TheDenizhan/-HA-TEKNOFEST/KTR TASARIM/FOTO/DIŞ KABUK.PNG

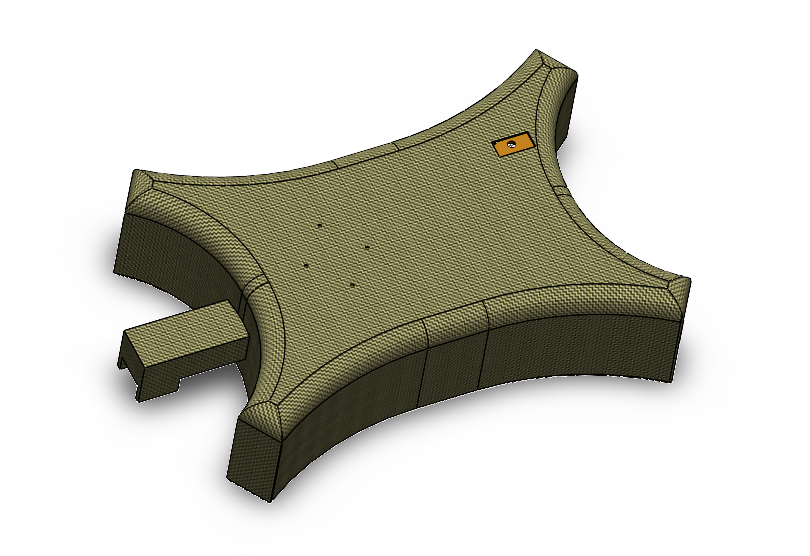
KTR TASARIM/FOTO/DIŞ KABUK.PNG
