TheDenizhan/-HA-TEKNOFEST/KTR TASARIM/FOTO/SS.PNG

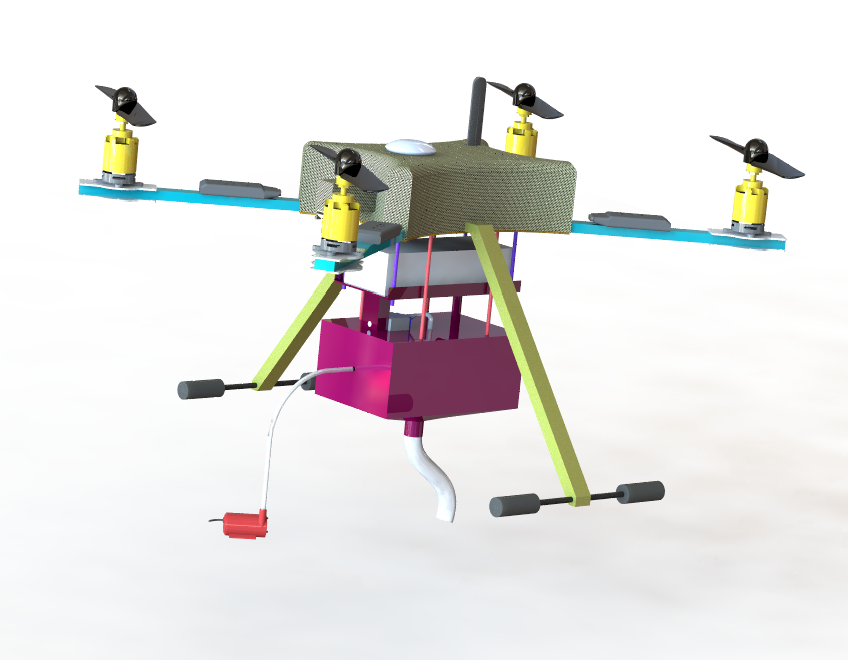
KTR TASARIM/FOTO/SS.PNG
