TheDenizhan/-HA-TEKNOFEST/KTR TASARIM/FOTO/KESİT GÖREV MEKANİZMASI.docx

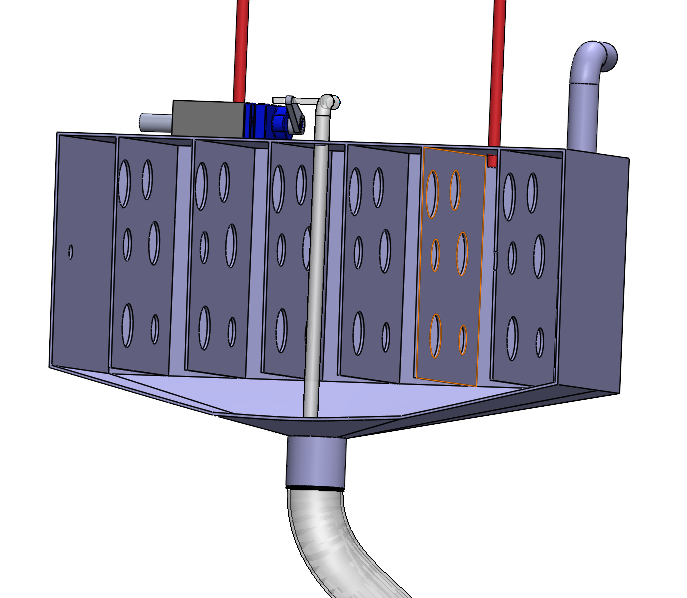
[picture p3: figure]

SU BOŞALTIM BOŞLUĞU

MİL

SU ALMA BOŞLUĞU

SERVO MOTOR

HAVA DELİĞİ

PERDE
