TheDenizhan/-HA-TEKNOFEST/İHA.pptx

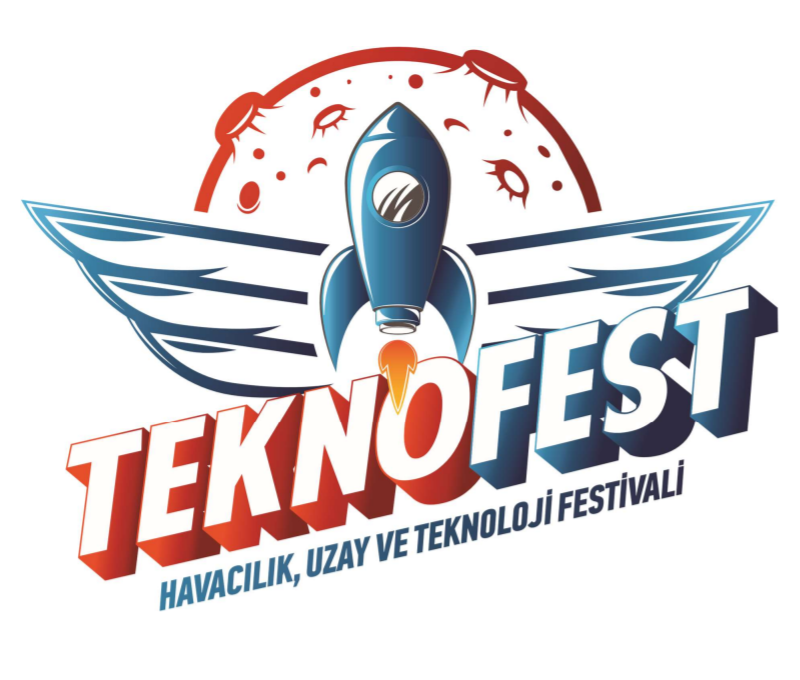
[picture p23: figure]

## Slide 2

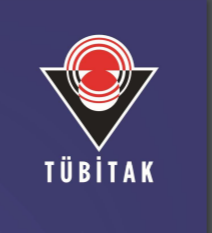
[picture p24: figure]

ULUSLARARASI İNSANSIZ HAVA ARAÇLARI YARIŞMASI

## Slide 3

1.YARIŞMA TAKVİMİ

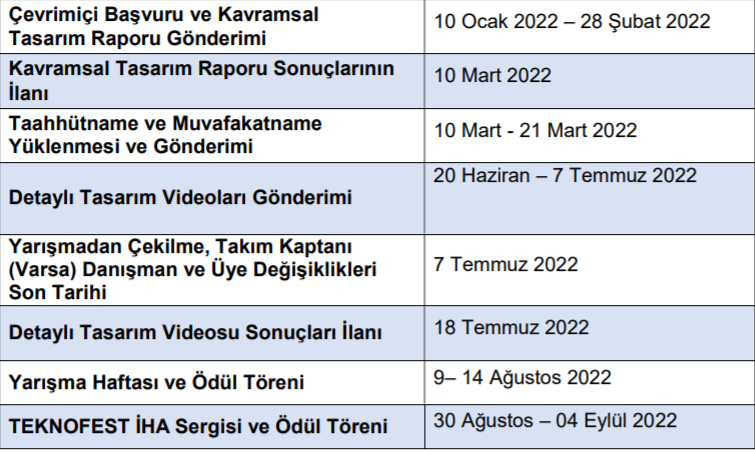
[picture p25: figure]

## DÖNER KANATLI İNSANSIZ HAVA ARACI

## Slide 5

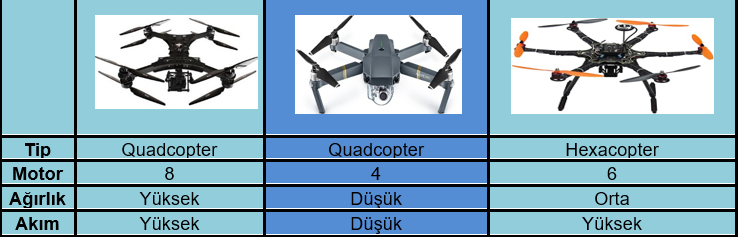
[picture p26: figure]

## görevler

## Görev süreleri: 1.Hazırlık süresi her görev için en fazla üç (3) dakika 2.Görev-1 için beş (5) dakika 3.Görev-2 için yedi (7) dakika olarak belirlenmiştir.

## Slide 8

1.GÖREV

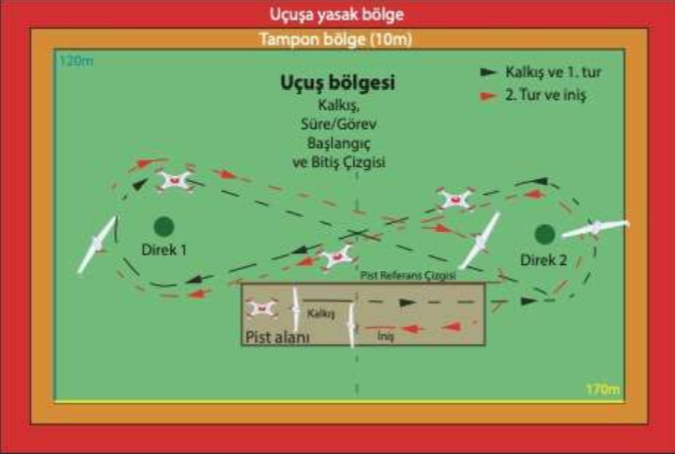
[picture p27: figure]
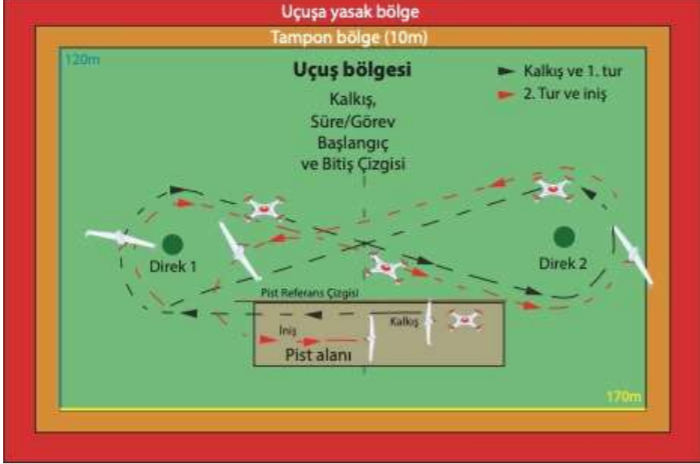
[picture p28: figure]

## Slide 9

2. GÖREV

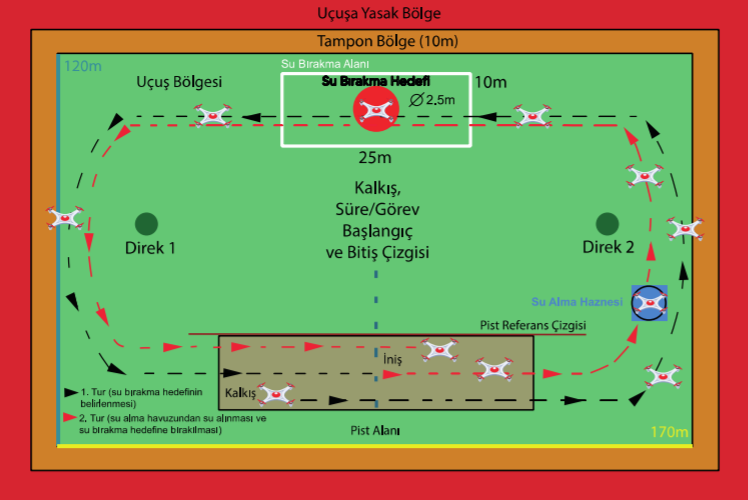
[picture p29: figure]
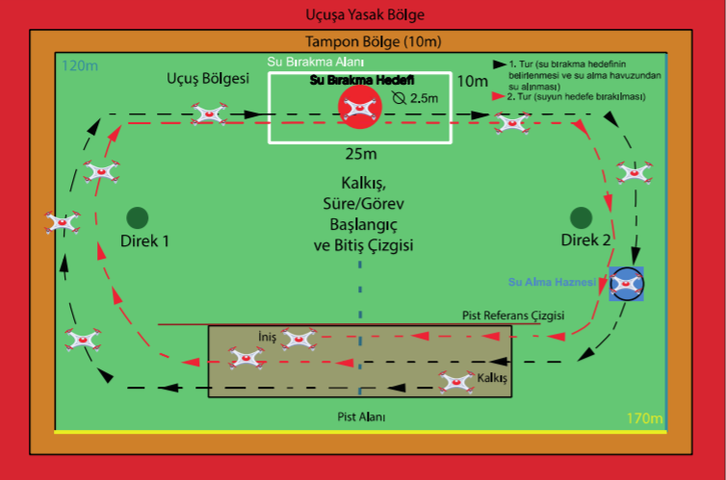
[picture p30: figure]

## puanlama

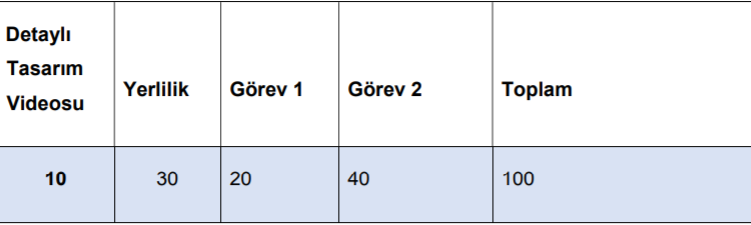
[picture p31: figure]

## Slide 11

Yerlilik ödülünün değerlendirilmesi için dört (4) ana başlık bulunur. Bunlar;
1. Oto Pilot Kart tasarımı ve Yazılımı
2. Kumanda Tasarımı ve Yazılımı
3. ESC Donanım Tasarımı ve Yazılımı
4. Fırçasız (Brushless) Elektrikli Motor Tasarımı ve Uygulaması

## Takım içi görevler

1. TAKIM KAPTANI
2. DANIŞMAN
3. TAKIM KAPTANI DAHİL EN AZ 3 TAKIM ÜYESİ İLE SATIN ALMA EKİBİ

YAPILACAK İŞLER

1. DRONE TASARIMI
2. ALINACAK,KULLANILACAK MALZEMELERİN BELİRLEME
3. YAZILIM
4. DEVRE TASARIMI
5. ÜRÜN SATIN ALMA
