TheDenizhan/-HA-TEKNOFEST/KTR TASARIM/FOTO/pompa.docx

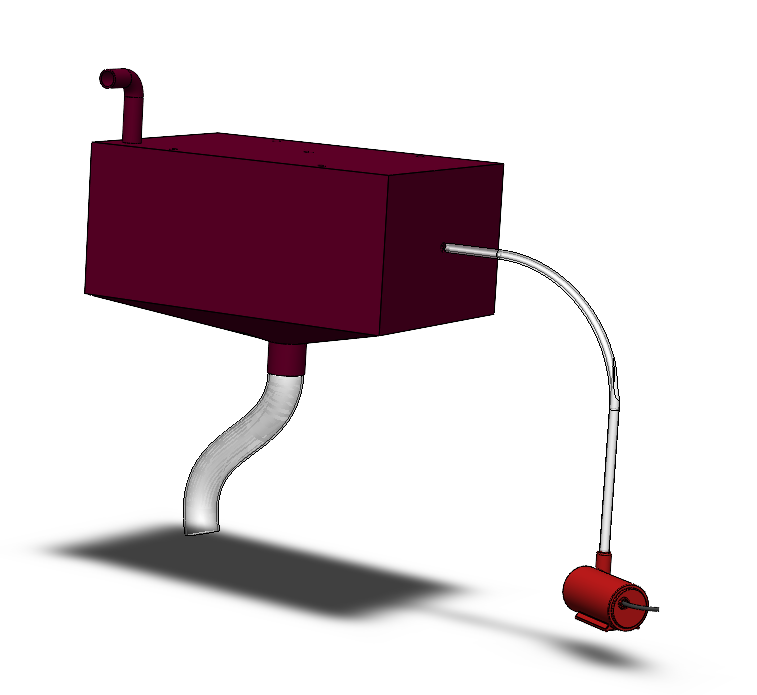
[picture p32: figure]

Su Giriş Borusu

Su Pompası

Su Tahliye Borusu
