TheDenizhan/-HA-TEKNOFEST/İHA Malzeme listesi/ABS++ FİLAMENT.png

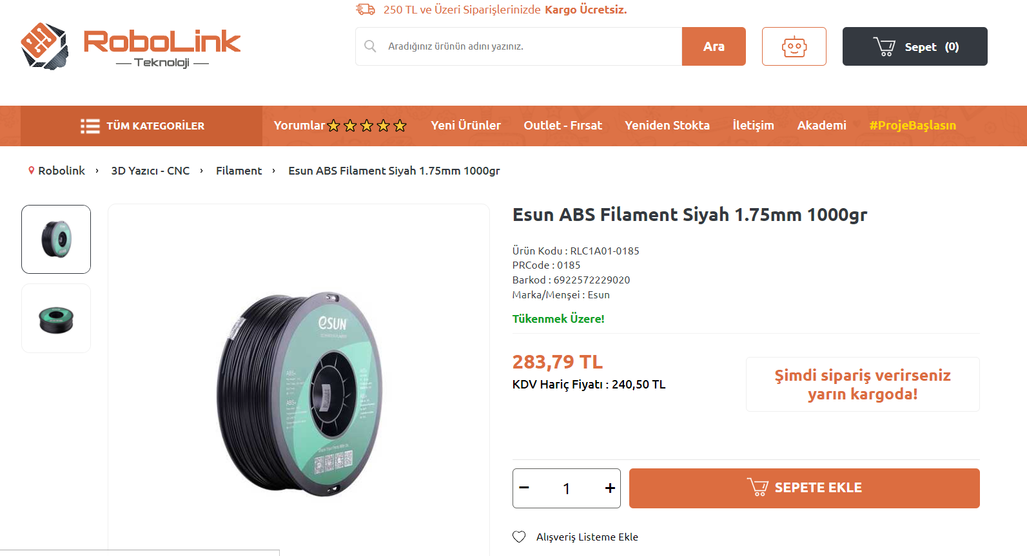
İHA Malzeme listesi/ABS++ FİLAMENT.png
