TheDenizhan/-HA-TEKNOFEST/İHA Malzeme listesi/ARDUNİO NANO.png

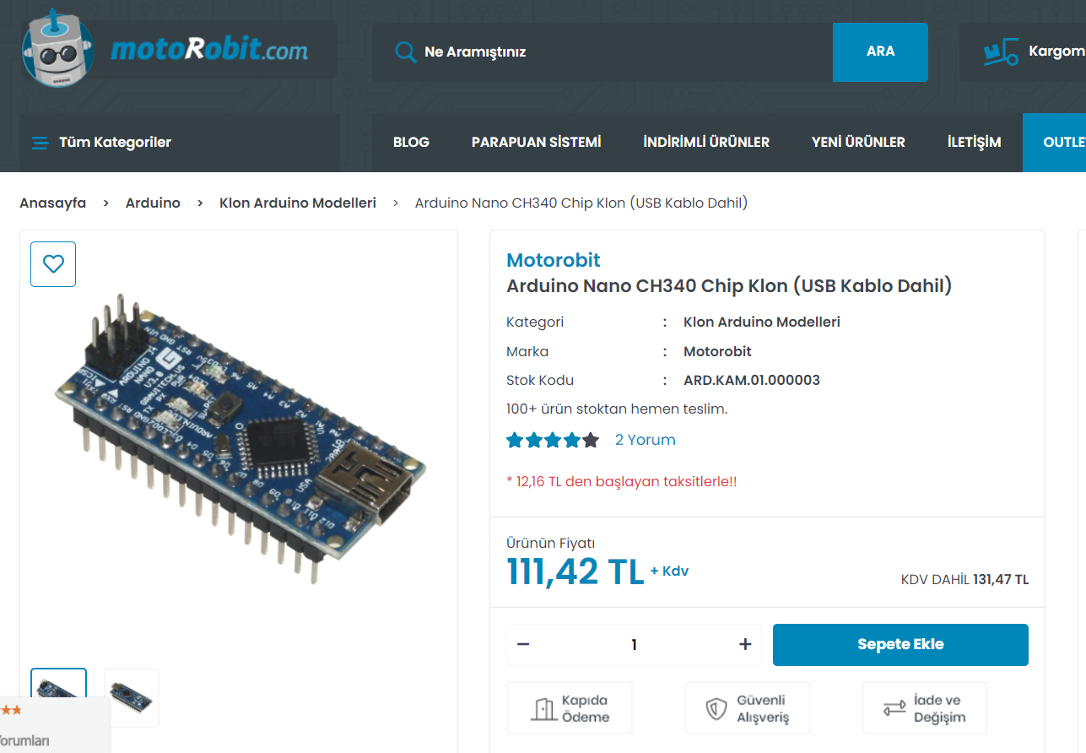
İHA Malzeme listesi/ARDUNİO NANO.png
