TheDenizhan/-HA-TEKNOFEST/İHA Malzeme listesi/ATMEGA2560.png

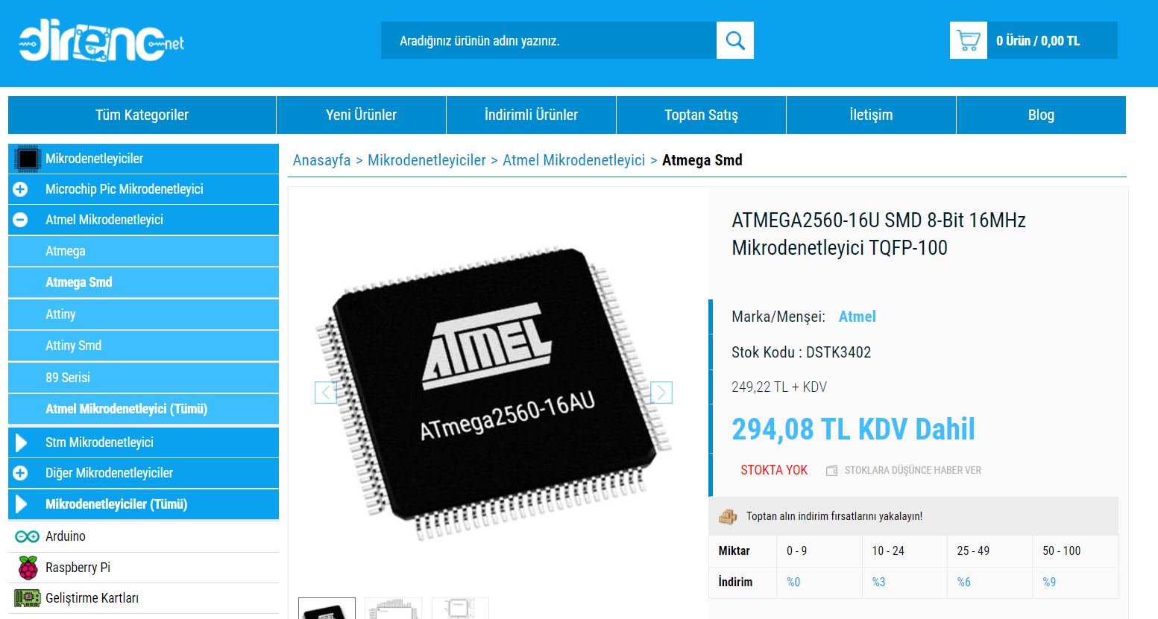
İHA Malzeme listesi/ATMEGA2560.png
