TheDenizhan/-HA-TEKNOFEST/İHA Malzeme listesi/BASINÇ SENSÖRÜ.png

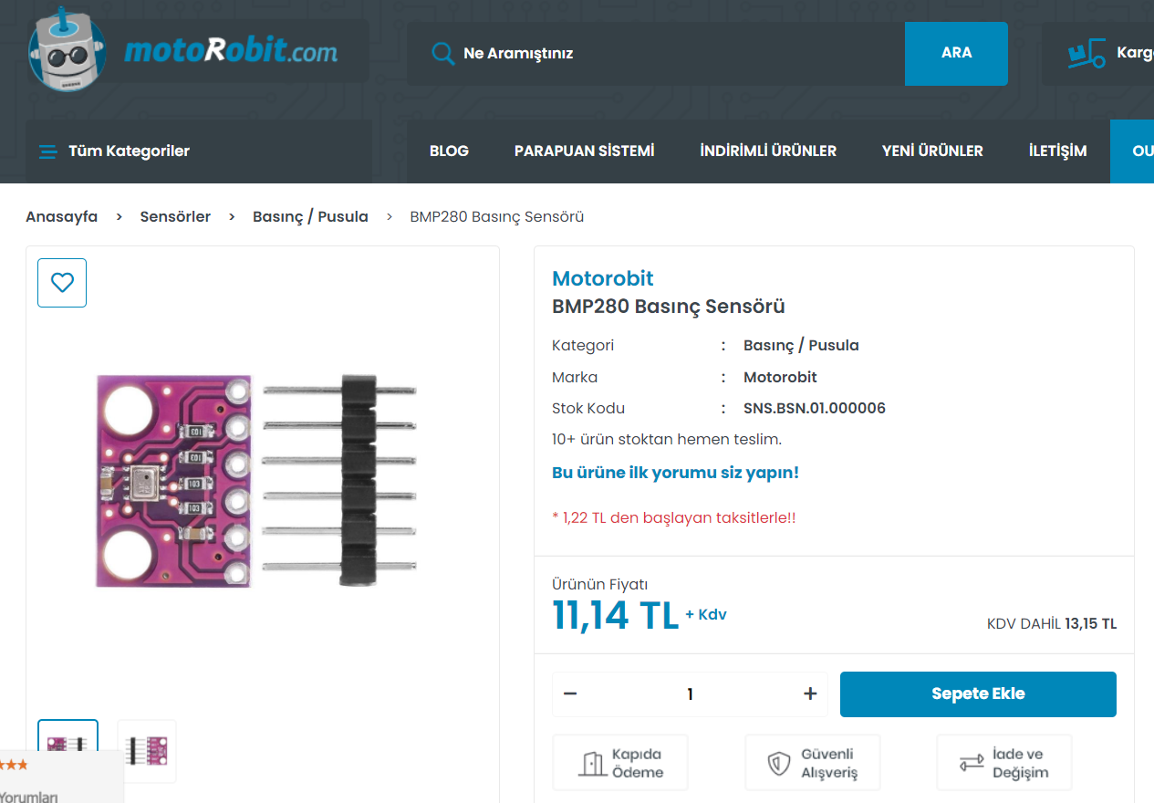
İHA Malzeme listesi/BASINÇ SENSÖRÜ.png
