TheDenizhan/-HA-TEKNOFEST/İHA Malzeme listesi/ESC.png

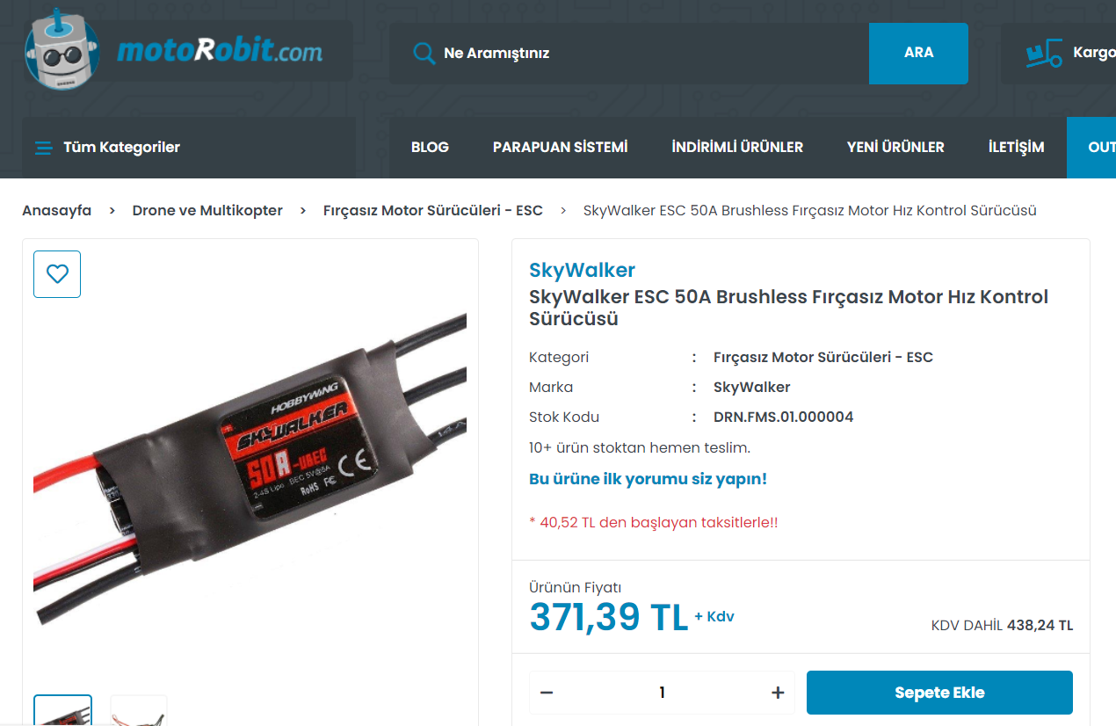
İHA Malzeme listesi/ESC.png
