TheDenizhan/-HA-TEKNOFEST/İHA Malzeme listesi/GPS.png

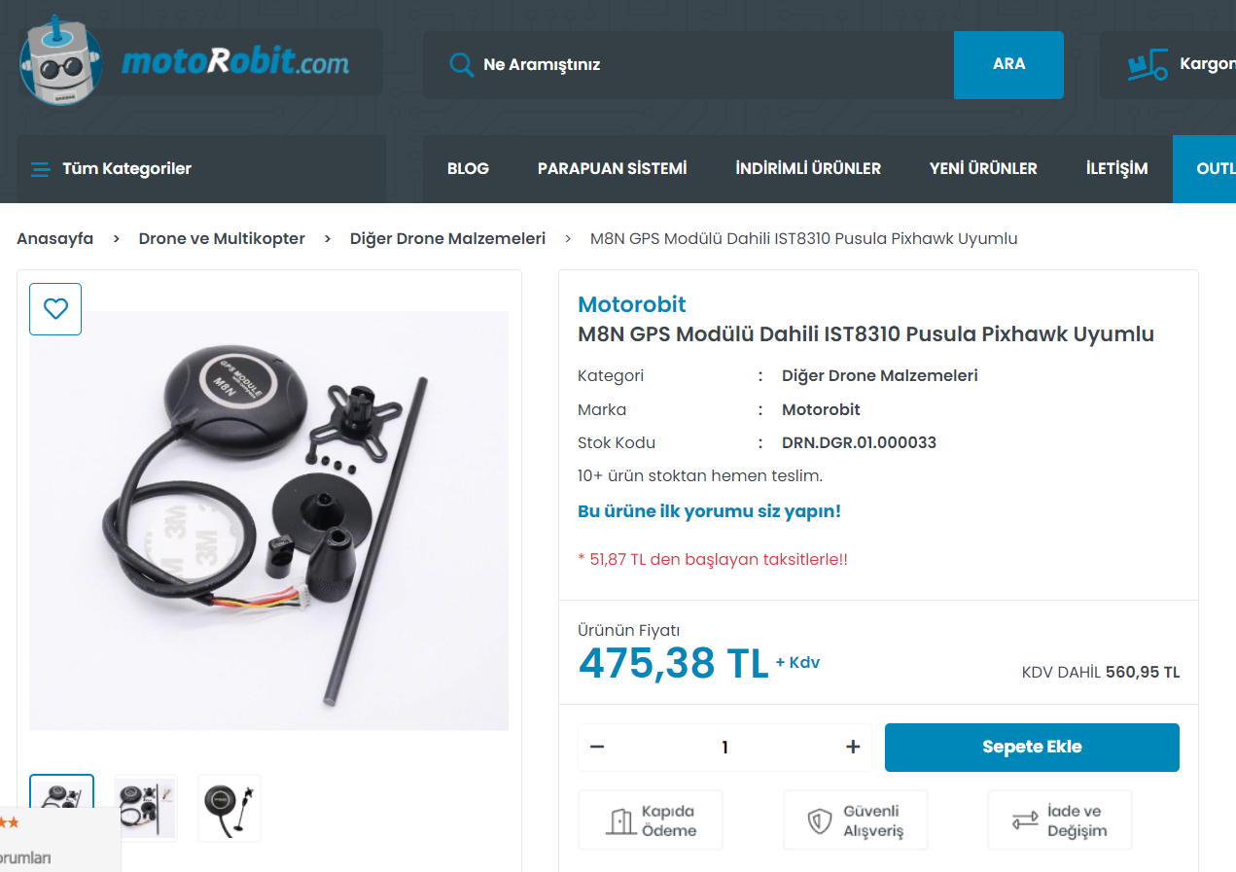
İHA Malzeme listesi/GPS.png
