TheDenizhan/-HA-TEKNOFEST/İHA Malzeme listesi/GYRO.png

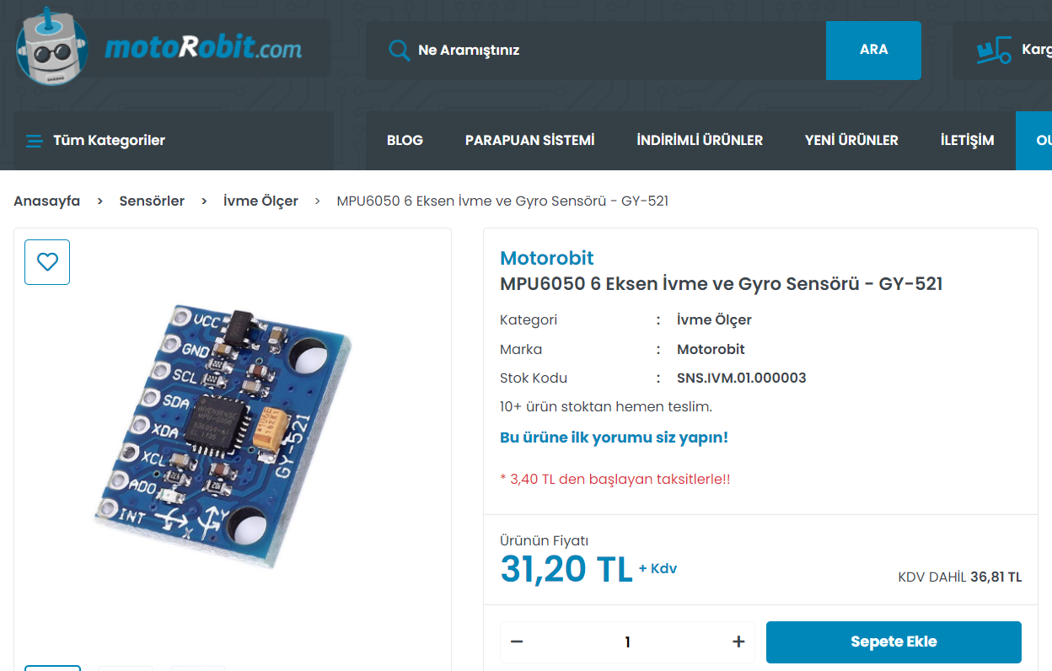
İHA Malzeme listesi/GYRO.png
