TheDenizhan/-HA-TEKNOFEST/İHA Malzeme listesi/GÜÇ DAĞITIM KARTI.png

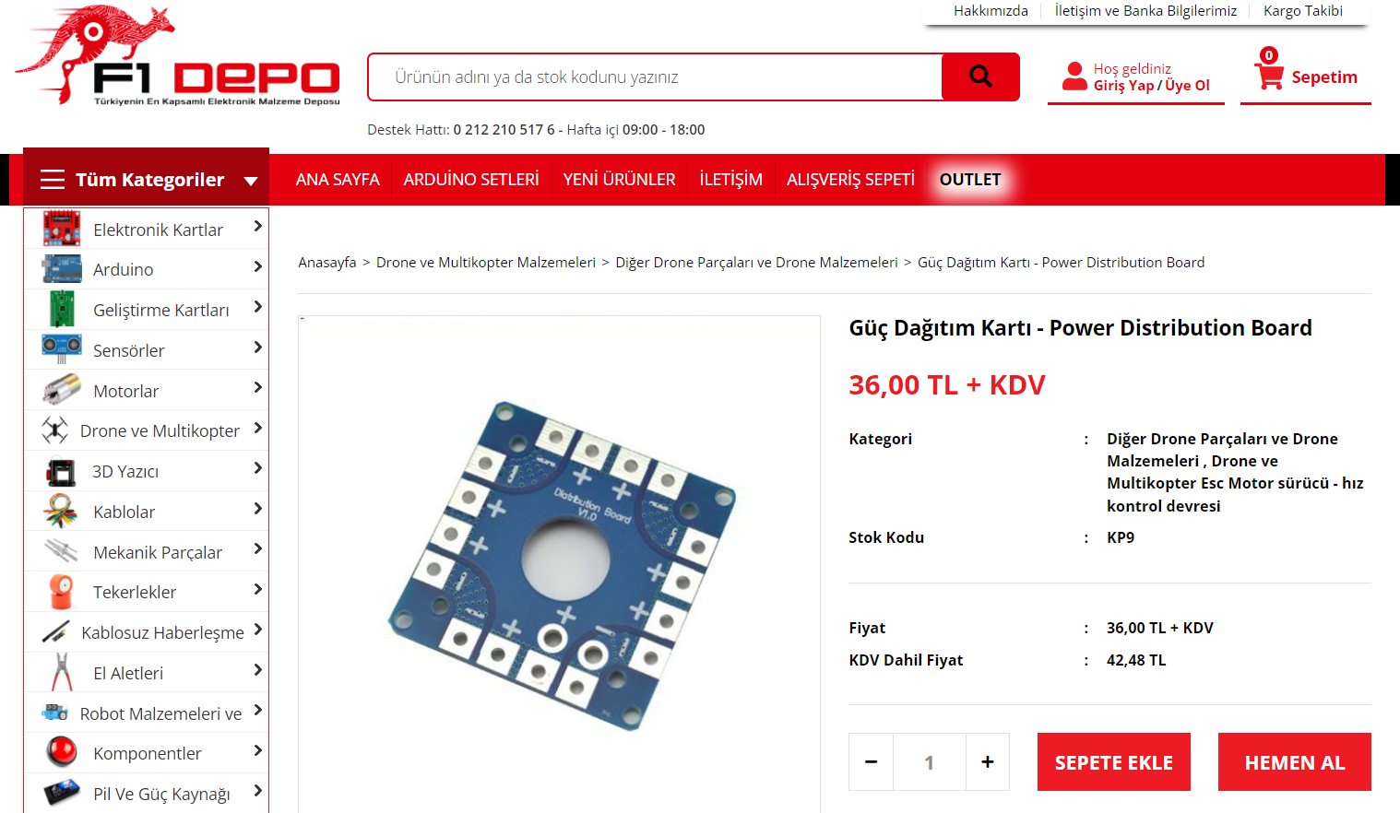
İHA Malzeme listesi/GÜÇ DAĞITIM KARTI.png
