TheDenizhan/-HA-TEKNOFEST/İHA Malzeme listesi/KARBONFİBER PLAKA.png

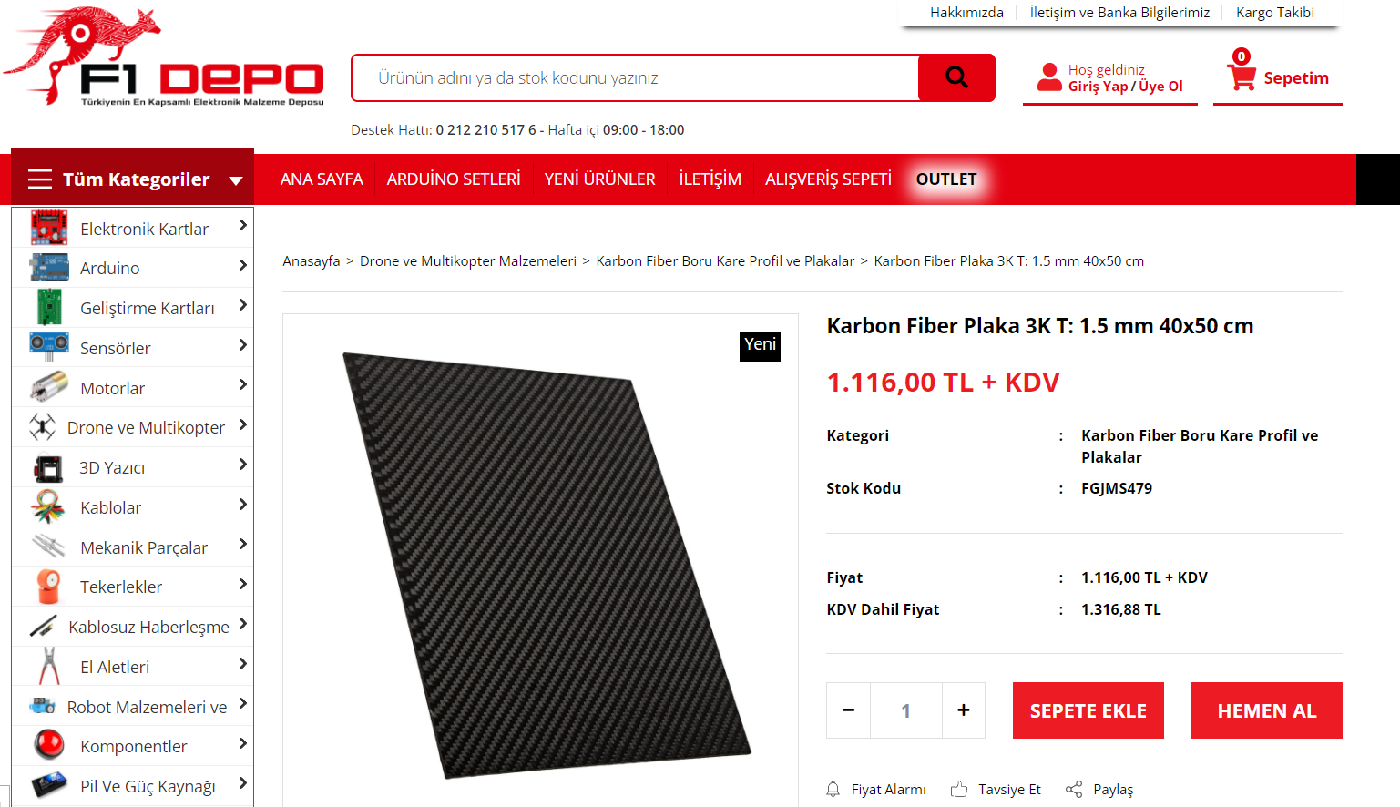
İHA Malzeme listesi/KARBONFİBER PLAKA.png
