TheDenizhan/-HA-TEKNOFEST/İHA Malzeme listesi/KARBONFİBER PROFİL.png

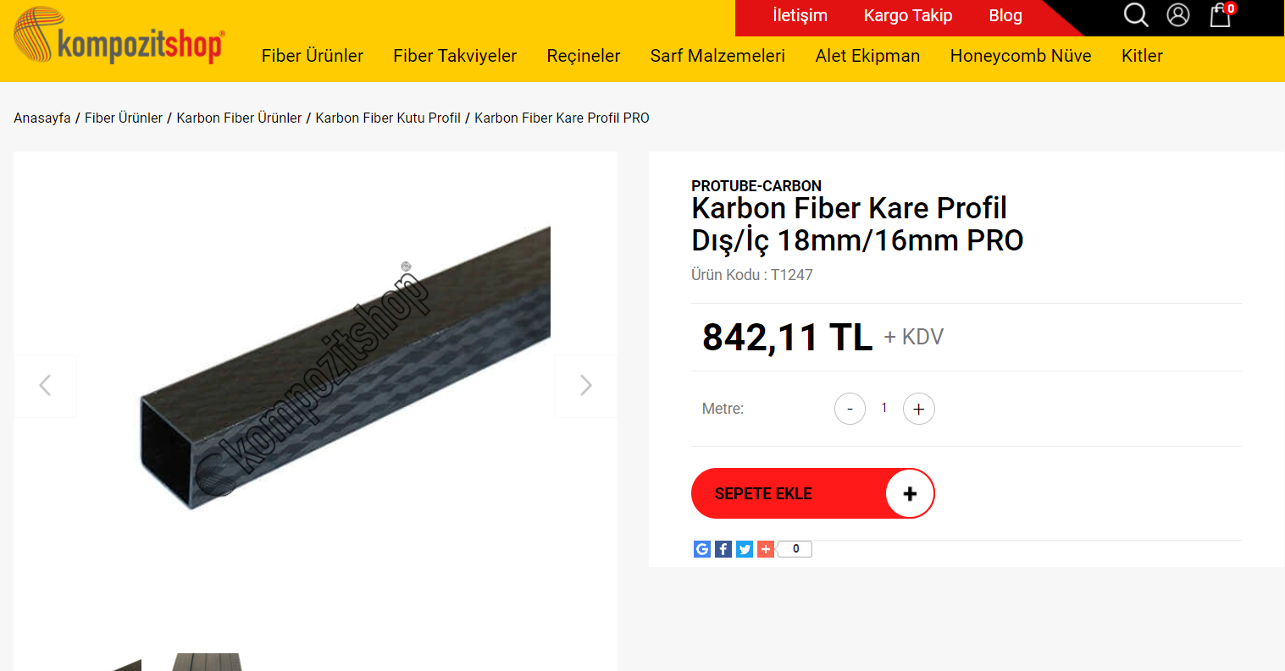
İHA Malzeme listesi/KARBONFİBER PROFİL.png
