TheDenizhan/-HA-TEKNOFEST/İHA Malzeme listesi/KAUÇUK AYAKLIK.png

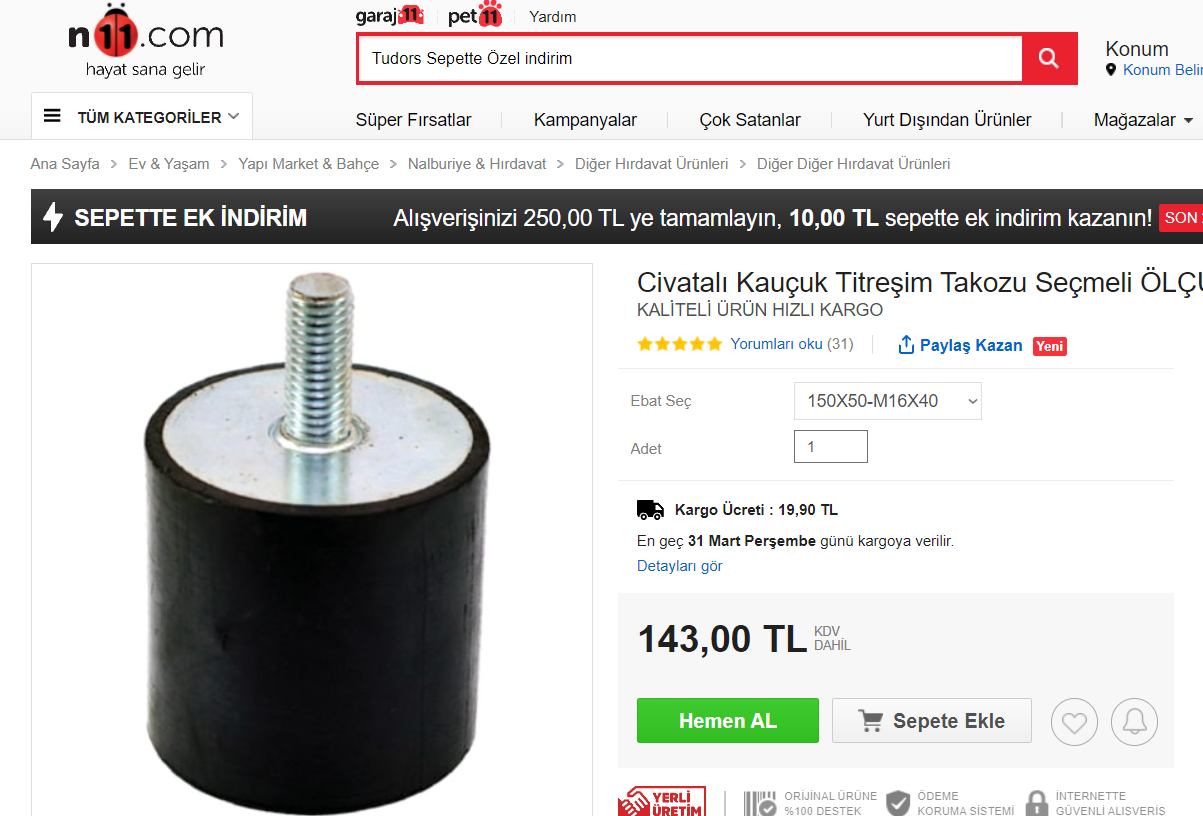
İHA Malzeme listesi/KAUÇUK AYAKLIK.png
