TheDenizhan/-HA-TEKNOFEST/İHA Malzeme listesi/LORA İLETİŞİM MODÜLÜ.png

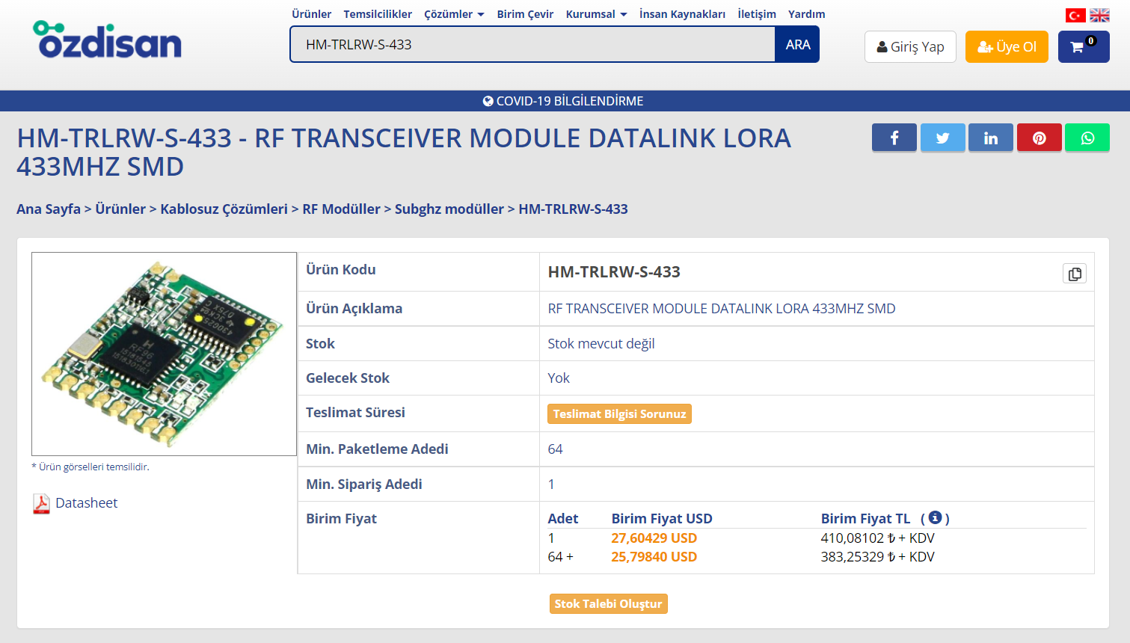
İHA Malzeme listesi/LORA İLETİŞİM MODÜLÜ.png
