TheDenizhan/-HA-TEKNOFEST/İHA Malzeme listesi/MİNİ PROGRAMLAYICI.png

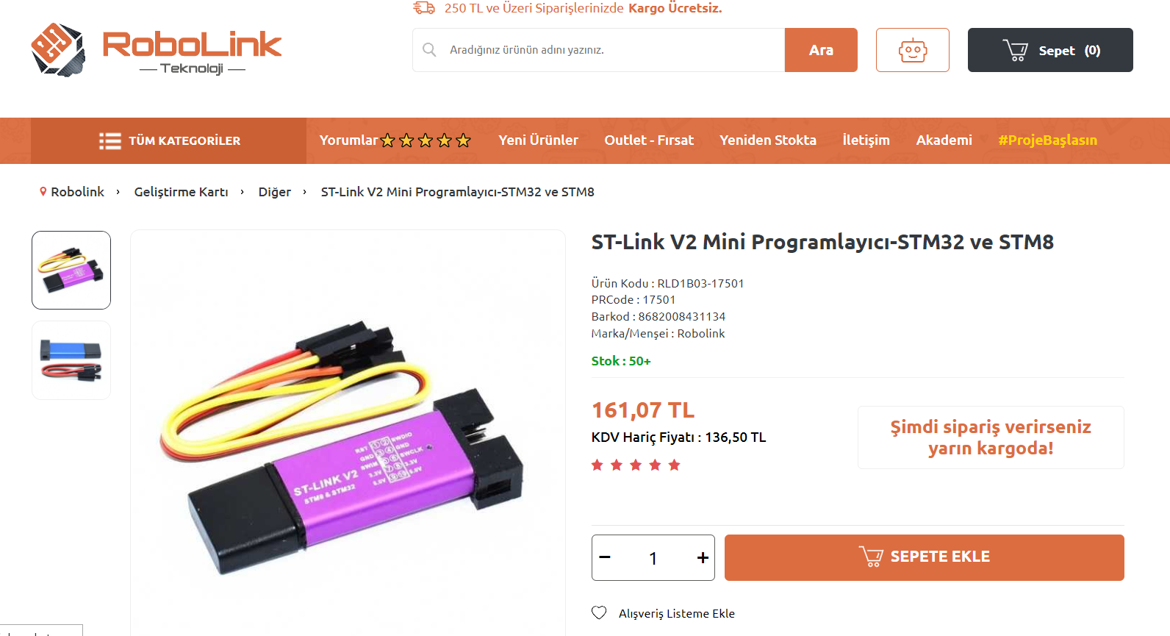
İHA Malzeme listesi/MİNİ PROGRAMLAYICI.png
