TheDenizhan/-HA-TEKNOFEST/İHA Malzeme listesi/MOTOR.png

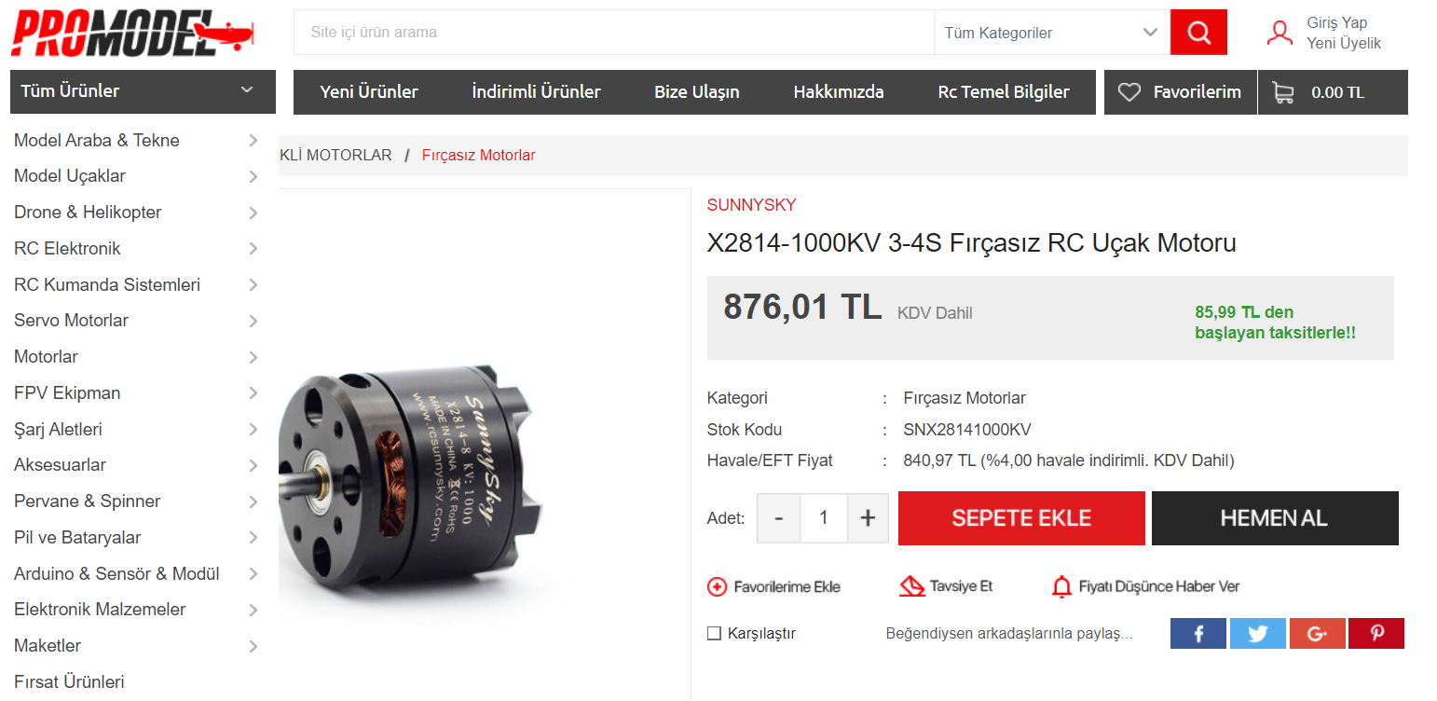
İHA Malzeme listesi/MOTOR.png
