TheDenizhan/-HA-TEKNOFEST/İHA Malzeme listesi/PERVANE.png

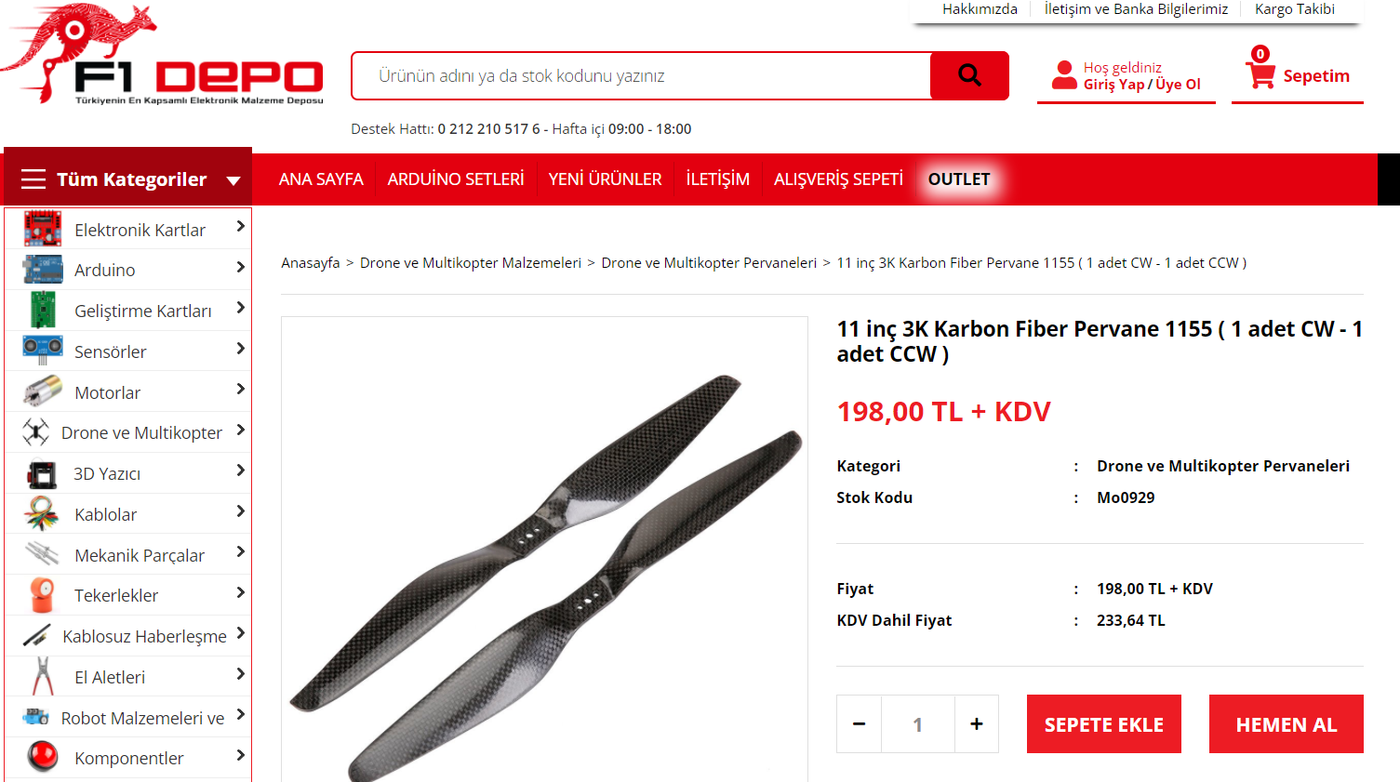
İHA Malzeme listesi/PERVANE.png
