TheDenizhan/-HA-TEKNOFEST/İHA Malzeme listesi/PİL.png

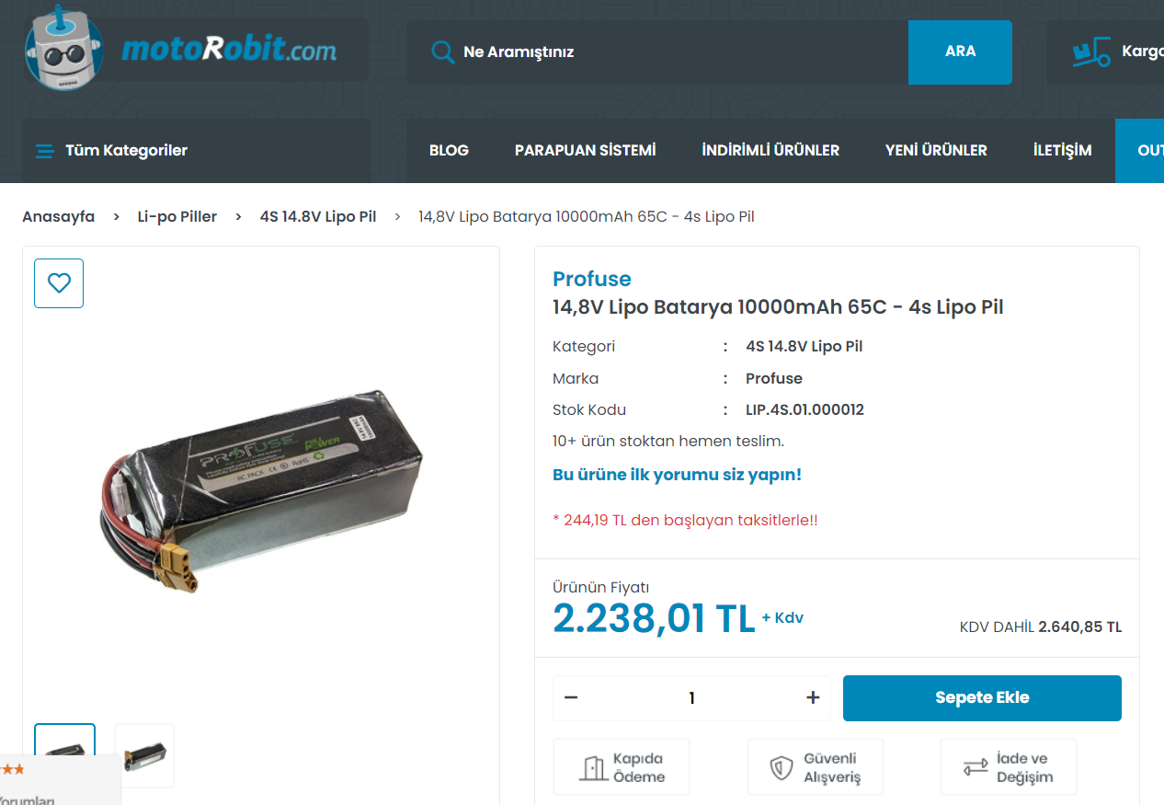
İHA Malzeme listesi/PİL.png
