TheDenizhan/-HA-TEKNOFEST/İHA Malzeme listesi/RASPBERRY Pİ 4 8 GB.png

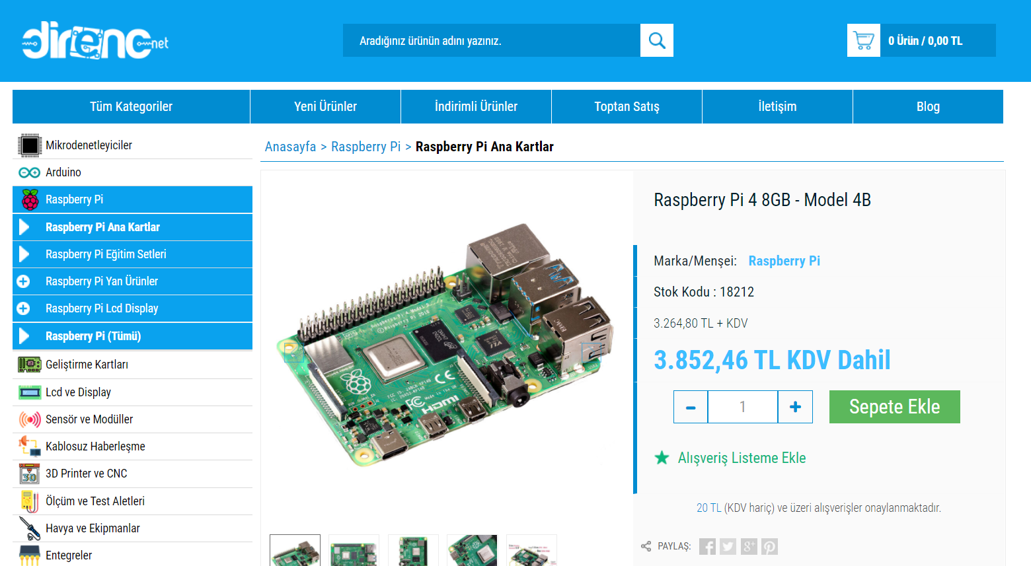
İHA Malzeme listesi/RASPBERRY Pİ 4 8 GB.png
