TheDenizhan/-HA-TEKNOFEST/İHA Malzeme listesi/RASPBERRY Pİ KAMERA.png

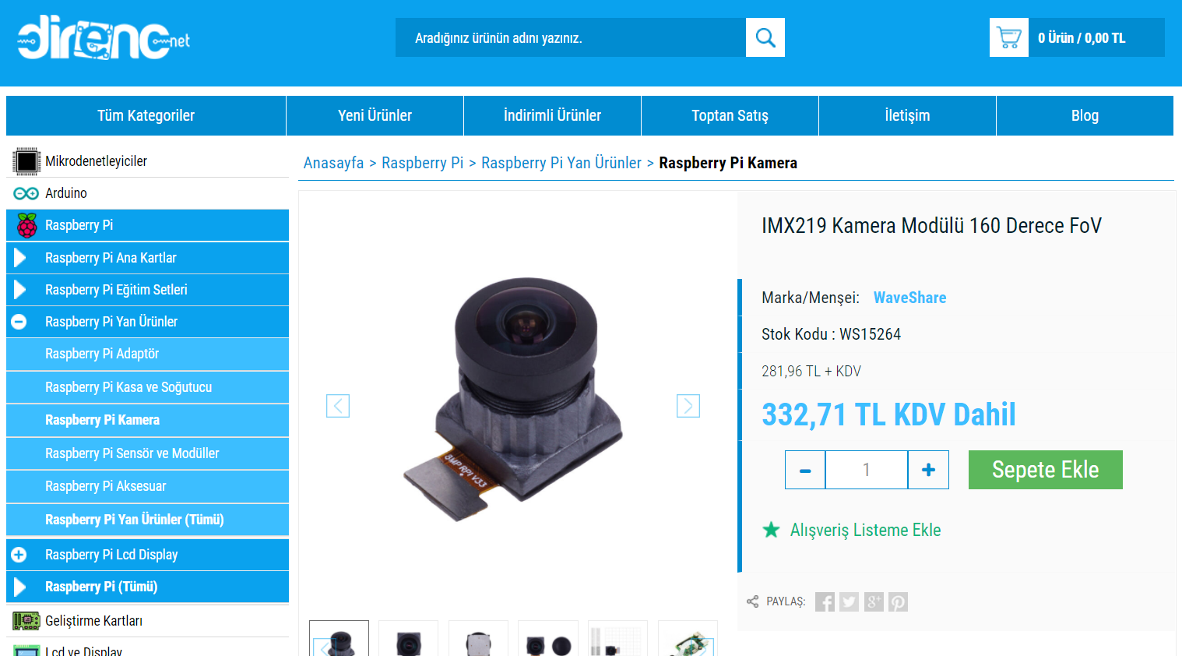
İHA Malzeme listesi/RASPBERRY Pİ KAMERA.png
