TheDenizhan/-HA-TEKNOFEST/İHA Malzeme listesi/SERVO MOTOR.png

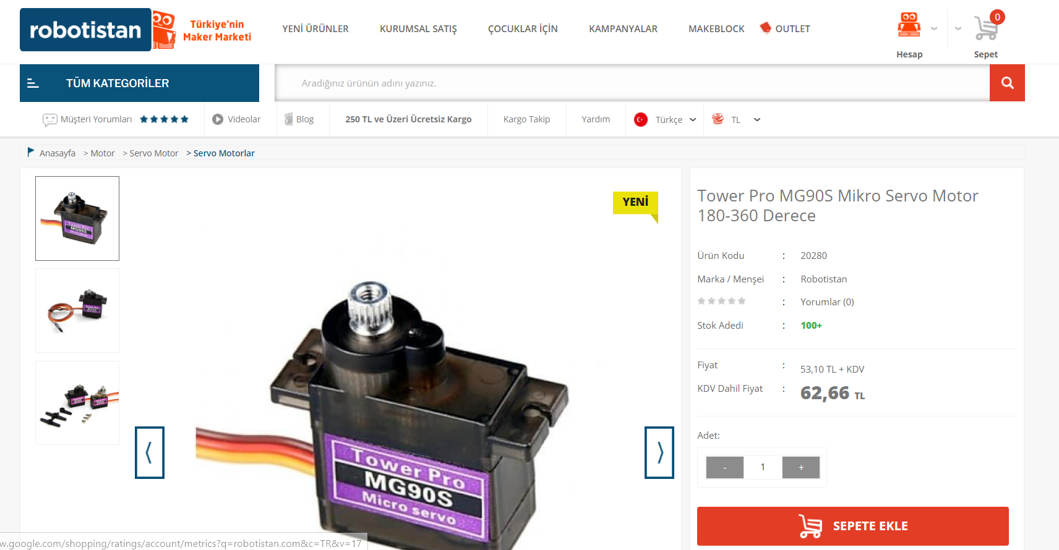
İHA Malzeme listesi/SERVO MOTOR.png
