TheDenizhan/-HA-TEKNOFEST/İHA Malzeme listesi/SİGORTA.png

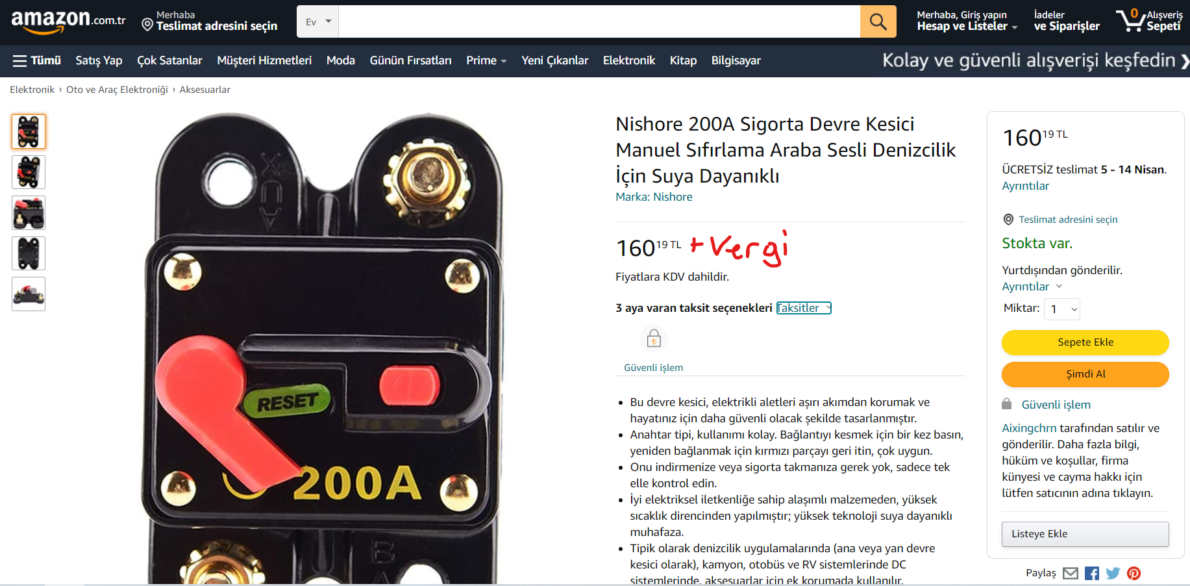
İHA Malzeme listesi/SİGORTA.png
