TheDenizhan/-HA-TEKNOFEST/İHA Malzeme listesi/SONSUZ VİDA.png

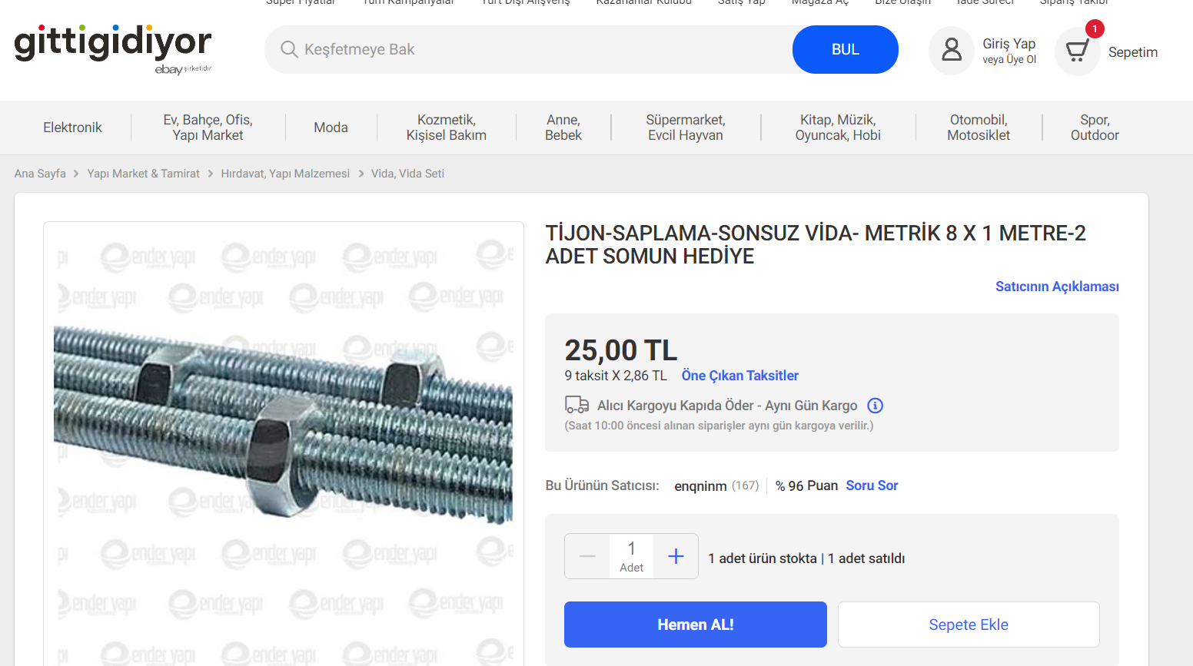
İHA Malzeme listesi/SONSUZ VİDA.png
