TheDenizhan/-HA-TEKNOFEST/İHA Malzeme listesi/STM32F407.png

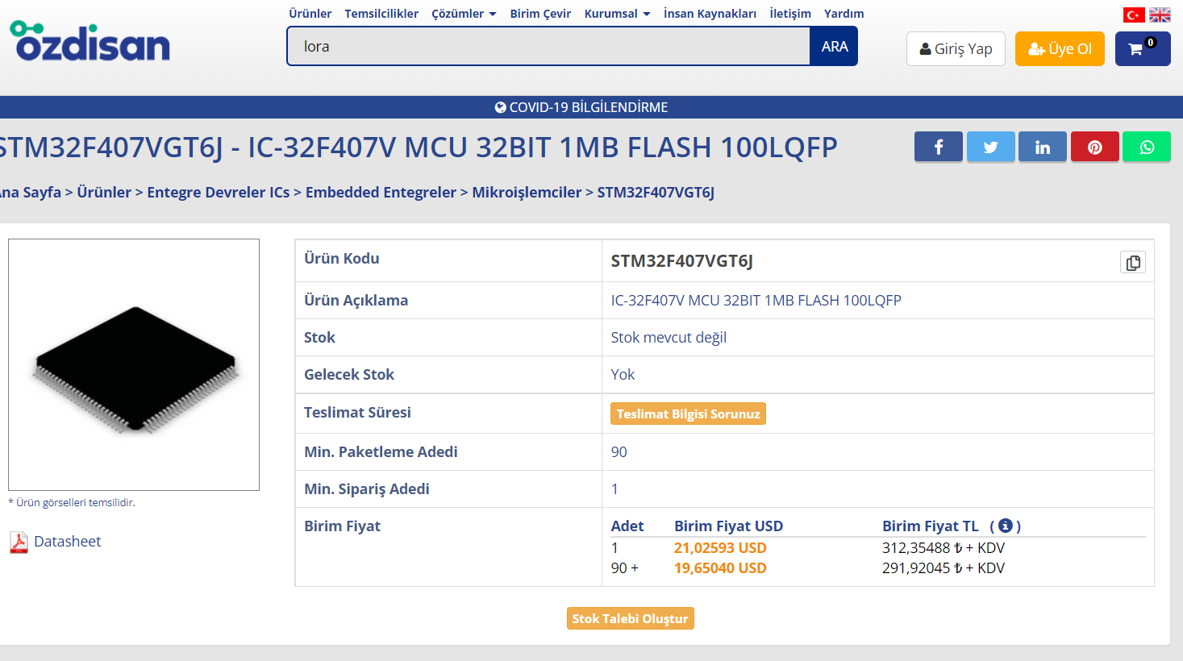
İHA Malzeme listesi/STM32F407.png
