TheDenizhan/-HA-TEKNOFEST/İHA Malzeme listesi/SU POMPASI.png

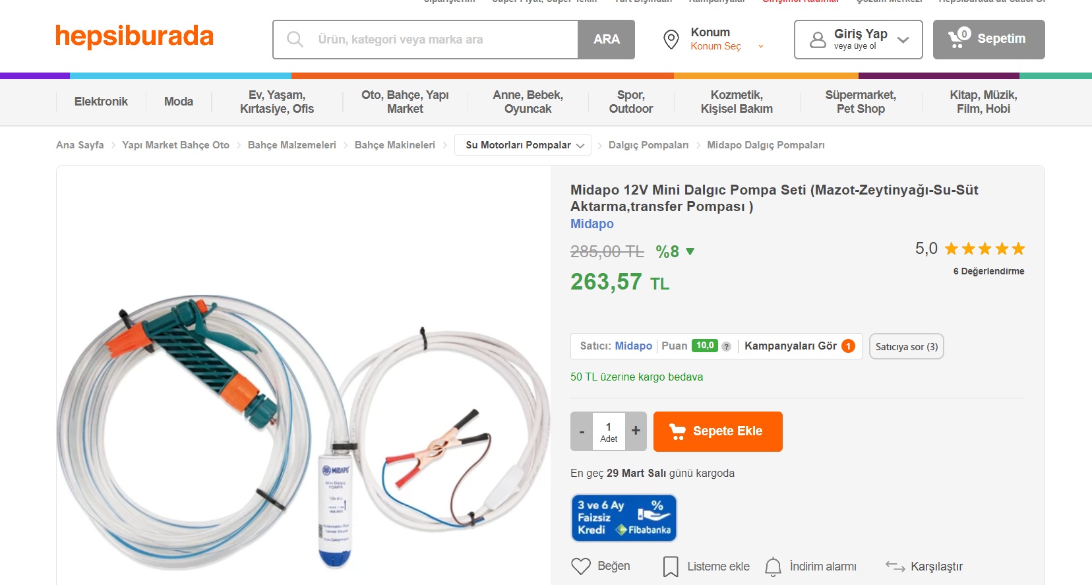
İHA Malzeme listesi/SU POMPASI.png
