TheDenizhan/-HA-TEKNOFEST/İHA Malzeme listesi/TELEMETRİ.png

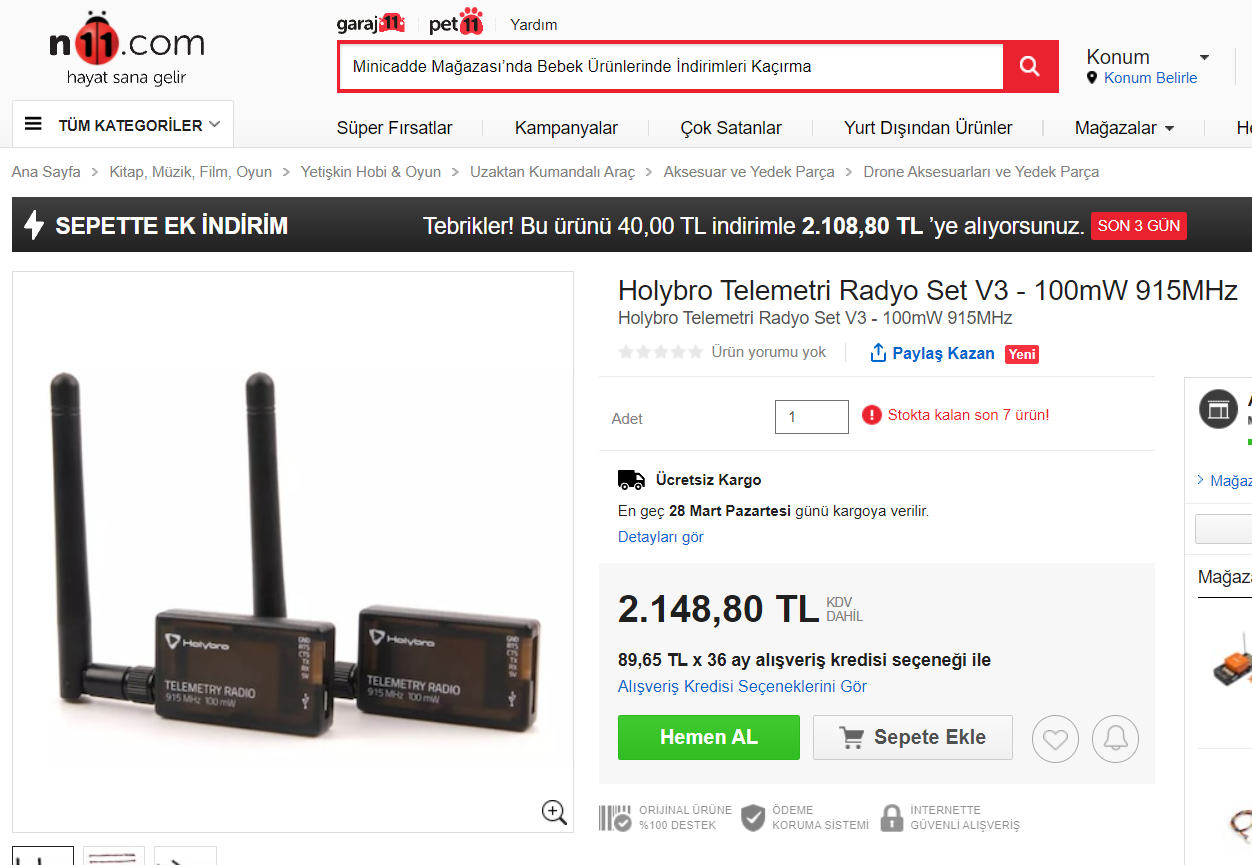
İHA Malzeme listesi/TELEMETRİ.png
