TheDenizhan/-HA-TEKNOFEST/İHA Malzeme listesi/TIPA.png

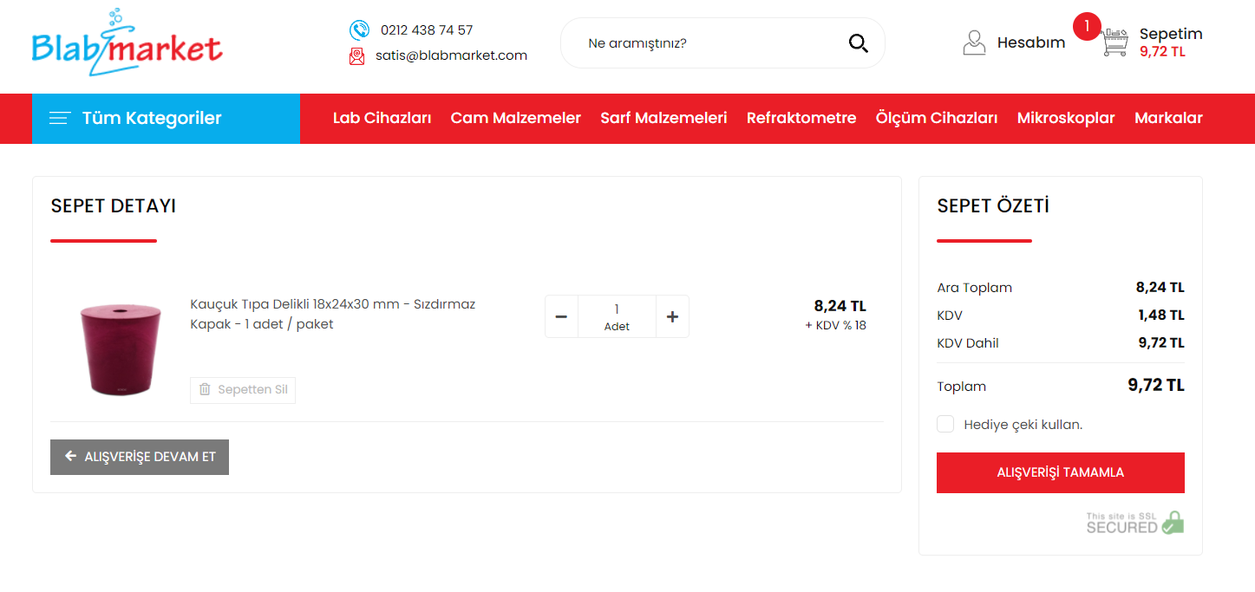
İHA Malzeme listesi/TIPA.png
