TheDenizhan/-HA-TEKNOFEST/İHA Malzeme listesi/UÇUŞ KONTROL KARTI KOMPANENTLERİ.png

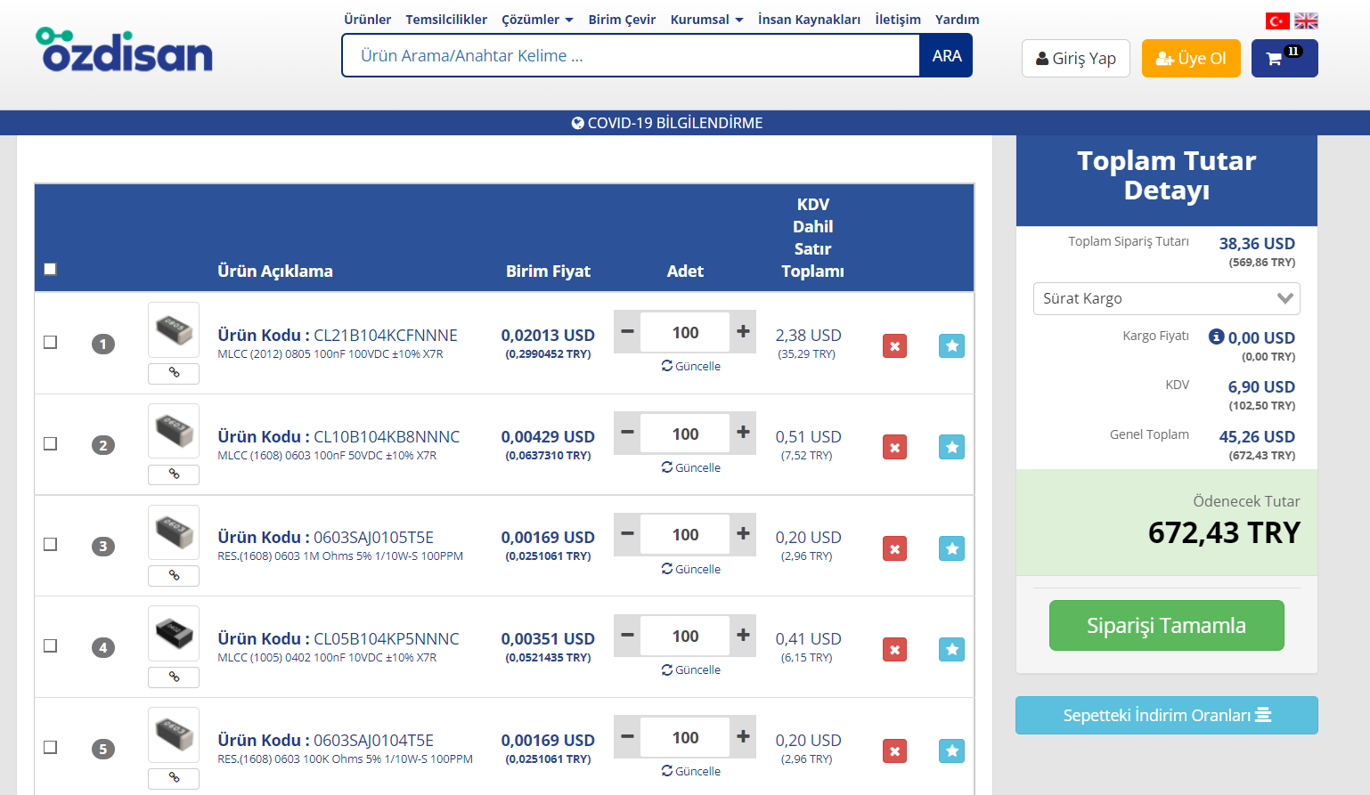
İHA Malzeme listesi/UÇUŞ KONTROL KARTI KOMPANENTLERİ.png
