TheDenizhan/-HA-TEKNOFEST/İHA Malzeme listesi/VOLTAJ SENSÖRÜ.png

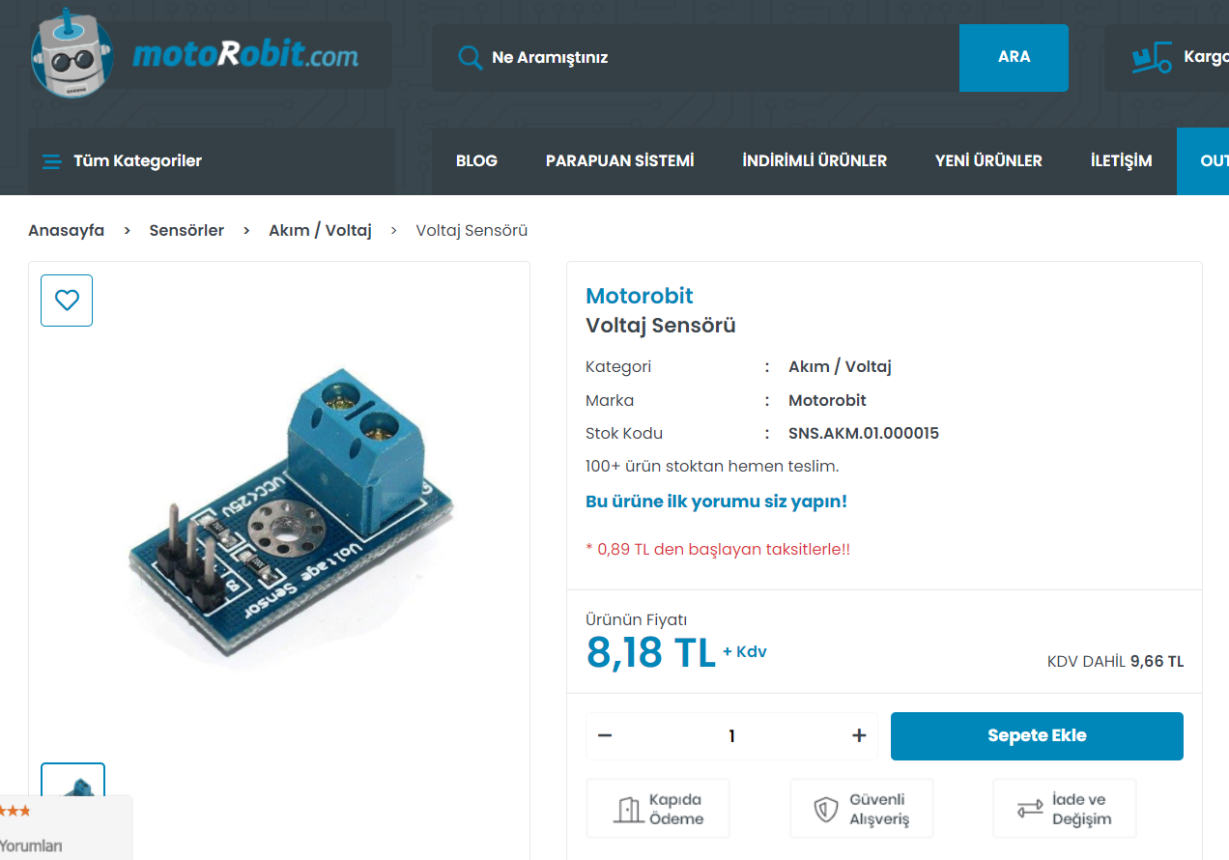
İHA Malzeme listesi/VOLTAJ SENSÖRÜ.png
