TheDenizhan/-HA-TEKNOFEST/KESİT SU DEPOSU.PNG

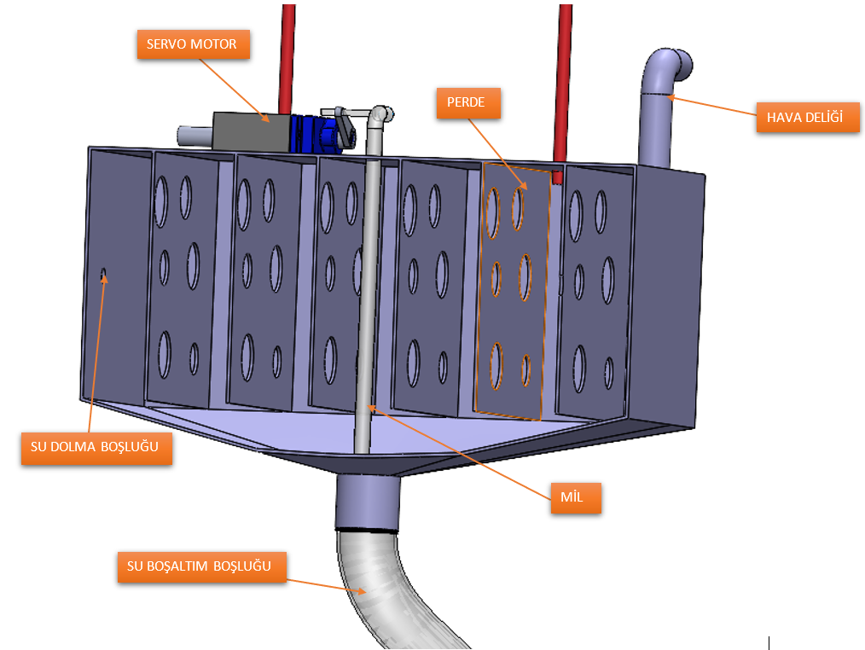
KESİT SU DEPOSU.PNG
