TheDenizhan/-HA-TEKNOFEST/KTR TASARIM/FOTO/ALT ÜST GÖVDE.PNG

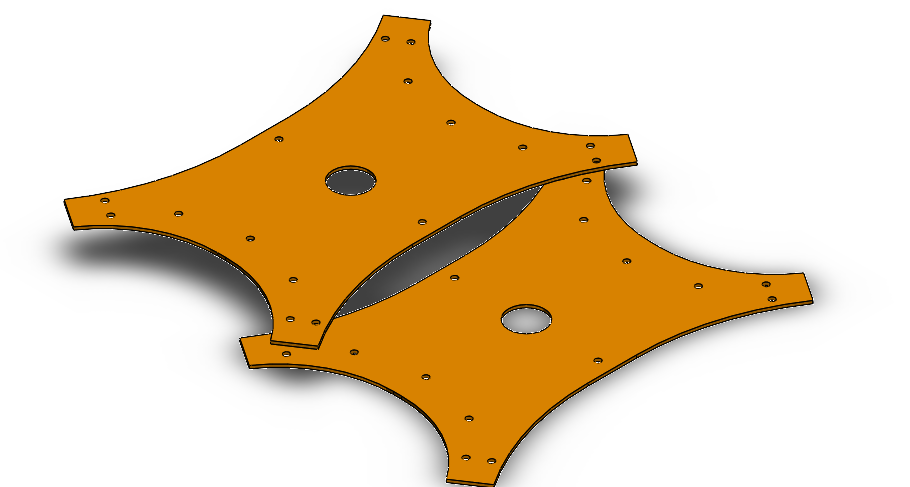
KTR TASARIM/FOTO/ALT ÜST GÖVDE.PNG
