TheDenizhan/-HA-TEKNOFEST/KTR TASARIM/FOTO/AYAK.PNG

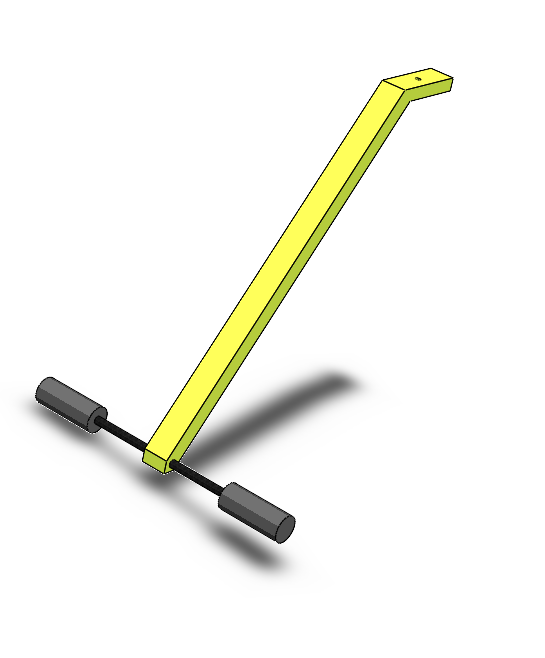
KTR TASARIM/FOTO/AYAK.PNG
