TheDenizhan/-HA-TEKNOFEST/KTR TASARIM/FOTO/EDE-FLY.png

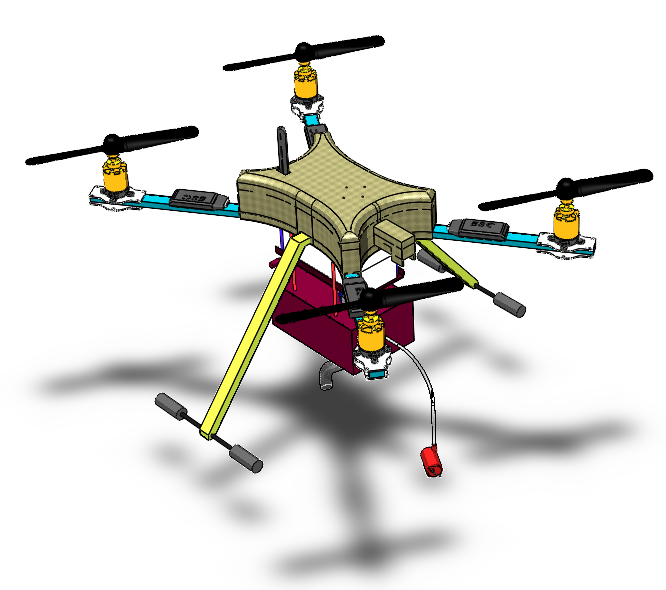
KTR TASARIM/FOTO/EDE-FLY.png
