TheDenizhan/-HA-TEKNOFEST/KTR TASARIM/FOTO/GÖREV MEJANİZMASI1.PNG

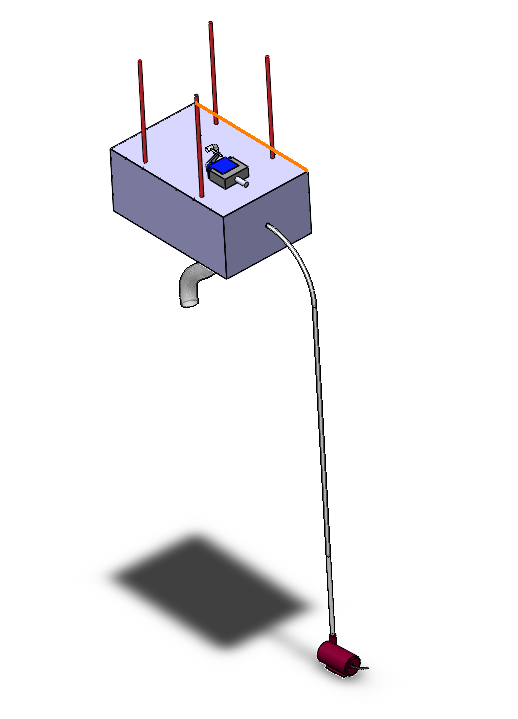
KTR TASARIM/FOTO/GÖREV MEJANİZMASI1.PNG
