TheDenizhan/-HA-TEKNOFEST/KTR TASARIM/FOTO/görev mekanizması kesit.PNG

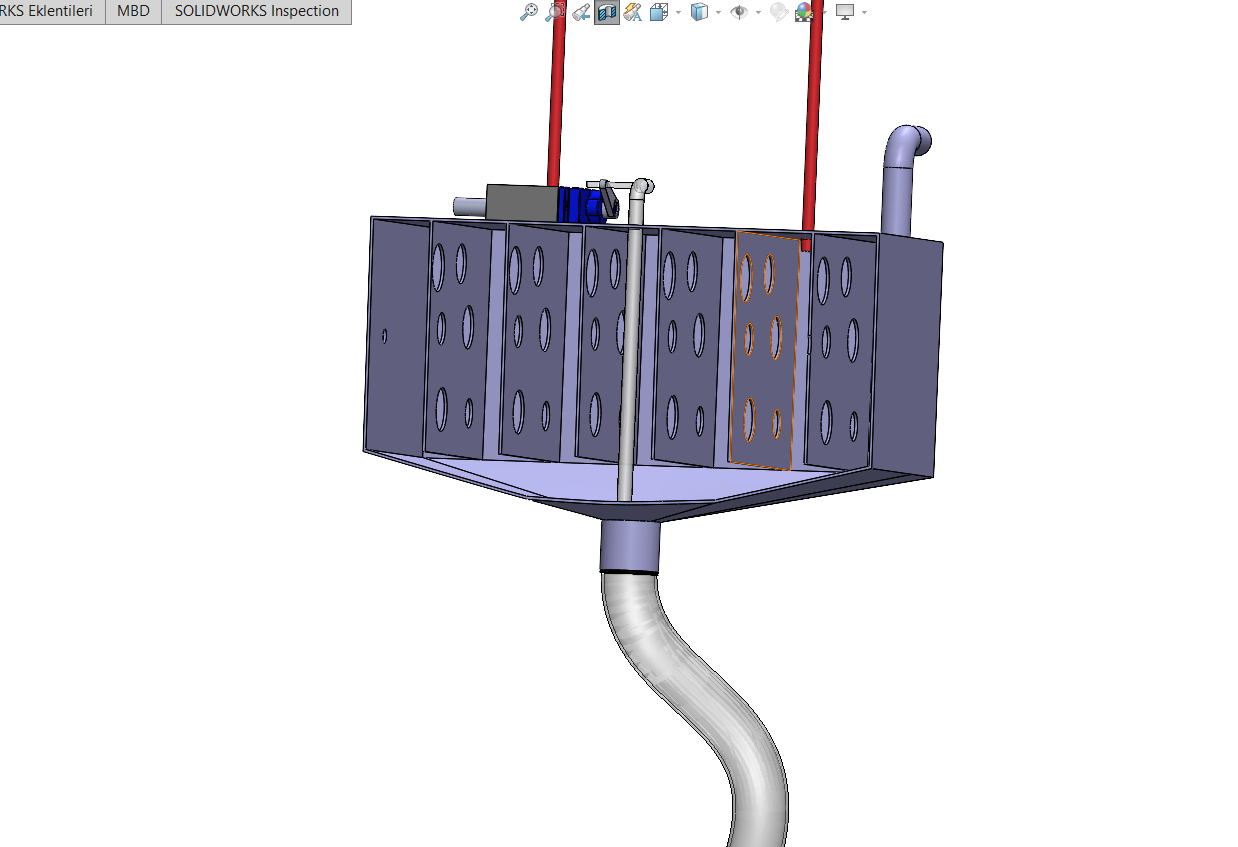
KTR TASARIM/FOTO/görev mekanizması kesit.PNG
