TheDenizhan/-HA-TEKNOFEST/KTR TASARIM/FOTO/GÖREV MEKANİZMASI REVİZE.PNG

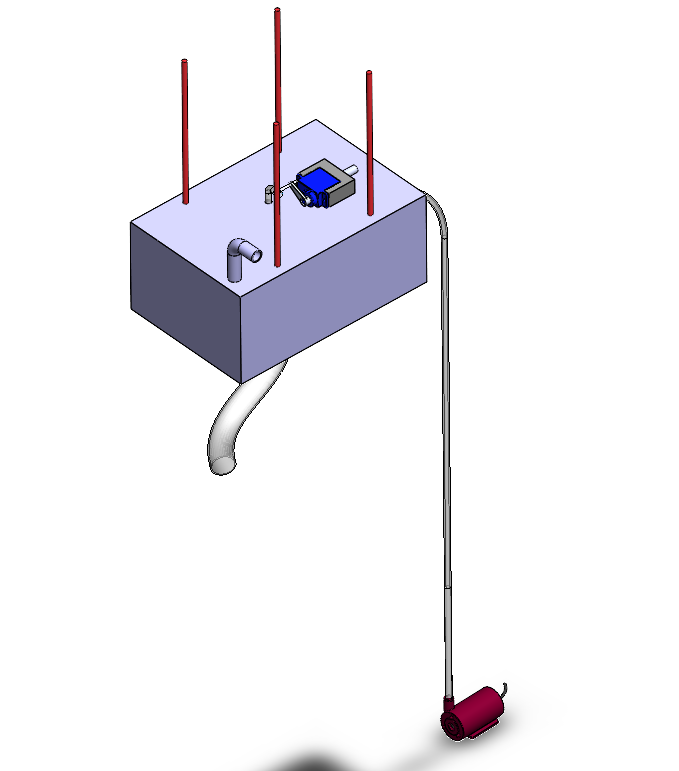
KTR TASARIM/FOTO/GÖREV MEKANİZMASI REVİZE.PNG
