TheDenizhan/-HA-TEKNOFEST/KTR TASARIM/FOTO/gövde.PNG

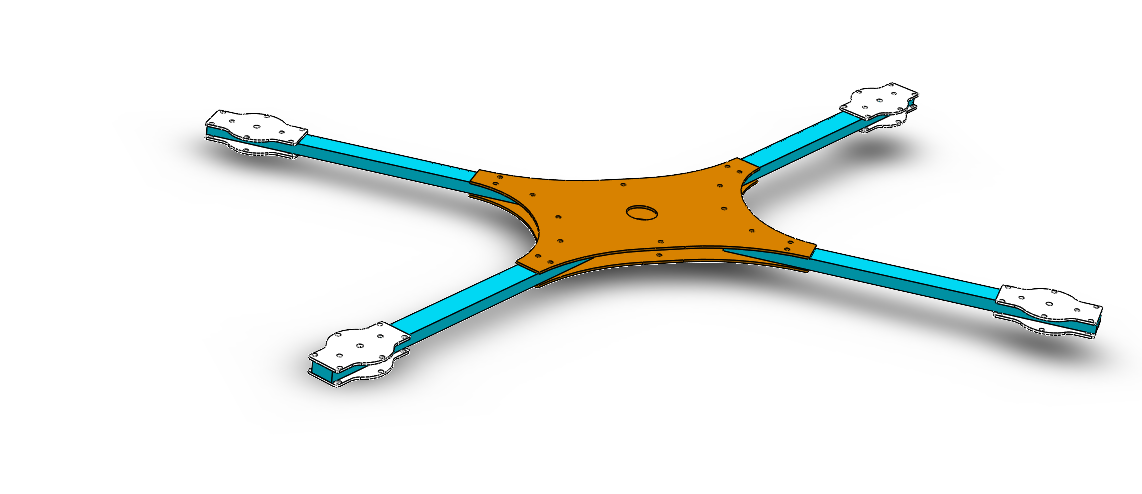
KTR TASARIM/FOTO/gövde.PNG
