TheDenizhan/-HA-TEKNOFEST/KTR TASARIM/FOTO/izometrik3.PNG

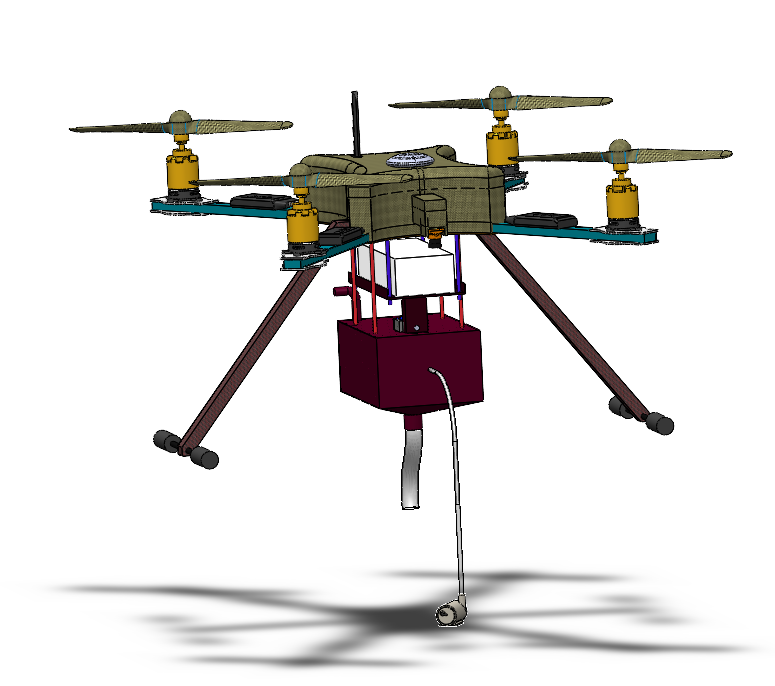
KTR TASARIM/FOTO/izometrik3.PNG
