TheDenizhan/-HA-TEKNOFEST/KTR TASARIM/FOTO/izometrik 1.PNG

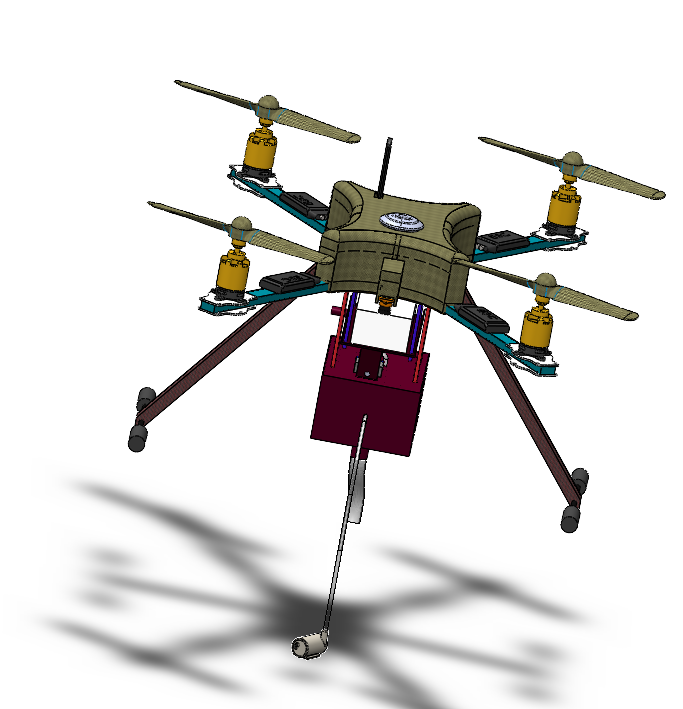
KTR TASARIM/FOTO/izometrik 1.PNG
