TheDenizhan/-HA-TEKNOFEST/KTR TASARIM/FOTO/izometrik 2.PNG

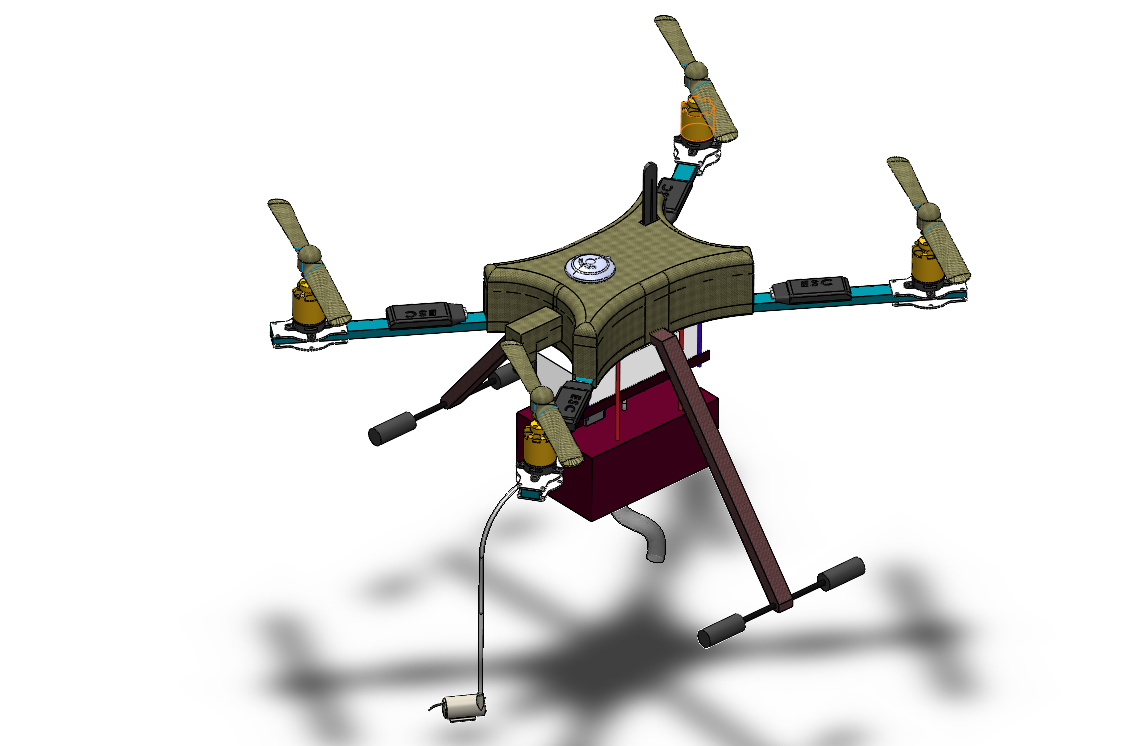
KTR TASARIM/FOTO/izometrik 2.PNG
