TheDenizhan/-HA-TEKNOFEST/KTR TASARIM/FOTO/İHA FOTOĞRAFLAR.PNG

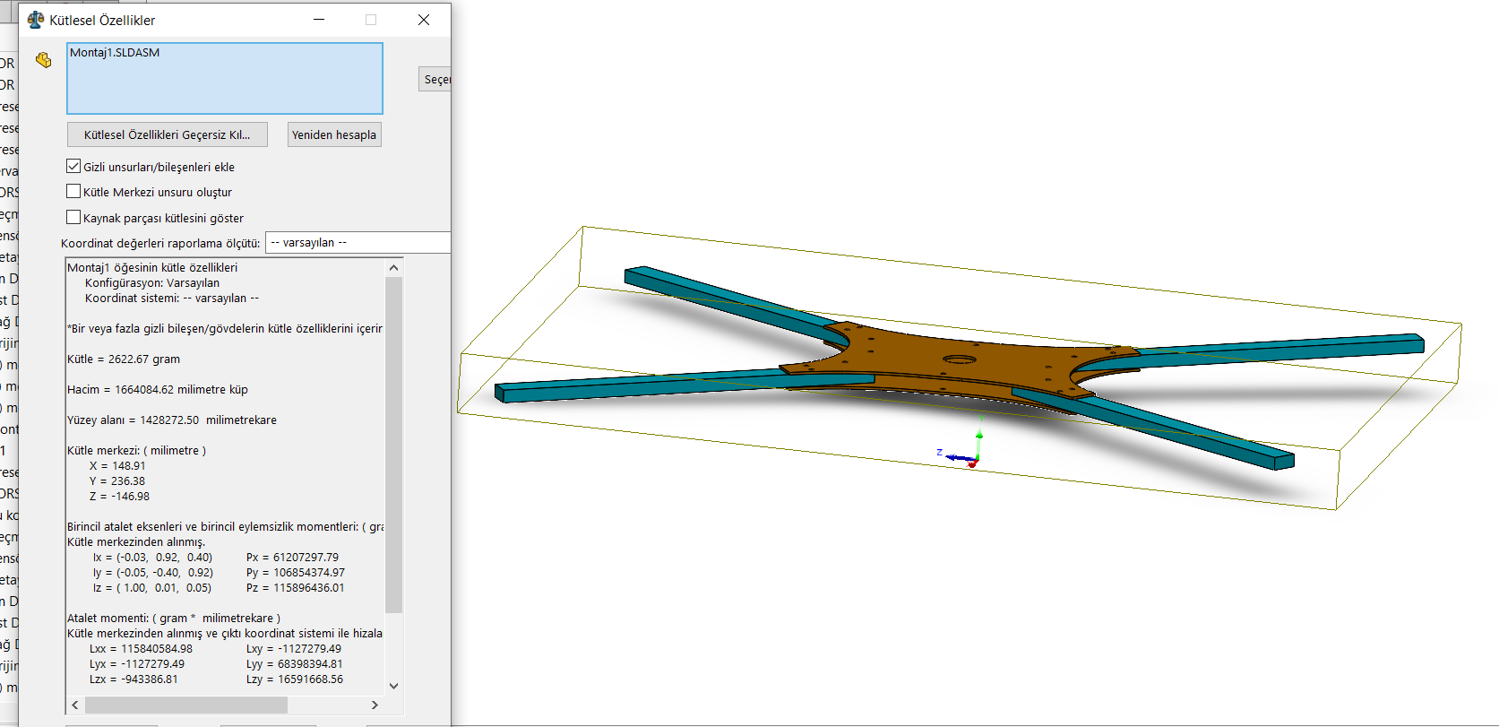
KTR TASARIM/FOTO/İHA FOTOĞRAFLAR.PNG
