TheDenizhan/-HA-TEKNOFEST/KTR TASARIM/FOTO/İZO.PNG

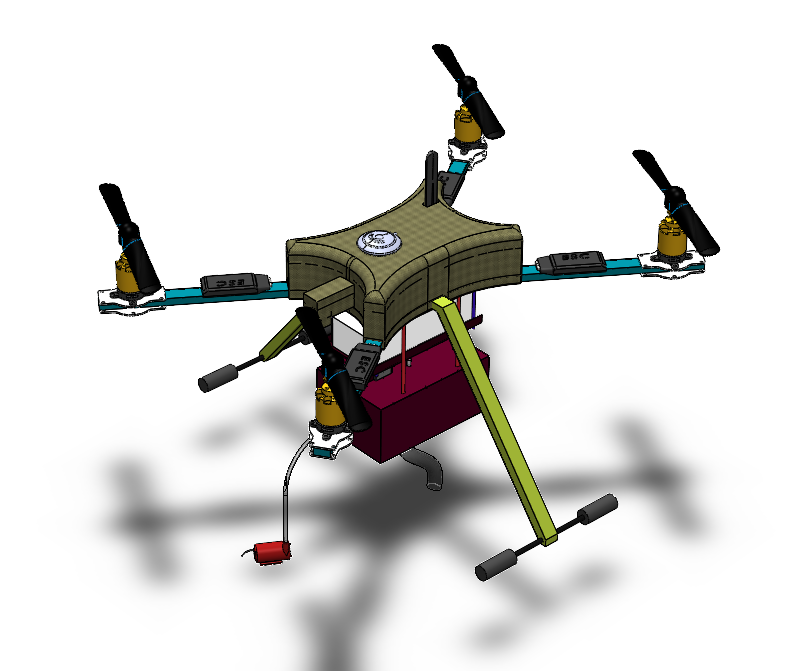
KTR TASARIM/FOTO/İZO.PNG
