TheDenizhan/-HA-TEKNOFEST/KTR TASARIM/FOTO/KOL.PNG

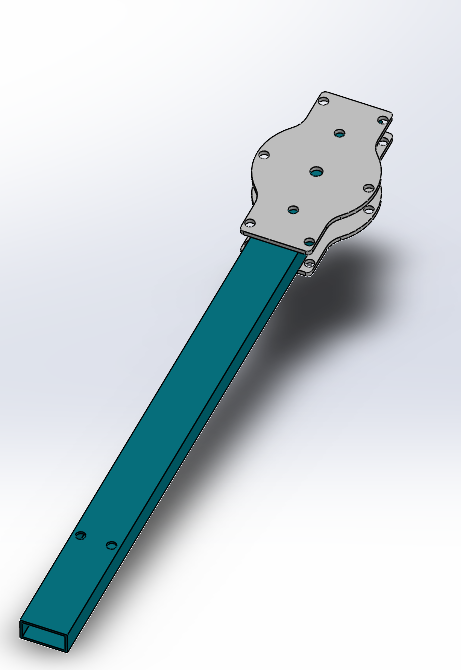
KTR TASARIM/FOTO/KOL.PNG
