TheDenizhan/-HA-TEKNOFEST/KTR TASARIM/FOTO/PİL YATAĞI.PNG

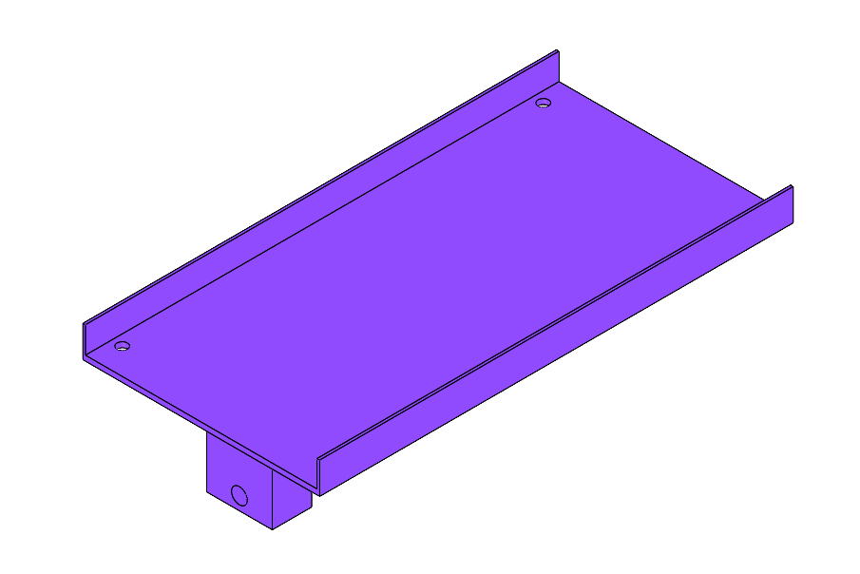
KTR TASARIM/FOTO/PİL YATAĞI.PNG
