TheDenizhan/-HA-TEKNOFEST/KTR TASARIM/FOTO/render.JPG

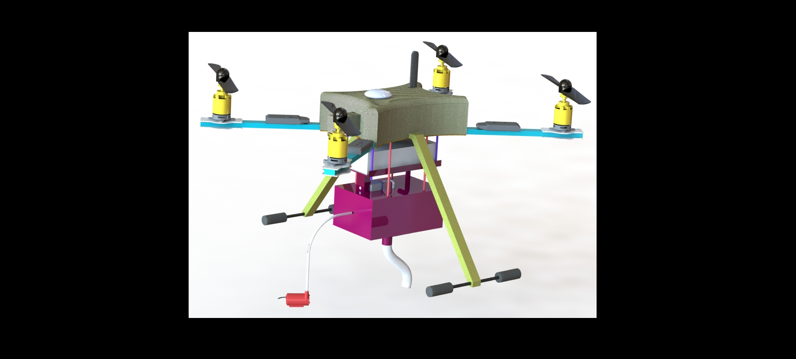
KTR TASARIM/FOTO/render.JPG
