TheDenizhan/-HA-TEKNOFEST/KTR TASARIM/FOTO/SOL.PNG

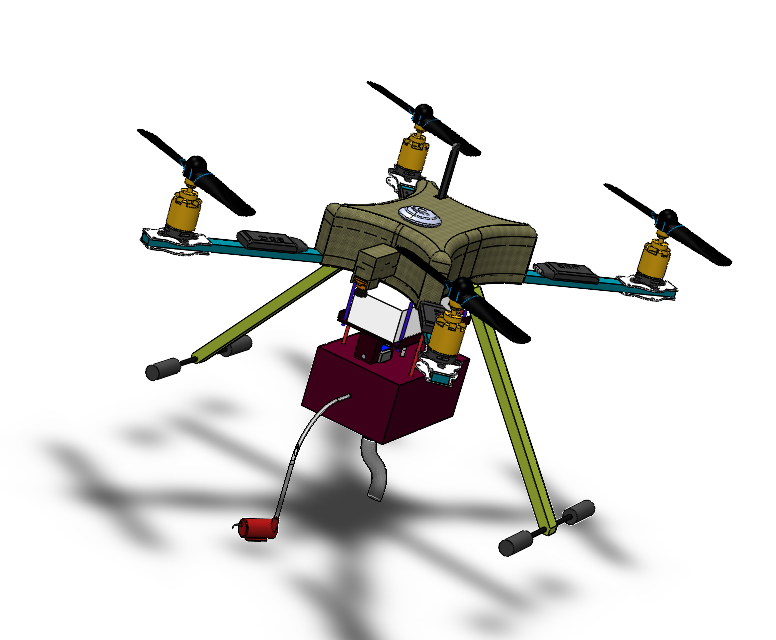
KTR TASARIM/FOTO/SOL.PNG
