TheDenizhan/-HA-TEKNOFEST/KTR TASARIM/FOTO/su pompası.PNG

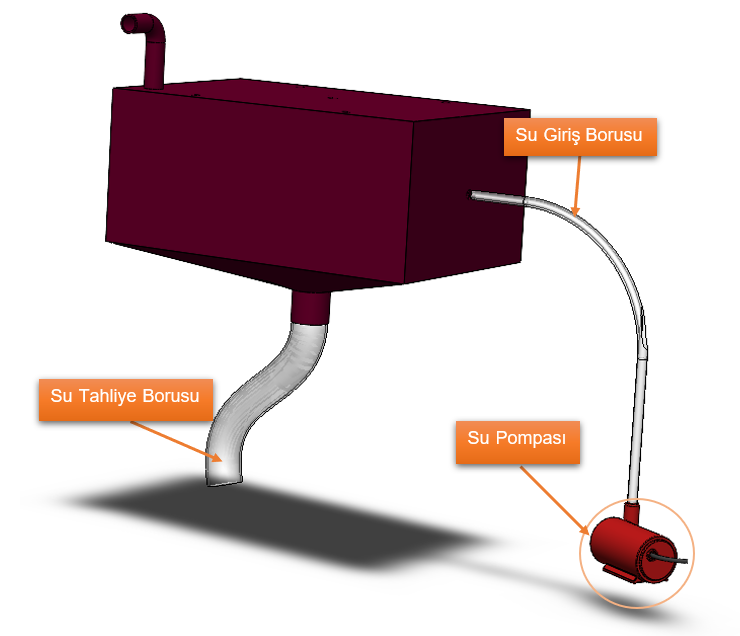
KTR TASARIM/FOTO/su pompası.PNG
