TheDenizhan/-HA-TEKNOFEST/KTR TASARIM/FOTO/SU TANKI.PNG

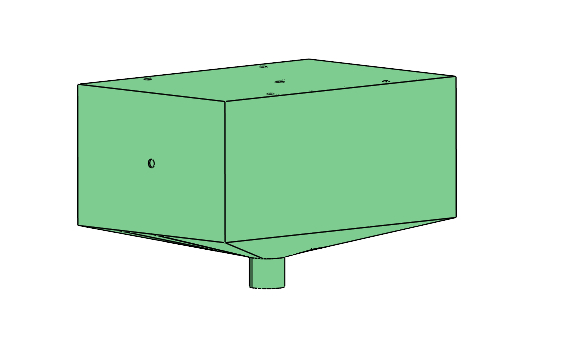
KTR TASARIM/FOTO/SU TANKI.PNG
