TheDenizhan/-HA-TEKNOFEST/KTR TASARIM/FOTO/su tankı.PNG

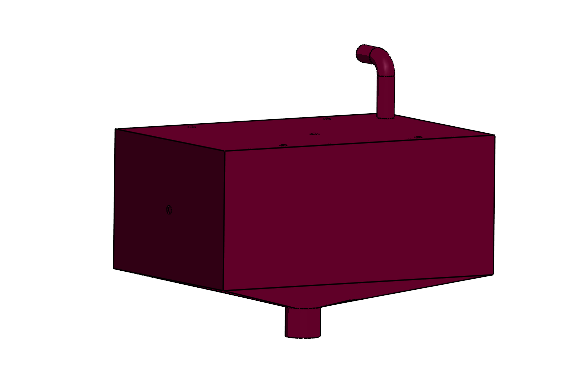
KTR TASARIM/FOTO/su tankı.PNG
