TheDenizhan/-HA-TEKNOFEST/KTR TASARIM/FOTO/YAN.PNG

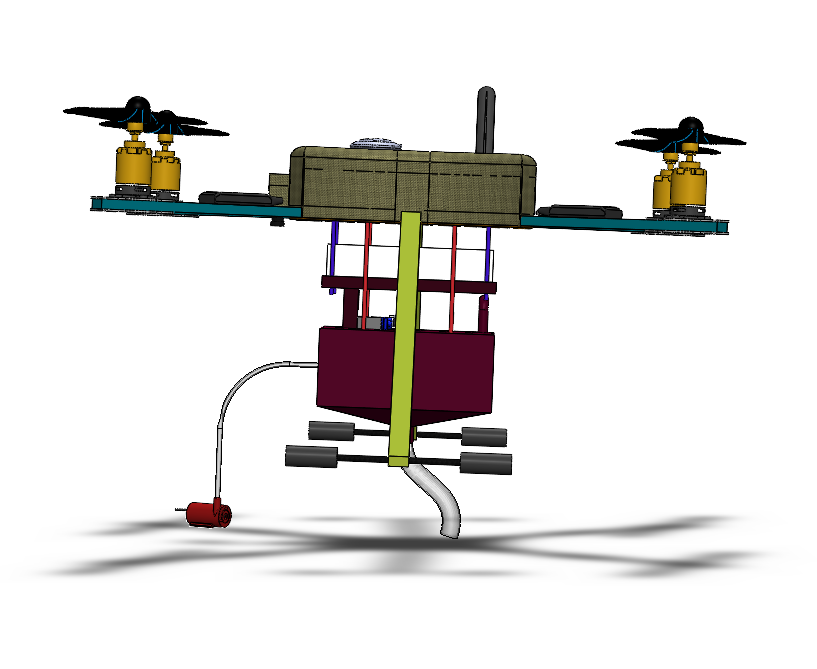
KTR TASARIM/FOTO/YAN.PNG
