TheDenizhan/-HA-TEKNOFEST/KTR TASARIM/İHA TASARIM/1.PNG

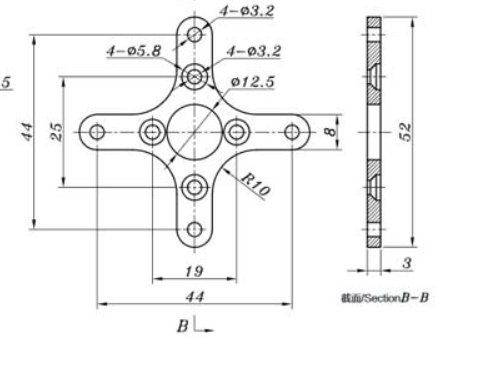
KTR TASARIM/İHA TASARIM/1.PNG
