TheDenizhan/-HA-TEKNOFEST/KTR TASARIM/İHA TASARIM/Ekran Alıntısı.PNG

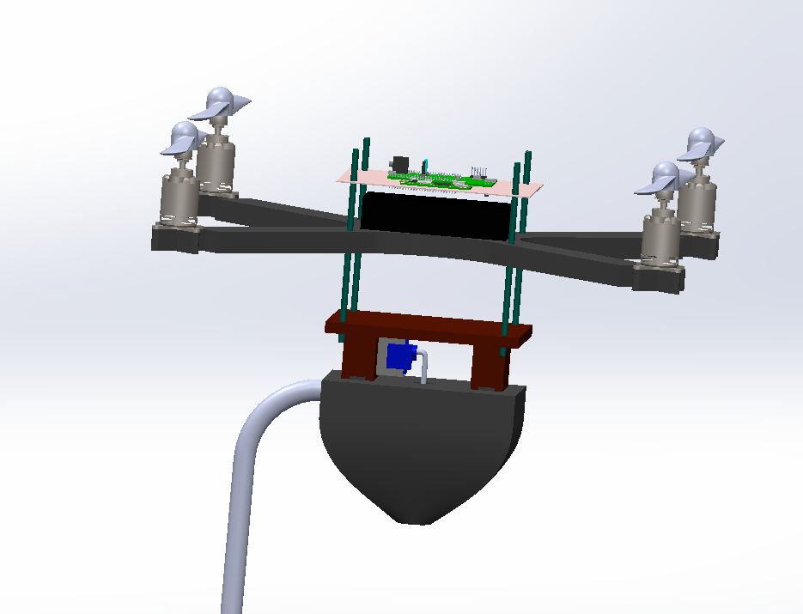
KTR TASARIM/İHA TASARIM/Ekran Alıntısı.PNG
