TheDenizhan/-HA-TEKNOFEST/marasss.jpg

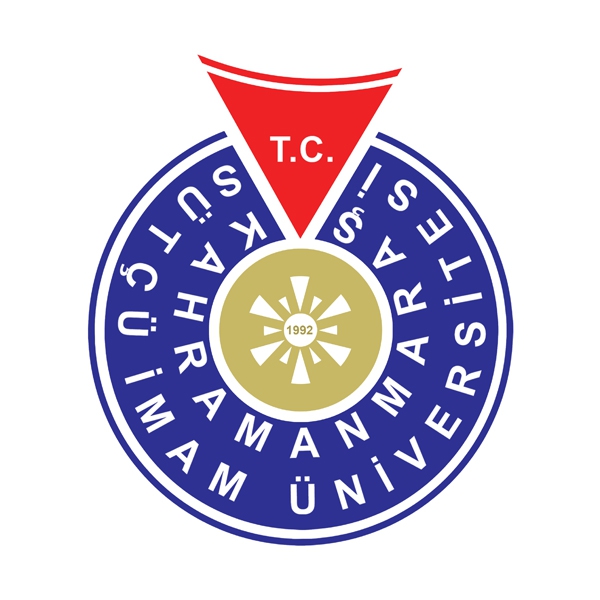
marasss.jpg
