TheDenizhan/-HA-TEKNOFEST/SU DEPOSU RESİM.PNG

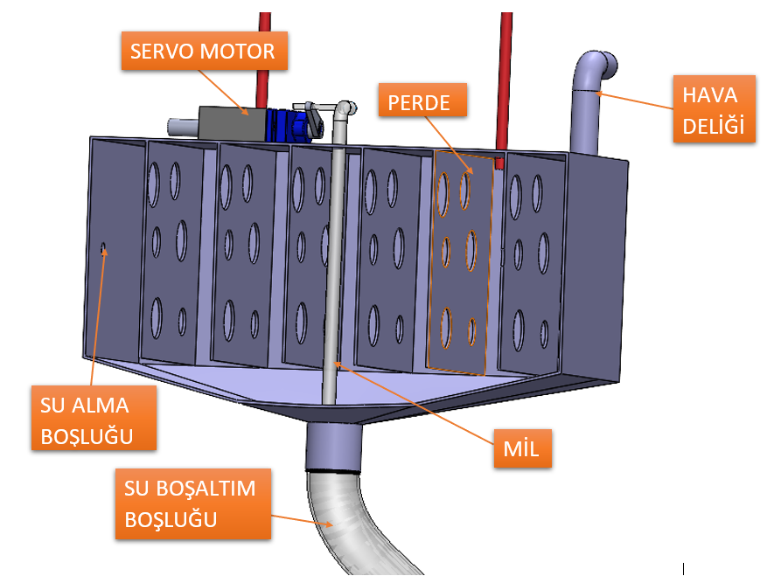
SU DEPOSU RESİM.PNG
