TheDenizhan/-HA-TEKNOFEST/KTR TASARIM/İHA 2/GPS_MN8_ASM_STEP.STEP.SLDASM

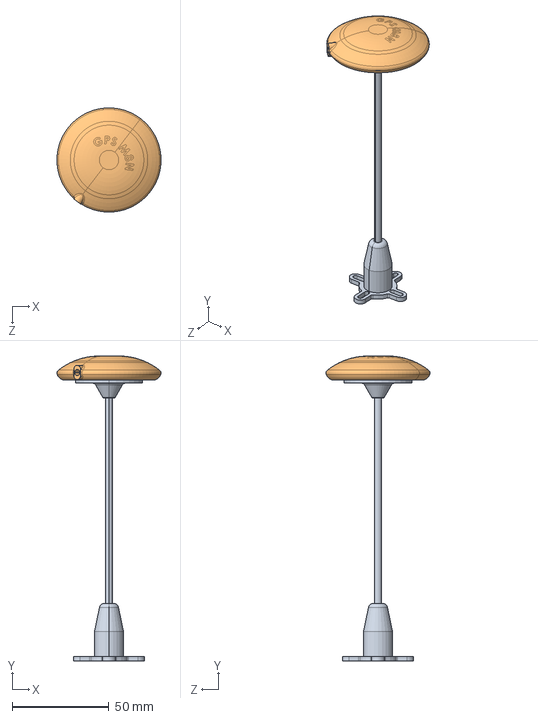
[picture p85: CAD file, 2024-07-01]
KTR TASARIM/İHA 2/GPS_MN8_ASM_STEP.STEP.SLDASM
53.7 x 157.4 x 53.7 mm
GPS MOD_L_ _SKELET_.STEP
GPS M8N.STEP
