TheDenizhan/-HA-TEKNOFEST/KTR TASARIM/İHA TASARIM/Montaj5.SLDASM

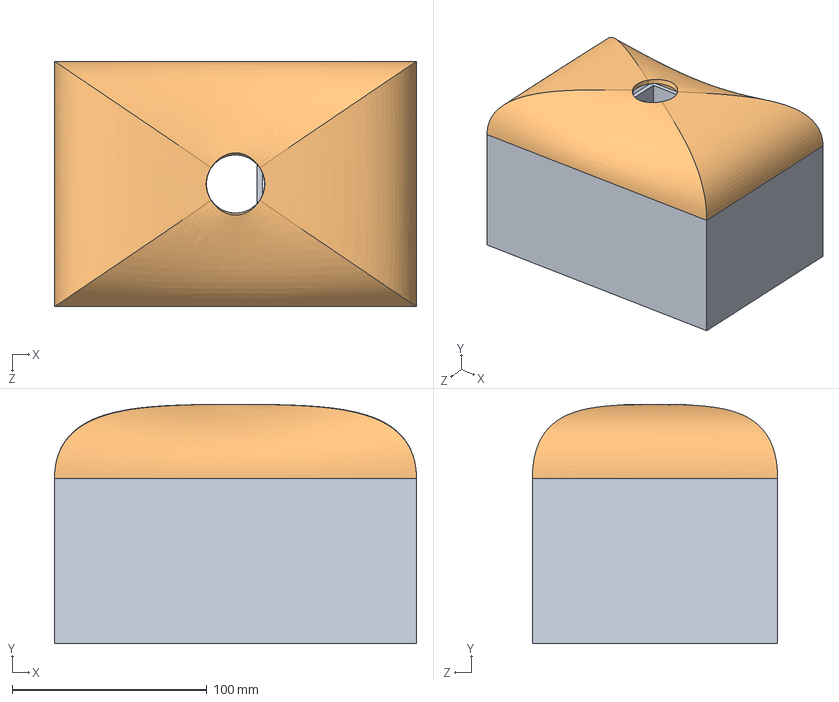
[picture p86: CAD file, 2024-07-01]
KTR TASARIM/İHA TASARIM/Montaj5.SLDASM
186.0 x 123.0 x 126.0 mm
su tankı 1
su tankı 2
