TheDenizhan/-HA-TEKNOFEST/KTR TASARIM/İHA 2/RuncamMicroSwift3.step.SLDASM

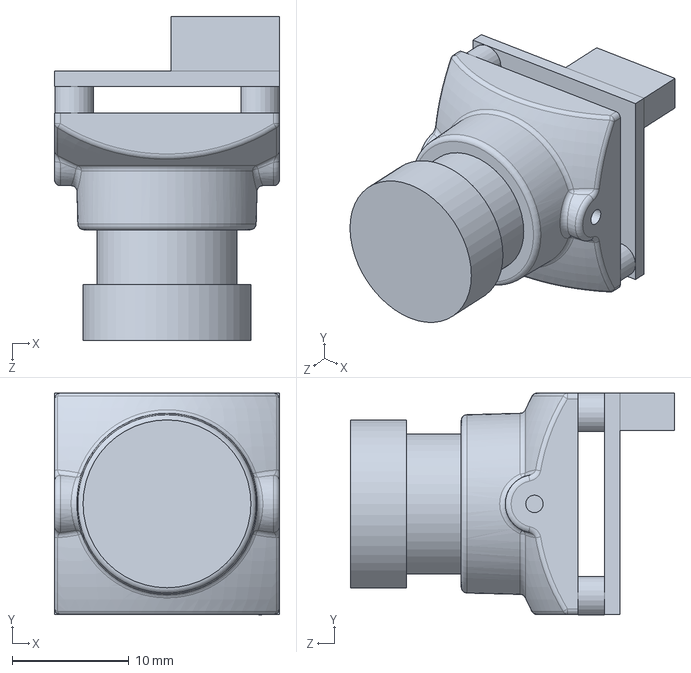
[picture p87: CAD file, 2024-07-01]
KTR TASARIM/İHA 2/RuncamMicroSwift3.step.SLDASM
19.3 x 19.0 x 27.8 mm
