TheDenizhan/-HA-TEKNOFEST/KTR TASARIM/İHA 2/MPU-6050-on-female-header.step.SLDASM

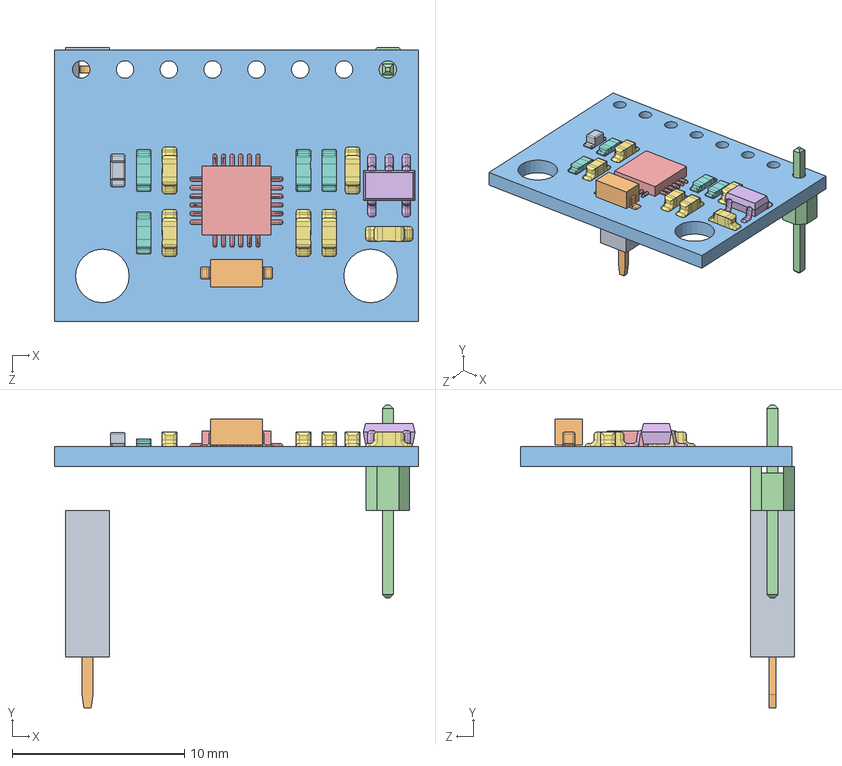
[picture p88: CAD file, 2024-07-01]
KTR TASARIM/İHA 2/MPU-6050-on-female-header.step.SLDASM
21.1 x 17.6 x 15.9 mm
Base.step
S2NH chip.step
Resistor small.step x 6
Resistor small black.step x 4
Small LED.step
Resistor black.step
