TheDenizhan/-HA-TEKNOFEST/KTR TASARIM/İHA TASARIM/Montaj1.SLDASM

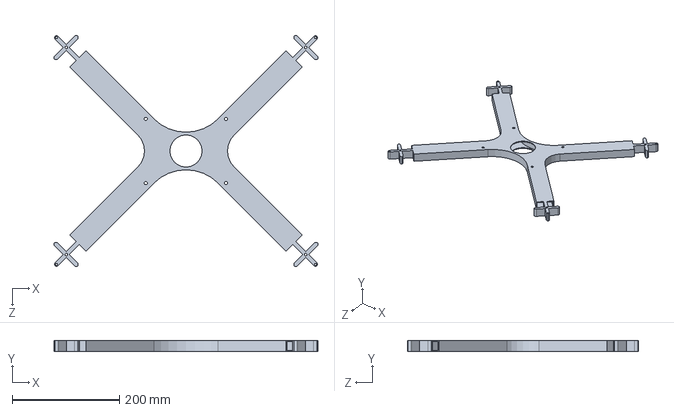
[picture p89: CAD file, 2024-07-01]
KTR TASARIM/İHA TASARIM/Montaj1.SLDASM
493.3 x 20.0 x 431.9 mm
