TheDenizhan/-HA-TEKNOFEST/KTR TASARIM/İHA 2/servo motor.SLDASM

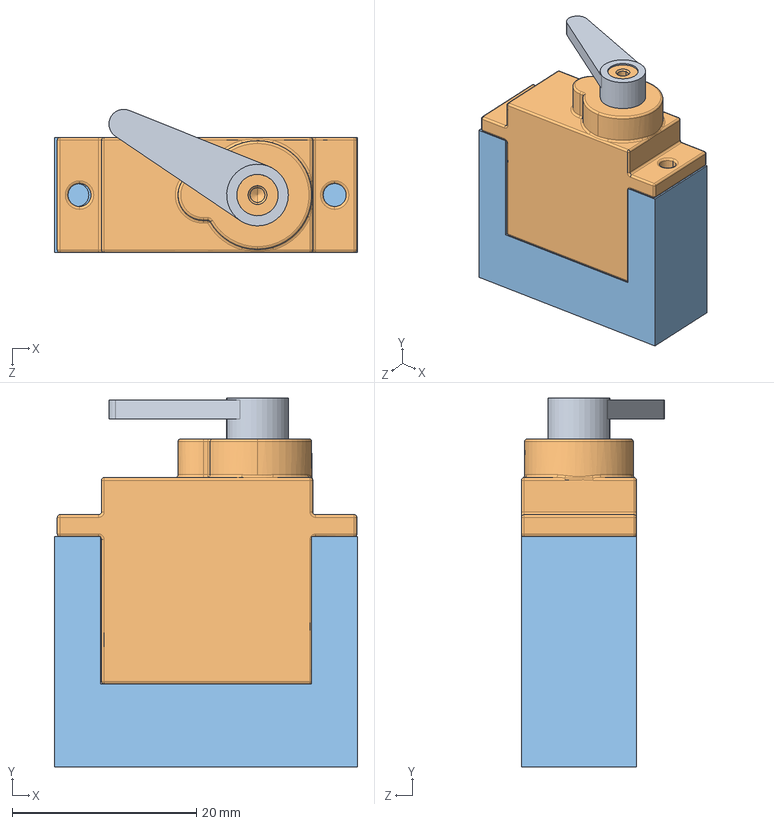
[picture p90: CAD file, 2024-07-01]
KTR TASARIM/İHA 2/servo motor.SLDASM
32.9 x 40.1 x 15.6 mm
Servo Horn
Longruner LKY61 MG90 Servo.step
bağlantı2
