TheDenizhan/-HA-TEKNOFEST/KTR TASARIM/İHA 2/Assembly Raspberry Pi 4 Model B step.STEP.SLDASM

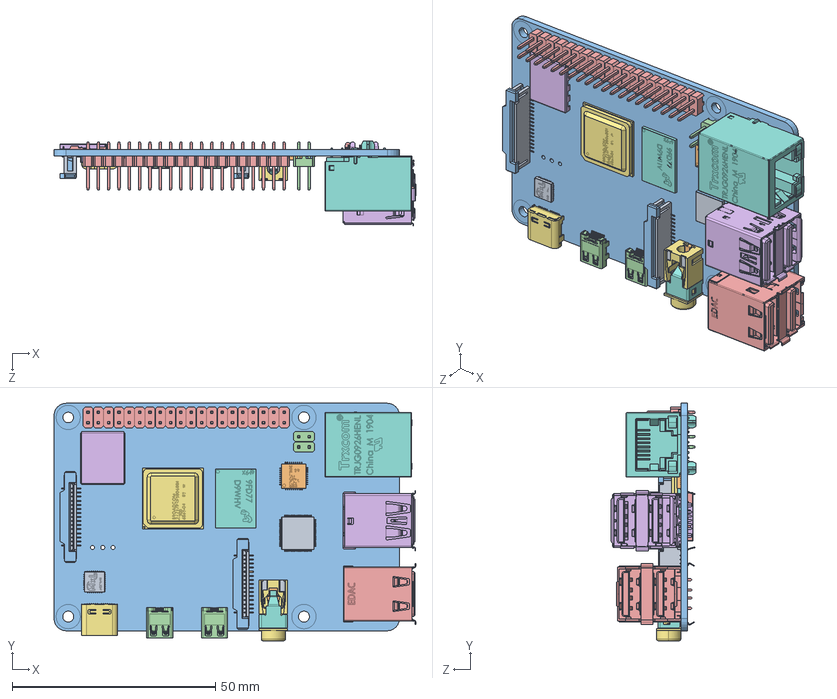
[picture p91: CAD file, 2024-07-01]
KTR TASARIM/İHA 2/Assembly Raspberry Pi 4 Model B step.STEP.SLDASM
89.1 x 58.5 x 20.8 mm
2.2 part 2 with combine.STEP x 2
1.1 part 1 metal pin.STEP x 2
3.3 plastic.STEP x 2
card slot part 2 metal pin.STEP
sd card slot v1.STEP
part 3 v1.STEP
part 4 microphone plug.STEP
Microphone plug part 1.STEP
part 2 microphon plug metal.STEP
part 3 microphone plug.STEP
1.0 Plate raspberry Pi 4.STEP
2.0. PIN HEADER one.STEP
3.0 PIN HEADER 20.STEP
4.0 metal plate..STEP
5.0 CPU Broadcom.STEP
6.0 9FD77 D9WHV.STEP
7.0 MxL.STEP
8.0 Gigabit Ethernet Transceiver.STEP
9.0 VLI PCIe USB 3.0 Controller.STEP
11.0 Female micro HDMI connector.STEP x 2
15.0 2x USB 2.0 PORT.STEP
14.0 2x USB 3.0 PORT.STEP
10.0 Female USB connector.STEP
12.0 Gigabit ethernet port raspberry.STEP
9.0 VLI PCIe USB 3.0 Controller v1.STEP
