TheDenizhan/-HA-TEKNOFEST/KTR TASARIM/İHA 2/MOTORS.SLDASM

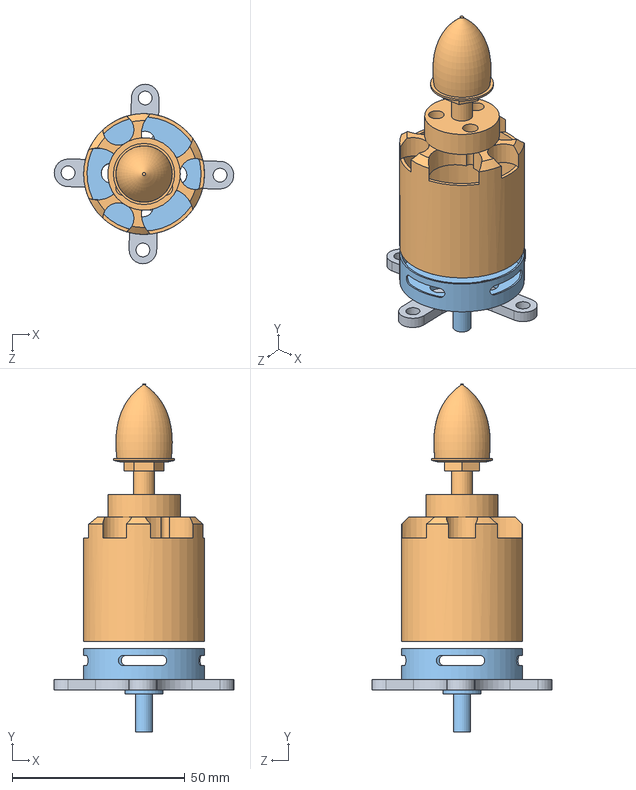
[picture p92: CAD file, 2024-07-01]
KTR TASARIM/İHA 2/MOTORS.SLDASM
52.0 x 100.8 x 52.0 mm
motor parça 1
motor
motor parça 2
