TheDenizhan/-HA-TEKNOFEST/KTR TASARIM/İHA TASARIM/bağlantı.SLDPRT

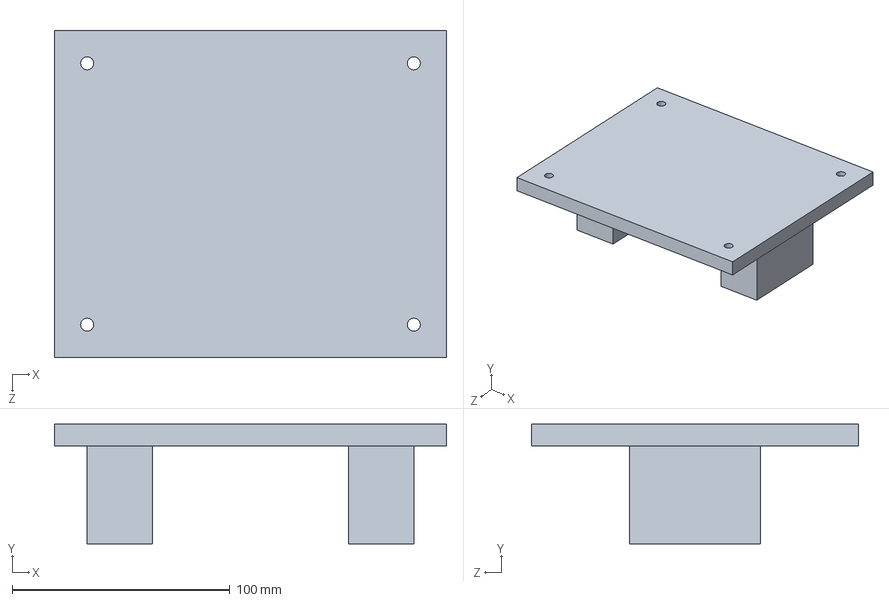
[picture p93: CAD file, 2024-07-01]
KTR TASARIM/İHA TASARIM/bağlantı.SLDPRT
180.0 x 55.0 x 150.0 mm
