TheDenizhan/-HA-TEKNOFEST/KTR TASARIM/İHA 2/drone.SLDPRT

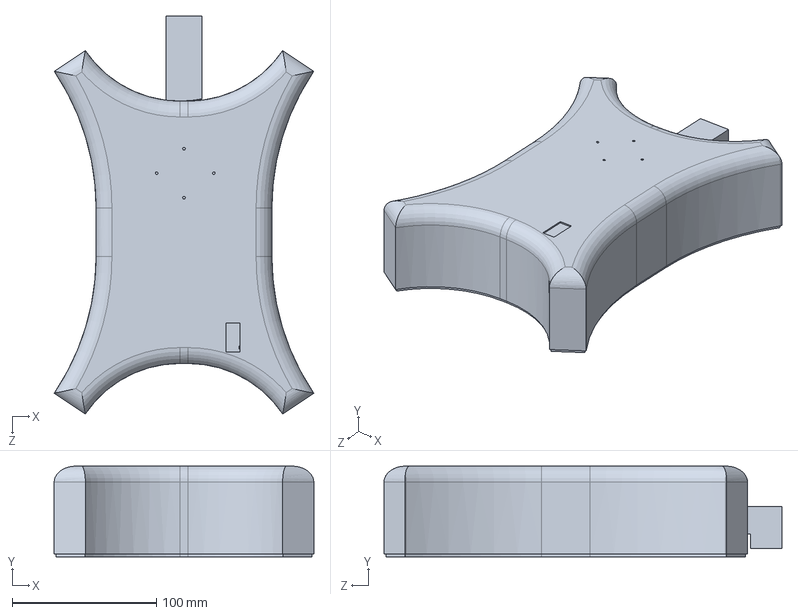
[picture p94: CAD file, 2024-07-01]
KTR TASARIM/İHA 2/drone.SLDPRT
180.1 x 63.0 x 276.1 mm
