TheDenizhan/-HA-TEKNOFEST/KTR TASARIM/İHA TASARIM/boru1.SLDPRT

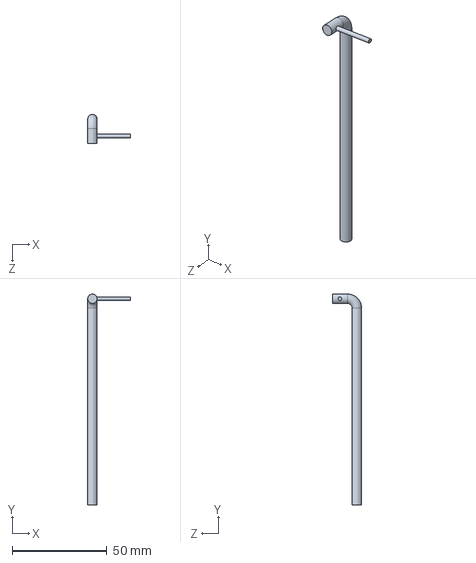
[picture p95: CAD file, 2024-07-01]
KTR TASARIM/İHA TASARIM/boru1.SLDPRT
22.5 x 111.3 x 15.5 mm
