TheDenizhan/-HA-TEKNOFEST/KTR TASARIM/İHA 2/MİL.SLDPRT

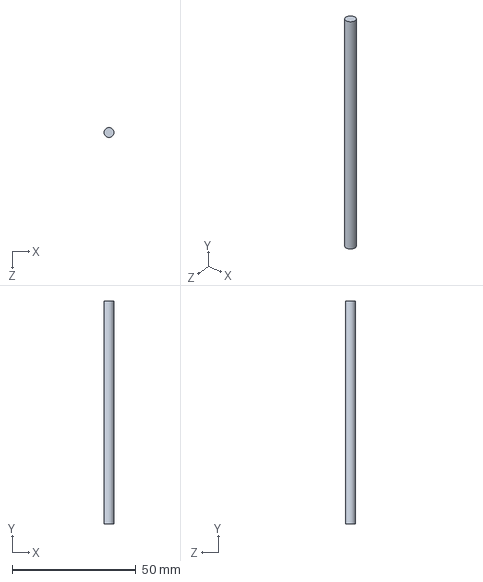
[picture p96: CAD file, 2024-07-01]
KTR TASARIM/İHA 2/MİL.SLDPRT
4.00 x 90.0 x 4.00 mm
