TheDenizhan/-HA-TEKNOFEST/KTR TASARIM/İHA TASARIM/bağlantı2.SLDPRT

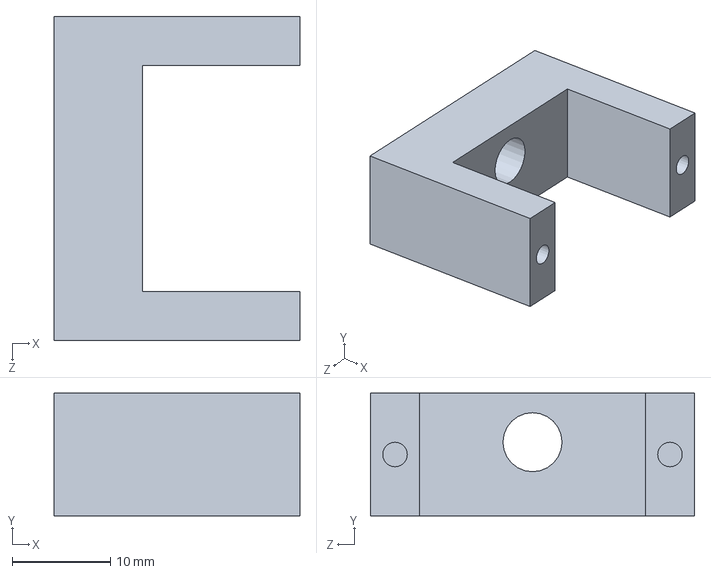
[picture p97: CAD file, 2024-07-01]
KTR TASARIM/İHA TASARIM/bağlantı2.SLDPRT
25.0 x 12.5 x 32.9 mm
