TheDenizhan/-HA-TEKNOFEST/KTR TASARIM/İHA TASARIM/pervane.SLDPRT

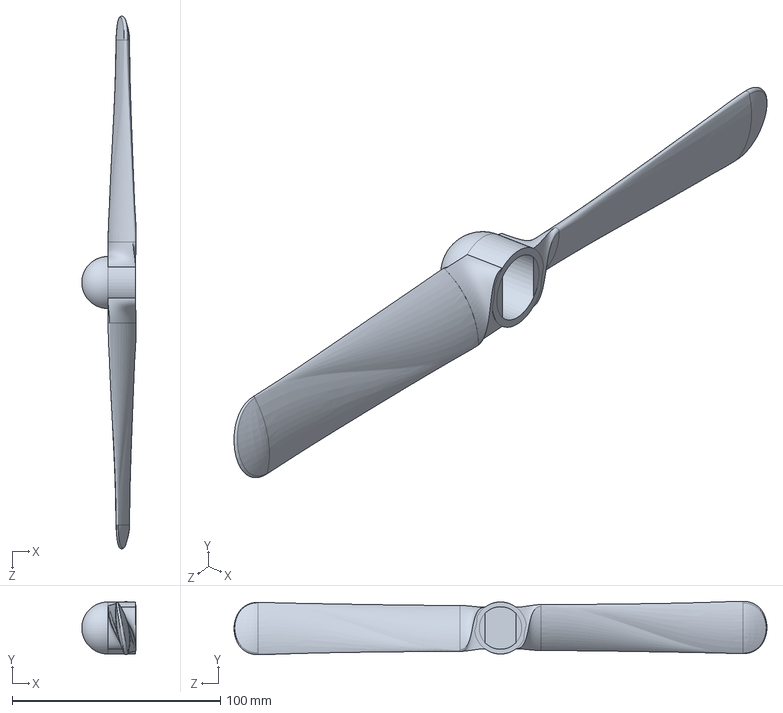
[picture p98: CAD file, 2024-07-01]
KTR TASARIM/İHA TASARIM/pervane.SLDPRT
26.1 x 25.6 x 255.9 mm
