TheDenizhan/-HA-TEKNOFEST/KTR TASARIM/İHA TASARIM/boru 2.SLDPRT

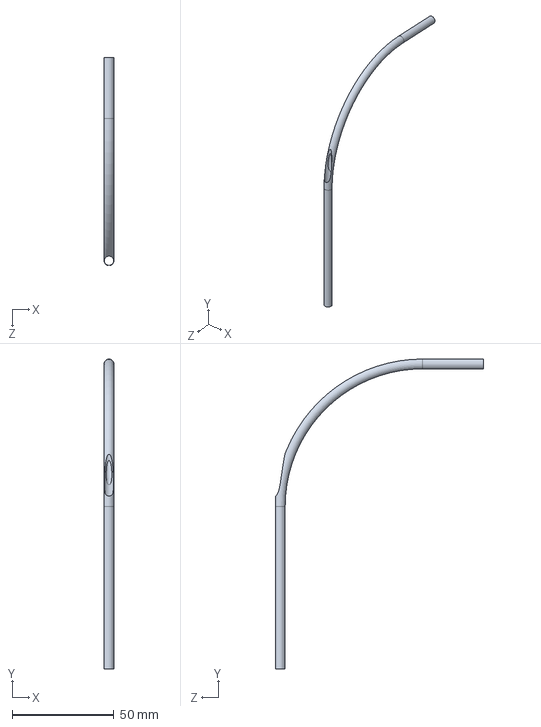
[picture p99: CAD file, 2024-07-01]
KTR TASARIM/İHA TASARIM/boru 2.SLDPRT
4.85 x 152.4 x 102.4 mm
