TheDenizhan/-HA-TEKNOFEST/KTR TASARIM/İHA 2/elcik.SLDPRT

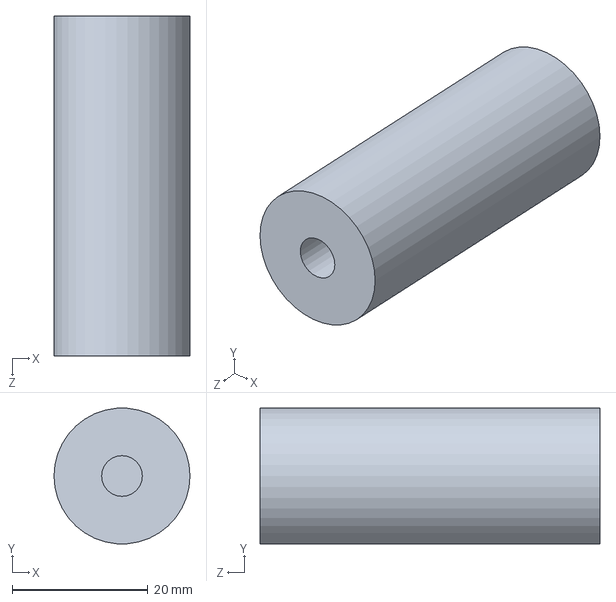
[picture p100: CAD file, 2024-07-01]
KTR TASARIM/İHA 2/elcik.SLDPRT
20.0 x 19.9 x 50.0 mm
