TheDenizhan/-HA-TEKNOFEST/KTR TASARIM/İHA TASARIM/motor parça3.SLDPRT

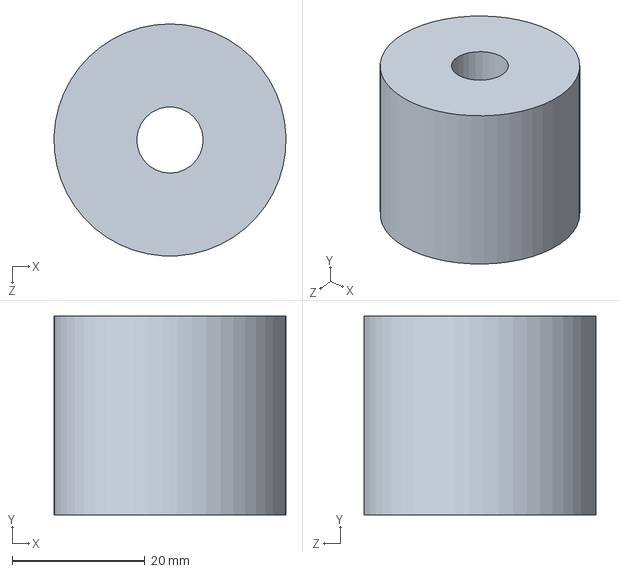
[picture p101: CAD file, 2024-07-01]
KTR TASARIM/İHA TASARIM/motor parça3.SLDPRT
35.0 x 30.0 x 35.0 mm
