TheDenizhan/-HA-TEKNOFEST/KTR TASARIM/İHA 2/MOTOR ÜST2.SLDPRT

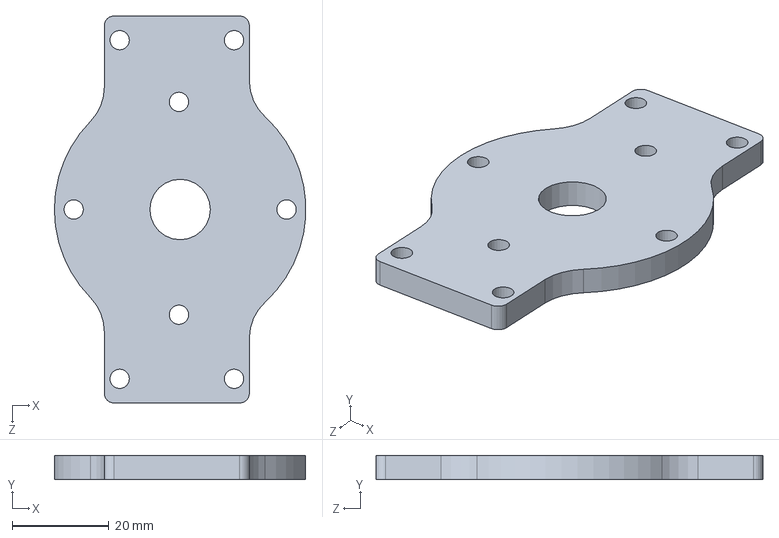
[picture p102: CAD file, 2024-07-01]
KTR TASARIM/İHA 2/MOTOR ÜST2.SLDPRT
51.9 x 5.00 x 80.0 mm
