TheDenizhan/-HA-TEKNOFEST/KTR TASARIM/İHA 2/boru3.SLDPRT

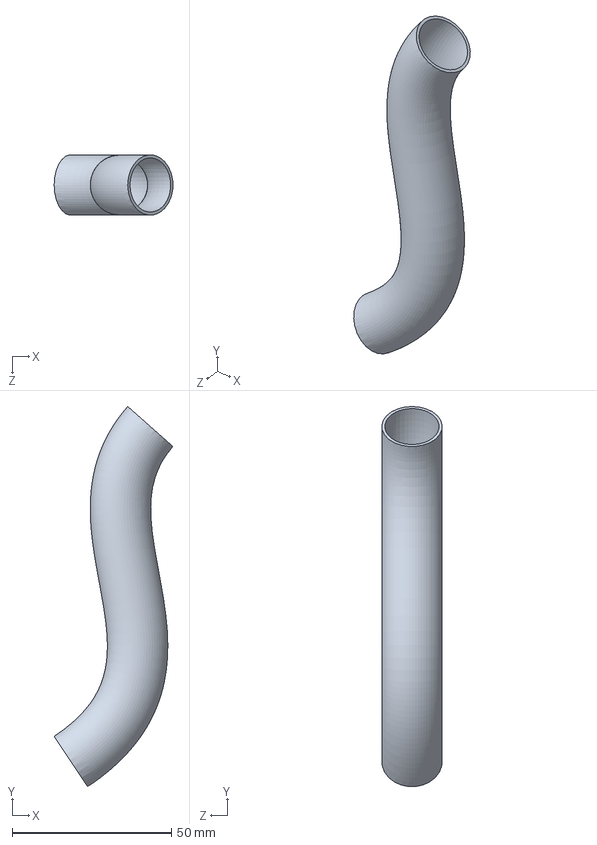
[picture p103: CAD file, 2024-07-01]
KTR TASARIM/İHA 2/boru3.SLDPRT
37.3 x 119.4 x 19.0 mm
