TheDenizhan/-HA-TEKNOFEST/KTR TASARIM/İHA TASARIM/sb kiriş.SLDPRT

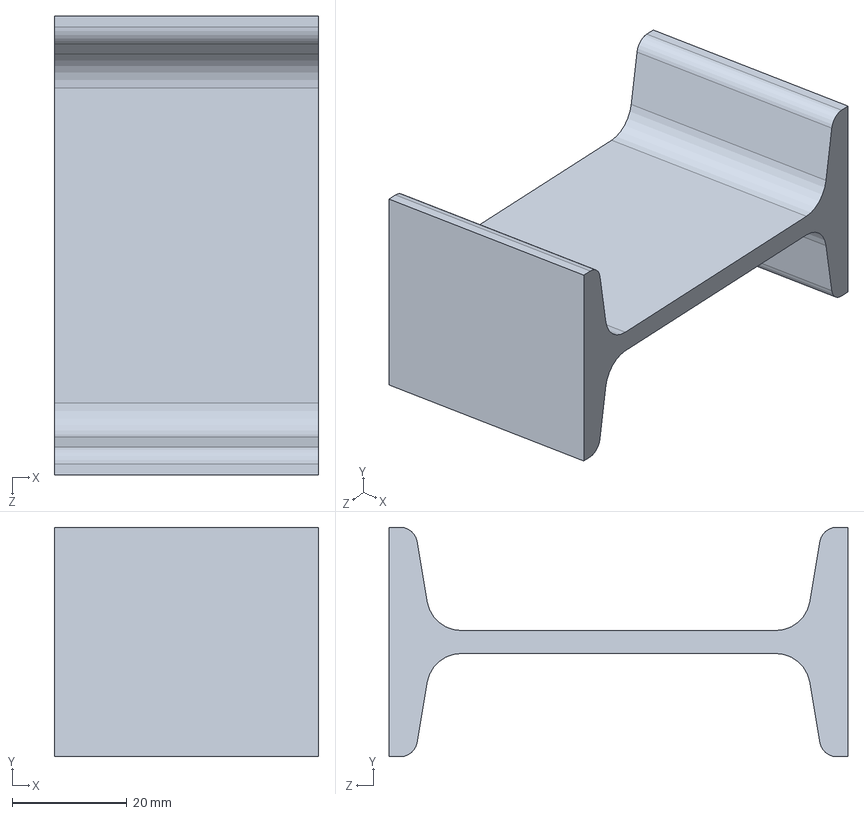
[picture p104: CAD file, 2024-07-01]
KTR TASARIM/İHA TASARIM/sb kiriş.SLDPRT
46.1 x 40.0 x 80.0 mm
