TheDenizhan/-HA-TEKNOFEST/KTR TASARIM/İHA TASARIM/su tankı 1.SLDPRT

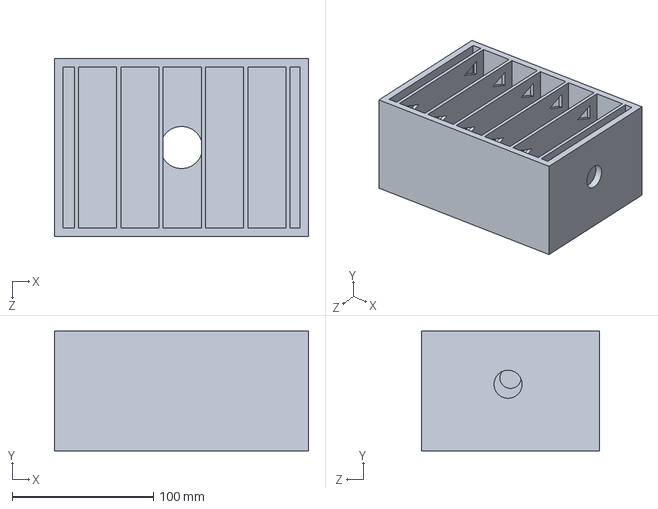
[picture p105: CAD file, 2024-07-01]
KTR TASARIM/İHA TASARIM/su tankı 1.SLDPRT
180.0 x 85.0 x 126.0 mm
