TheDenizhan/-HA-TEKNOFEST/KTR TASARIM/İHA 2/SU TANKI BAĞLANTI MİLİ.SLDPRT

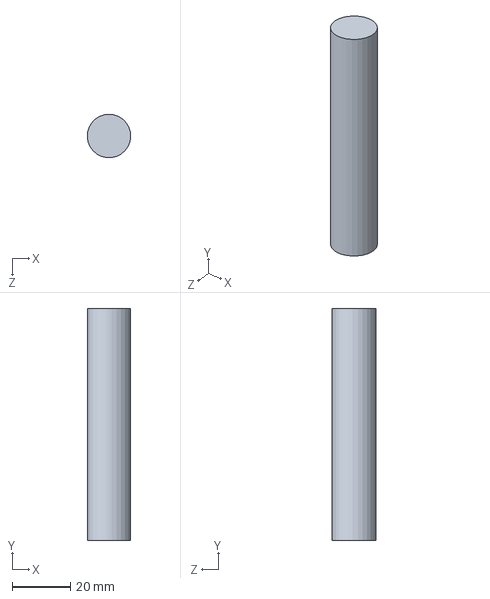
[picture p106: CAD file, 2024-07-01]
KTR TASARIM/İHA 2/SU TANKI BAĞLANTI MİLİ.SLDPRT
15.0 x 80.0 x 15.0 mm
