TheDenizhan/-HA-TEKNOFEST/KTR TASARIM/İHA TASARIM/tabaka1.SLDPRT

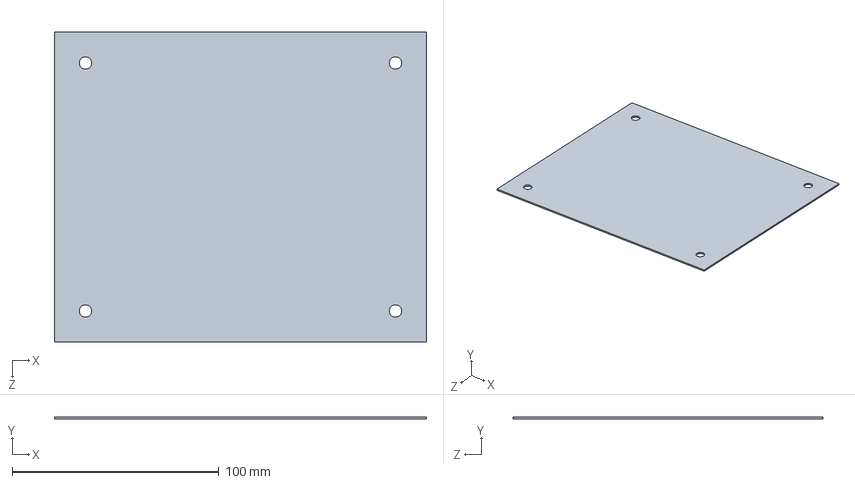
[picture p107: CAD file, 2024-07-01]
KTR TASARIM/İHA TASARIM/tabaka1.SLDPRT
180.0 x 1.00 x 150.0 mm
