TheDenizhan/-HA-TEKNOFEST/KTR TASARIM/İHA TASARIM/Longruner LKY61 MG90 Servo.step.SLDPRT

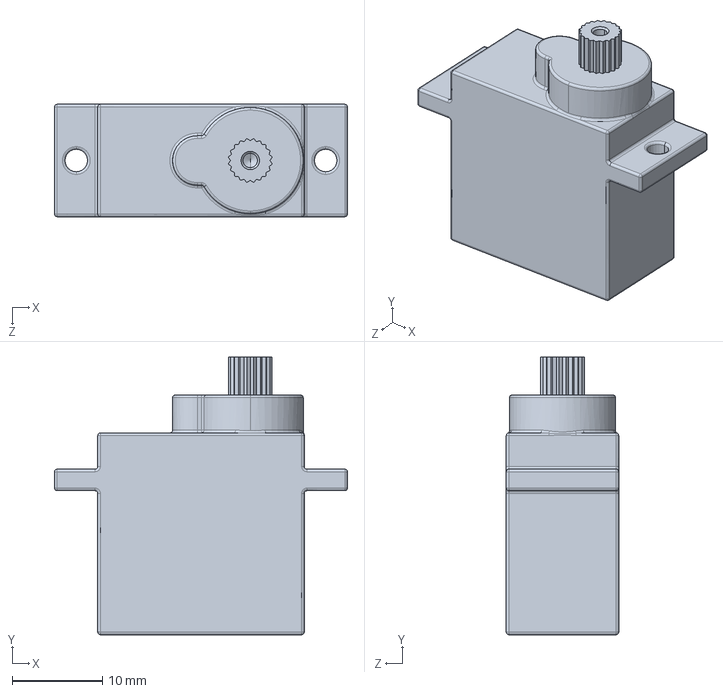
[picture p108: CAD file, 2024-07-01]
KTR TASARIM/İHA TASARIM/Longruner LKY61 MG90 Servo.step.SLDPRT
32.5 x 30.8 x 12.5 mm
