TheDenizhan/-HA-TEKNOFEST/KTR TASARIM/İHA TASARIM/motor parça 1.SLDPRT

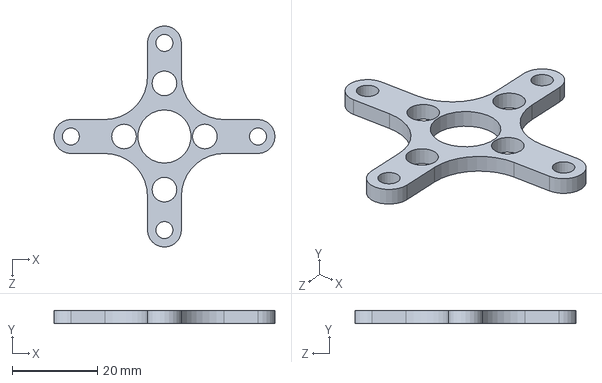
[picture p109: CAD file, 2024-07-01]
KTR TASARIM/İHA TASARIM/motor parça 1.SLDPRT
52.0 x 3.00 x 52.0 mm
