TheDenizhan/-HA-TEKNOFEST/KTR TASARIM/İHA 2/ÜST GÖVDE.SLDPRT

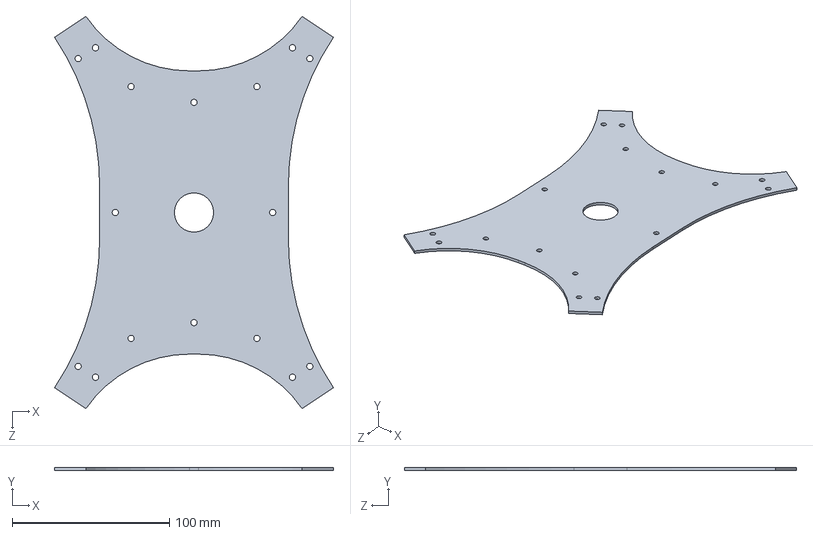
[picture p110: CAD file, 2024-07-01]
KTR TASARIM/İHA 2/ÜST GÖVDE.SLDPRT
177.3 x 2.00 x 249.3 mm
