TheDenizhan/-HA-TEKNOFEST/KTR TASARIM/İHA 2/MOTOR ÜST.SLDPRT

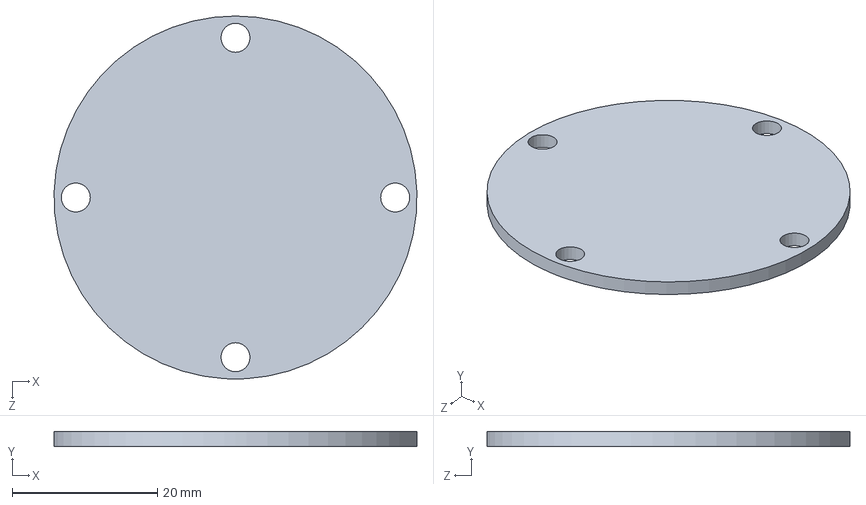
[picture p111: CAD file, 2024-07-01]
KTR TASARIM/İHA 2/MOTOR ÜST.SLDPRT
50.0 x 2.00 x 50.0 mm
