TheDenizhan/-HA-TEKNOFEST/KTR TASARIM/İHA TASARIM/motor parça 2.SLDPRT

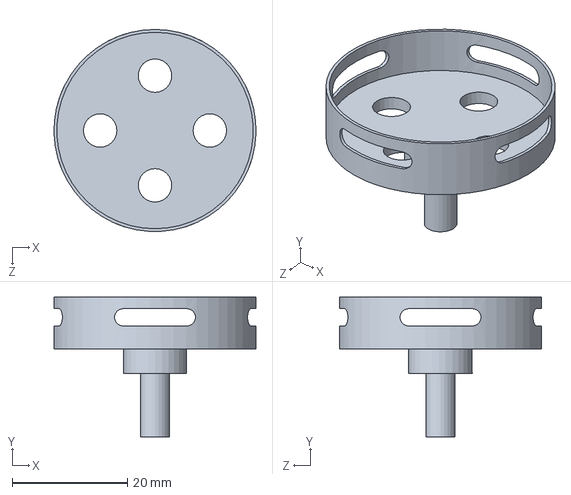
[picture p112: CAD file, 2024-07-01]
KTR TASARIM/İHA TASARIM/motor parça 2.SLDPRT
35.0 x 24.2 x 35.0 mm
