TheDenizhan/-HA-TEKNOFEST/KTR TASARIM/İHA TASARIM/pil.SLDPRT

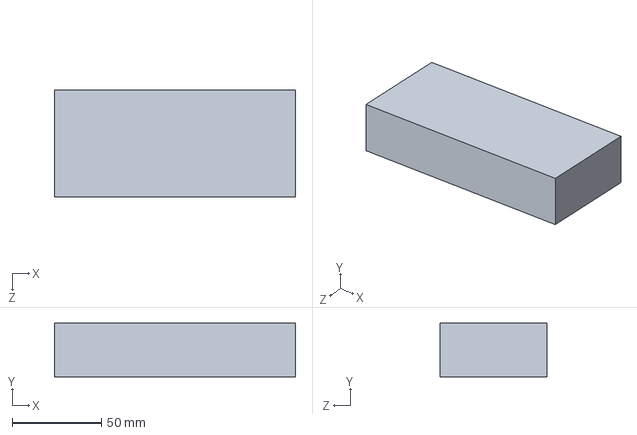
[picture p113: CAD file, 2024-07-01]
KTR TASARIM/İHA TASARIM/pil.SLDPRT
135.0 x 30.0 x 60.0 mm
