TheDenizhan/-HA-TEKNOFEST/KTR TASARIM/İHA 2/su tankı 2.SLDPRT

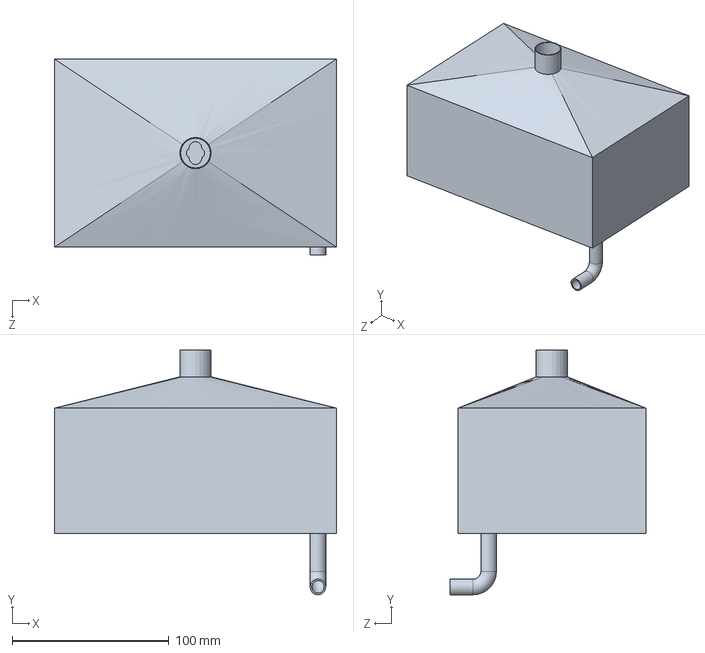
[picture p114: CAD file, 2024-07-01]
KTR TASARIM/İHA 2/su tankı 2.SLDPRT
180.0 x 156.1 x 125.0 mm
