TheDenizhan/-HA-TEKNOFEST/KTR TASARIM/İHA TASARIM/su tankı deneme.SLDPRT

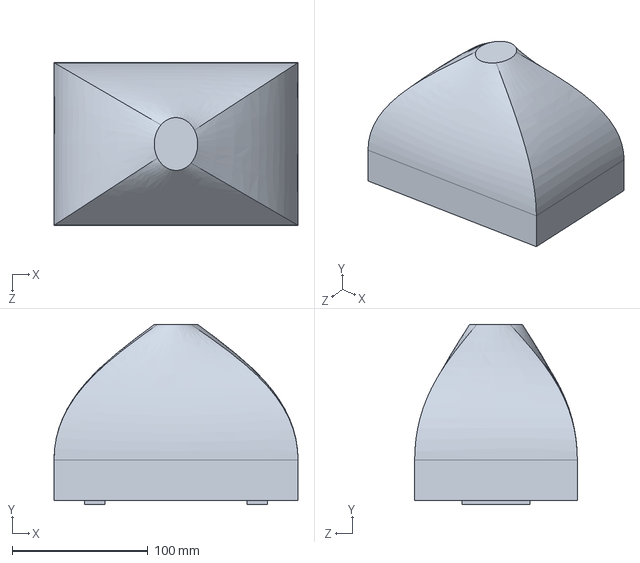
[picture p115: CAD file, 2024-07-01]
KTR TASARIM/İHA TASARIM/su tankı deneme.SLDPRT
180.0 x 133.0 x 120.0 mm
