TheDenizhan/-HA-TEKNOFEST/KTR TASARIM/İHA TASARIM/sb2.SLDPRT

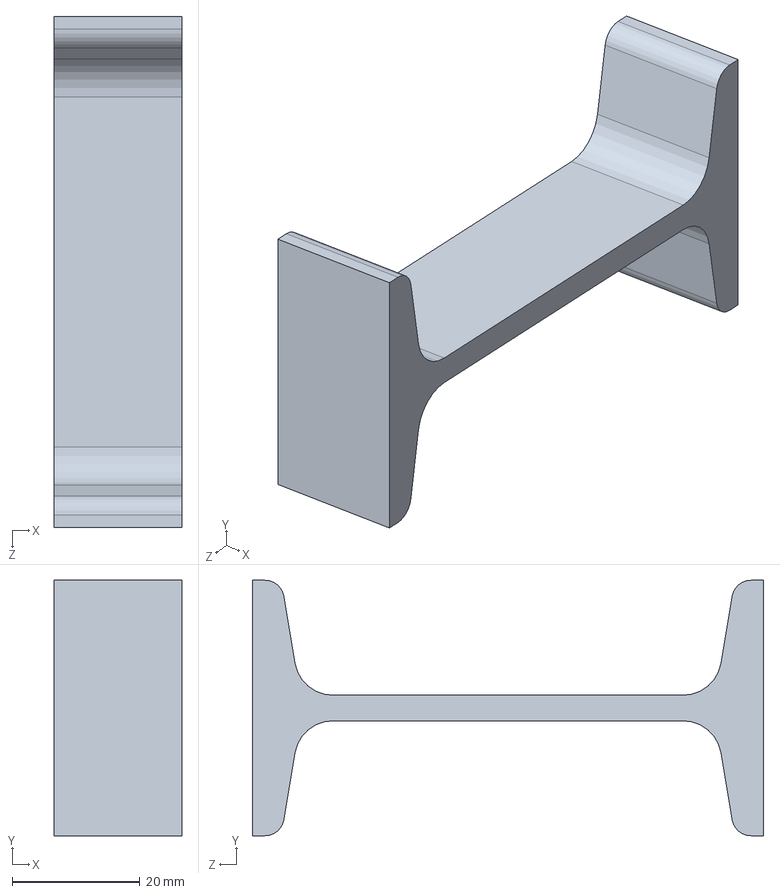
[picture p116: CAD file, 2024-07-01]
KTR TASARIM/İHA TASARIM/sb2.SLDPRT
20.0 x 40.0 x 80.0 mm
