TheDenizhan/-HA-TEKNOFEST/KTR TASARIM/İHA 2/conta.SLDPRT

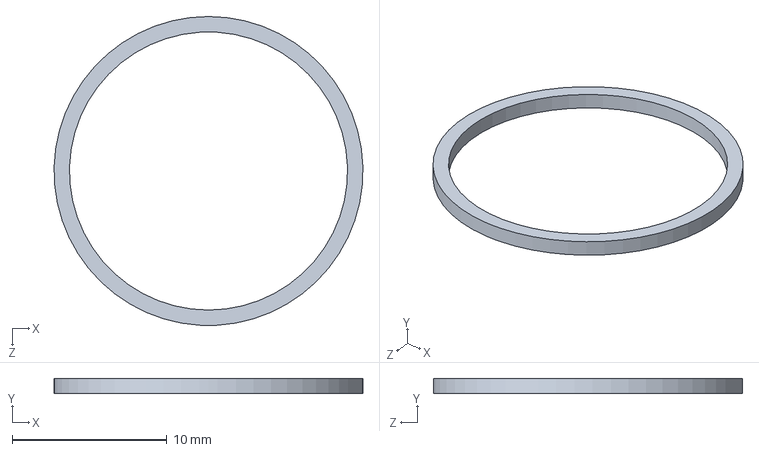
[picture p117: CAD file, 2024-07-01]
KTR TASARIM/İHA 2/conta.SLDPRT
20.0 x 1.00 x 20.0 mm
