TheDenizhan/-HA-TEKNOFEST/KTR TASARIM/İHA TASARIM/deneme.SLDPRT

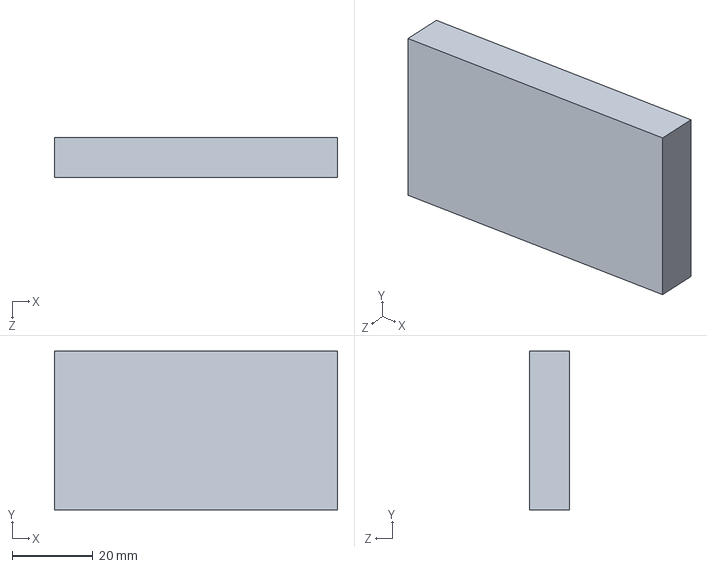
[picture p118: CAD file, 2024-07-01]
KTR TASARIM/İHA TASARIM/deneme.SLDPRT
70.0 x 39.2 x 10.0 mm
