TheDenizhan/-HA-TEKNOFEST/KTR TASARIM/İHA TASARIM/ÜST GÖVDE.SLDPRT

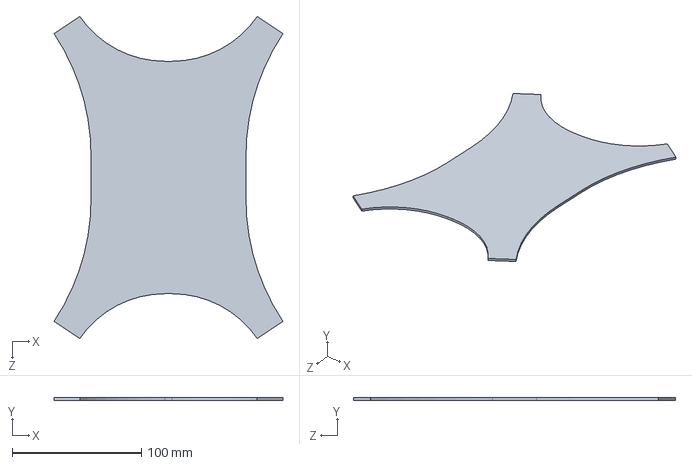
[picture p119: CAD file, 2024-07-01]
KTR TASARIM/İHA TASARIM/ÜST GÖVDE.SLDPRT
177.3 x 2.00 x 249.3 mm
