TheDenizhan/-HA-TEKNOFEST/KTR TASARIM/İHA 2/BAĞLANTI SU TANKI,.SLDPRT

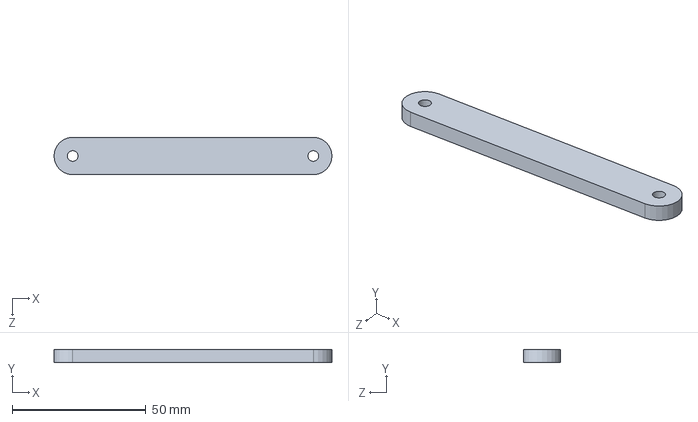
[picture p120: CAD file, 2024-07-01]
KTR TASARIM/İHA 2/BAĞLANTI SU TANKI,.SLDPRT
104.0 x 5.00 x 14.0 mm
