TheDenizhan/-HA-TEKNOFEST/KTR TASARIM/İHA 2/motor.SLDPRT

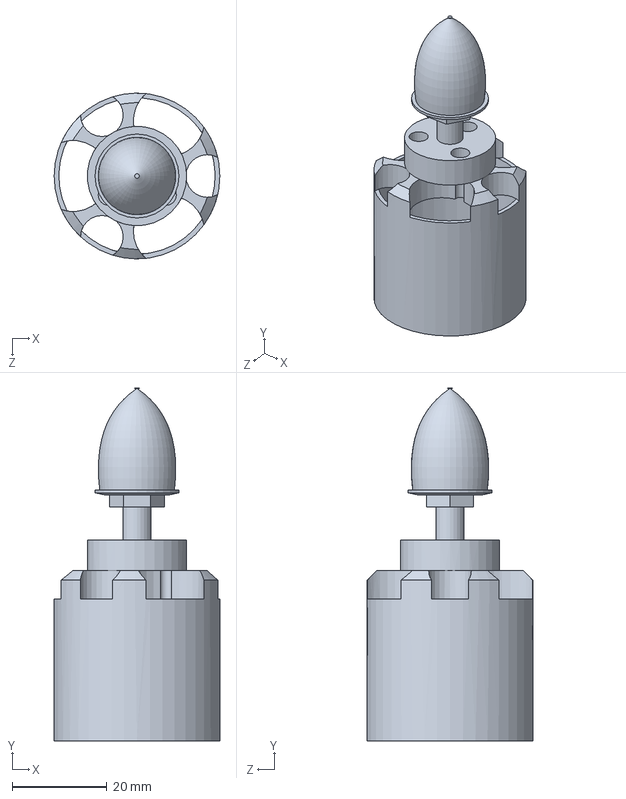
[picture p121: CAD file, 2024-07-01]
KTR TASARIM/İHA 2/motor.SLDPRT
35.0 x 74.6 x 35.0 mm
