TheDenizhan/-HA-TEKNOFEST/KTR TASARIM/İHA TASARIM/su tankı 2.SLDPRT

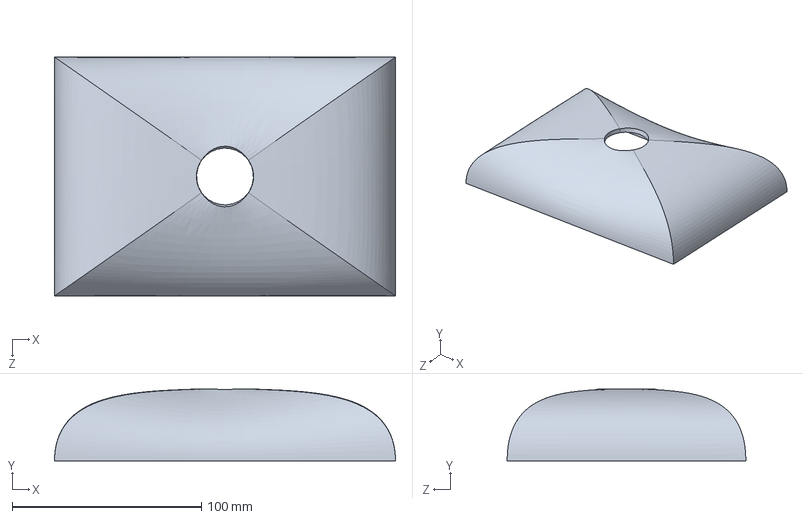
[picture p122: CAD file, 2024-07-01]
KTR TASARIM/İHA TASARIM/su tankı 2.SLDPRT
180.0 x 38.0 x 126.0 mm
