TheDenizhan/-HA-TEKNOFEST/KTR TASARIM/İHA TASARIM/mil.SLDPRT

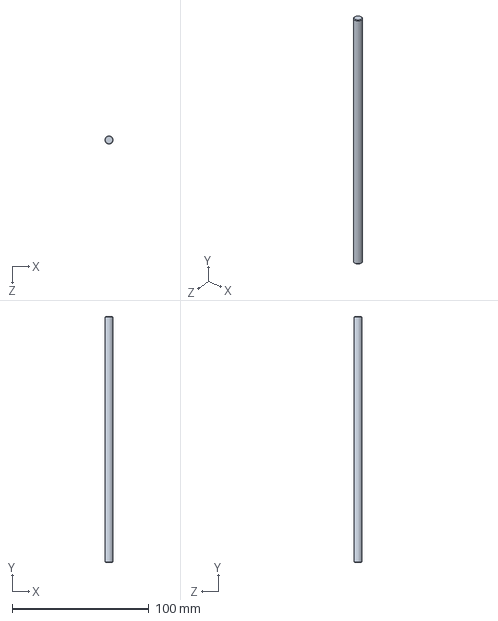
[picture p123: CAD file, 2024-07-01]
KTR TASARIM/İHA TASARIM/mil.SLDPRT
6.00 x 180.0 x 6.00 mm
