TheDenizhan/-HA-TEKNOFEST/KTR TASARIM/İHA TASARIM/sb tutamaç.SLDPRT

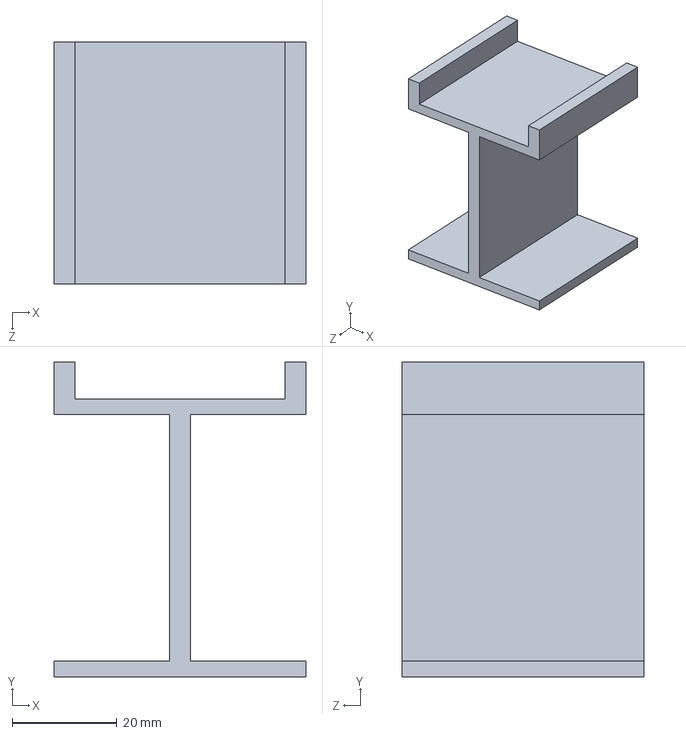
[picture p124: CAD file, 2024-07-01]
KTR TASARIM/İHA TASARIM/sb tutamaç.SLDPRT
48.0 x 60.0 x 46.1 mm
