TheDenizhan/-HA-TEKNOFEST/KTR TASARIM/İHA 2/ayak.SLDPRT

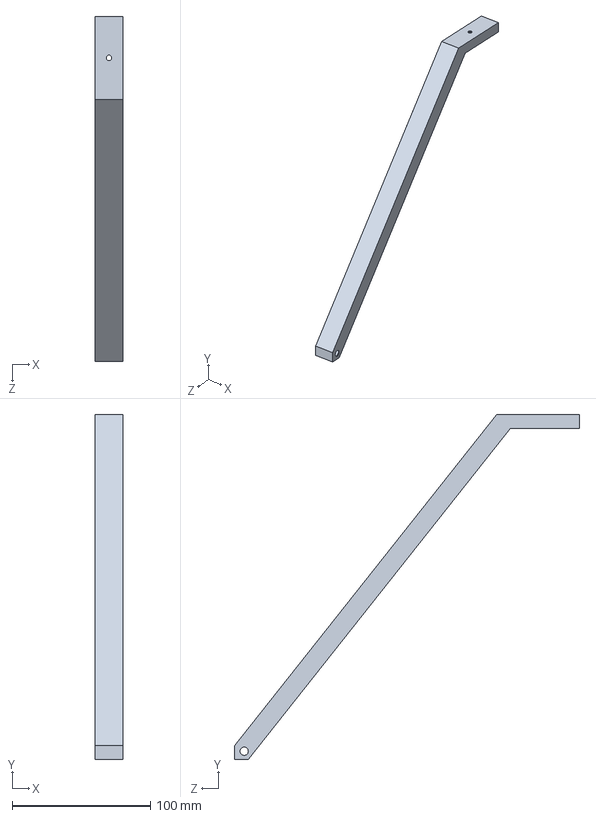
[picture p125: CAD file, 2024-07-01]
KTR TASARIM/İHA 2/ayak.SLDPRT
20.0 x 250.0 x 250.0 mm
