TheDenizhan/-HA-TEKNOFEST/KTR TASARIM/İHA 2/KOL.SLDPRT

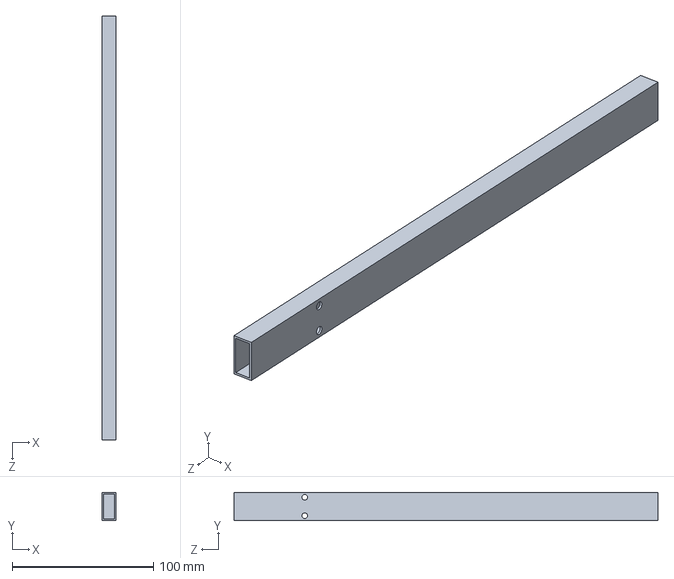
[picture p126: CAD file, 2024-07-01]
KTR TASARIM/İHA 2/KOL.SLDPRT
10.0 x 20.0 x 300.0 mm
