TheDenizhan/-HA-TEKNOFEST/KTR TASARIM/İHA 2/Parça1.SLDPRT

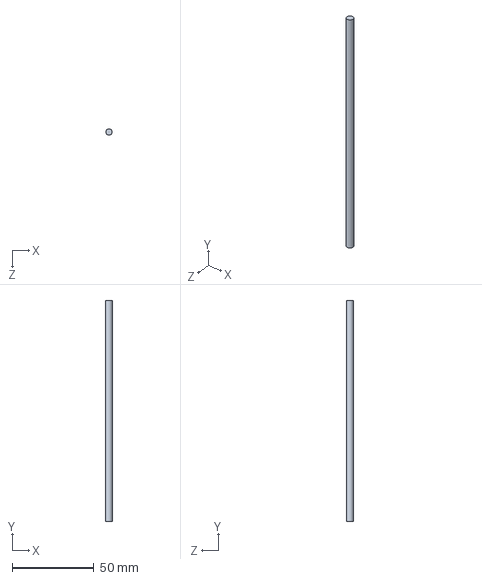
[picture p127: CAD file, 2024-07-01]
KTR TASARIM/İHA 2/Parça1.SLDPRT
4.00 x 135.0 x 4.00 mm
