TheDenizhan/-HA-TEKNOFEST/KTR TASARIM/İHA 2/ayaklık.SLDPRT

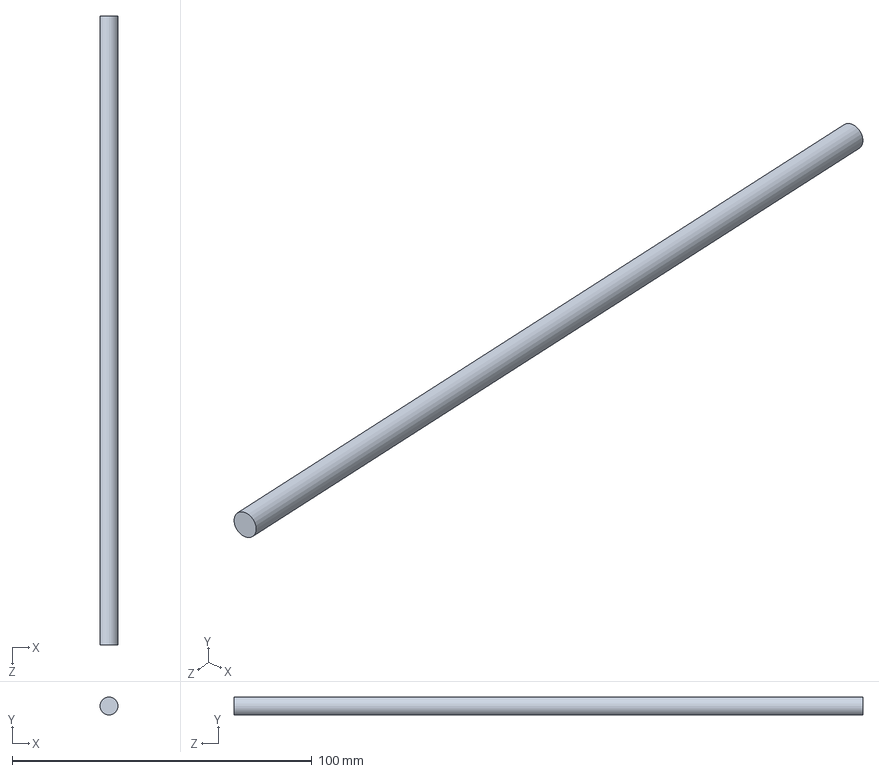
[picture p128: CAD file, 2024-07-01]
KTR TASARIM/İHA 2/ayaklık.SLDPRT
6.00 x 6.00 x 210.0 mm
