TheDenizhan/-HA-TEKNOFEST/KTR TASARIM/İHA 2/Parça3.SLDPRT

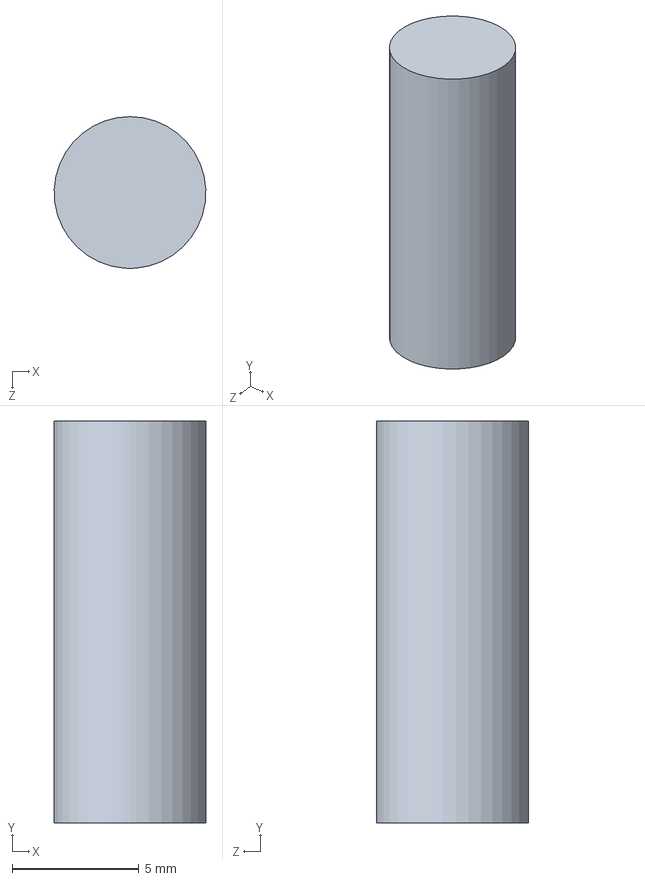
[picture p129: CAD file, 2024-07-01]
KTR TASARIM/İHA 2/Parça3.SLDPRT
5.99 x 15.9 x 6.00 mm
