TheDenizhan/-HA-TEKNOFEST/KTR TASARIM/İHA 2/PİL YATAĞI.SLDPRT

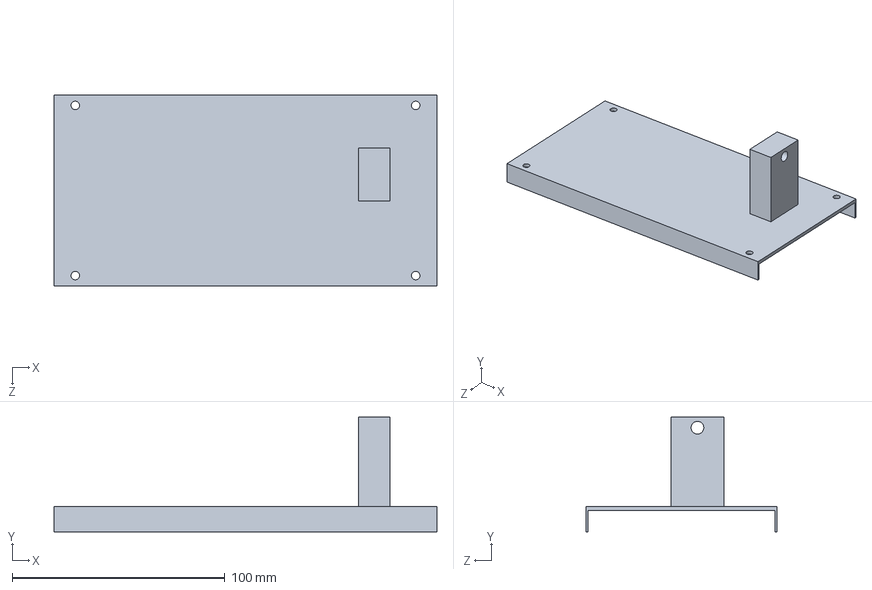
[picture p130: CAD file, 2024-07-01]
KTR TASARIM/İHA 2/PİL YATAĞI.SLDPRT
180.0 x 54.0 x 90.0 mm
