TheDenizhan/-HA-TEKNOFEST/(list of files, cad)

Other CAD files:
KTR TASARIM/İHA 2/Microphone plug assembly.STEP.SLDASM
KTR TASARIM/İHA 2/SIL_Socket08_.step.SLDASM
KTR TASARIM/İHA TASARIM/Raspberry Pi Zero 2 W.STEP.SLDASM
KTR TASARIM/İHA 2/Display connector assembly.STEP.SLDASM
KTR TASARIM/İHA 2/Display connector assembly-1.STEP.SLDASM
KTR TASARIM/İHA 2/Card slot assembly.STEP.SLDASM
KTR TASARIM/İHA TASARIM/KOLLAR.SLDPRT
KTR TASARIM/İHA 2/part 3 v1.STEP.SLDPRT
KTR TASARIM/İHA 2/GPS MOD_L_ _SKELET_.STEP.SLDPRT
KTR TASARIM/İHA TASARIM/SMD Inductor, Configurable, Raspberry Pi Zero 2 W_L2.STEP.SLDPRT
KTR TASARIM/İHA TASARIM/MicroUSB Port, Raspberry Pi Zero 2 W.STEP.SLDPRT
KTR TASARIM/İHA 2/11.0 Female micro HDMI connector.STEP.SLDPRT
KTR TASARIM/İHA 2/2.0. PIN HEADER one.STEP.SLDPRT
KTR TASARIM/İHA TASARIM/Mini HDMI Receptacle Port, Raspberry Pi Zero 2 W.STEP.SLDPRT
KTR TASARIM/İHA 2/part 4 microphone plug.STEP.SLDPRT
KTR TASARIM/İHA TASARIM/PAM2306AYPKE, Switching Voltage Regulators Dual PWM Step-Down 40uA 1A 1.5MHz, Raspberry Pi Zero 2 W.STEP.SLDPRT
KTR TASARIM/İHA 2/4.0 metal plate..STEP.SLDPRT
KTR TASARIM/İHA TASARIM/SMD Resistor, Configurable, Raspberry Pi Zero 2 W_R1.STEP.SLDPRT
KTR TASARIM/İHA 2/8.0 Gigabit Ethernet Transceiver.STEP.SLDPRT
KTR TASARIM/İHA TASARIM/SMD Capacitor, Configurable, Raspberry Pi Zero 2 W_C3.STEP.SLDPRT
KTR TASARIM/İHA 2/S2NH chip.step.SLDPRT
KTR TASARIM/İHA TASARIM/SD Card Slot, Raspberry Pi Zero 2 W.STEP.SLDPRT
KTR TASARIM/İHA 2/part 2 microphon plug metal.STEP.SLDPRT
KTR TASARIM/İHA 2/Microphone plug part 1.STEP.SLDPRT
KTR TASARIM/İHA TASARIM/Crystal Resonator, Raspberry Pi Zero 2 W.STEP.SLDPRT
KTR TASARIM/İHA 2/SIL_SocketPin.step.SLDPRT
KTR TASARIM/İHA 2/Component1.step.SLDPRT
KTR TASARIM/İHA 2/9.0 VLI PCIe USB 3.0 Controller v1.STEP.SLDPRT
KTR TASARIM/İHA 2/2.2 part 2 with combine.STEP.SLDPRT
KTR TASARIM/İHA TASARIM/RT9081A-1BGQZA, Fixed LDO Voltage Regulator, 0.8V-5.5Vin, 140mV drop, 1.25Vout, 0.5Aout, Raspberry Pi Zero 2 W_default.STEP.SLDPRT
KTR TASARIM/İHA 2/12.0 Gigabit ethernet port raspberry.STEP.SLDPRT
KTR TASARIM/İHA TASARIM/SMD Inductor, Configurable, Raspberry Pi Zero 2 W_L1.STEP.SLDPRT
KTR TASARIM/İHA 2/5.0 CPU Broadcom.STEP.SLDPRT
KTR TASARIM/İHA TASARIM/SMD Resistor, Configurable, Raspberry Pi Zero 2 W_R12.STEP.SLDPRT
KTR TASARIM/İHA 2/15.0 2x USB 2.0 PORT.STEP.SLDPRT
KTR TASARIM/İHA TASARIM/PCB, Raspberry Pi Zero 2 W.STEP.SLDPRT
KTR TASARIM/İHA 2/3.3 plastic.STEP.SLDPRT
KTR TASARIM/İHA TASARIM/SMD Capacitor, Configurable, Raspberry Pi Zero 2 W_C10.STEP.SLDPRT
KTR TASARIM/İHA TASARIM/Diode, Schottky, Raspberry Pi Zero 2 W.STEP.SLDPRT
KTR TASARIM/İHA 2/Resistor small black.step.SLDPRT
KTR TASARIM/İHA 2/Longruner LKY61 MG90 Servo.step.SLDPRT
KTR TASARIM/İHA 2/Resistor small.step.SLDPRT
KTR TASARIM/İHA TASARIM/RT8088AWSC, IC Reg Buck Prog 3A Sync 15WLCSP, Raspberry Pi Zero 2 W_default.STEP.SLDPRT
KTR TASARIM/İHA 2/3.0 PIN HEADER 20.STEP.SLDPRT
KTR TASARIM/İHA TASARIM/SMD Capacitor, Configurable, Raspberry Pi Zero 2 W_C2.STEP.SLDPRT
KTR TASARIM/İHA 2/Base.step.SLDPRT
KTR TASARIM/İHA TASARIM/pervane1.SLDPRT
KTR TASARIM/İHA 2/10.0 Female USB connector.STEP.SLDPRT
KTR TASARIM/İHA TASARIM/RP3A0-AU 2105 201221C, Raspberry Pi Zero 2 W.STEP.SLDPRT
KTR TASARIM/İHA 2/Small LED.step.SLDPRT
KTR TASARIM/İHA TASARIM/Wireless Module Cover, Raspberry Pi Zero 2 W.STEP.SLDPRT
KTR TASARIM/İHA TASARIM/LED, Raspberry Pi Zero 2 W.STEP.SLDPRT
KTR TASARIM/İHA 2/SU TANKI.SLDPRT
KTR TASARIM/İHA TASARIM/SMD Capacitor, Configurable, Raspberry Pi Zero 2 W_C1.STEP.SLDPRT
KTR TASARIM/İHA 2/GPS M8N.STEP.SLDPRT
KTR TASARIM/İHA 2/card slot part 2 metal pin.STEP.SLDPRT
KTR TASARIM/İHA 2/1.0 Plate raspberry Pi 4.STEP.SLDPRT
KTR TASARIM/İHA 2/pin header.step.SLDPRT
KTR TASARIM/İHA 2/Resistor black.step.SLDPRT
KTR TASARIM/İHA 2/7.0 MxL.STEP.SLDPRT
KTR TASARIM/İHA 2/14.0 2x USB 3.0 PORT.STEP.SLDPRT
KTR TASARIM/İHA 2/9.0 VLI PCIe USB 3.0 Controller.STEP.SLDPRT
KTR TASARIM/İHA 2/sensor chip.step.SLDPRT
KTR TASARIM/İHA 2/SIL_Socket_Body.step.SLDPRT
KTR TASARIM/İHA 2/6.0 9FD77 D9WHV.STEP.SLDPRT
KTR TASARIM/İHA 2/1.1 part 1 metal pin.STEP.SLDPRT
KTR TASARIM/İHA 2/part 3 microphone plug.STEP.SLDPRT
KTR TASARIM/İHA 2/sd card slot v1.STEP.SLDPRT
KTR TASARIM/İHA 2/SU TANKI.STL
KTR TASARIM/İHA TASARIM/54548-2271, 22 Pin FPC Connector, Raspberry Pi Zero 2 W.STEP.SLDPRT
