TheDenizhan/-HA-TEKNOFEST/STM32_Project/005-ESC-Protocol/005-ESC-Protocol.ioc

Mcu.UserName=STM32F407VGTx
PA0-WKUP.Signal=S_TIM5_CH1
PA1.Signal=S_TIM5_CH2
PA2.Signal=S_TIM5_CH3
PA3.Signal=S_TIM5_CH4
PB1.GPIO_Label=BUZZER_TIM3_CH4
PB1.Signal=S_TIM3_CH4
PC10.GPIO_Label=GPS_UART4_TX
PC10.Signal=UART4_TX
PC11.GPIO_Label=GPS_UART4_RX
PC11.Signal=UART4_RX
PC12.Signal=UART5_TX
PC6.GPIO_Label=TELEMETRI_USART6_TX
PC6.Signal=USART6_TX
PC7.GPIO_Label=TELEMETRI_USART6_RX
PC7.Signal=USART6_RX
PD14.Signal=GPIO_Output
PD2.Signal=UART5_RX
PH0-OSC_IN.Signal=RCC_OSC_IN
PH1-OSC_OUT.Signal=RCC_OSC_OUT
