TheDenizhan/-HA-TEKNOFEST/STM32_Project/003-mppu6050-v2/Core/Src/main.c

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
/* Includes ------------------------------------------------------------------*/
#include "main.h"

/* USER CODE BEGIN Includes */


#include "mpu6050.h"
#include <math.h>
#include <string.h>
#include <stdio.h>
#include "MadgwickAHRS.h"
double   temperature=0;
char     datax[120];
unsigned long last_read_time;
double         last_x_angle;  // These are the filtered angles
double         last_y_angle;
double         last_z_angle;

void set_last_read_angle_data(unsigned long time, double x, double y, double z) {
  last_read_time = time;
  last_x_angle = x;
  last_y_angle = y;
  last_z_angle = z;
}

inline unsigned long get_last_time() {return last_read_time;}
inline double get_last_x_angle() {return last_x_angle;}
inline double get_last_y_angle() {return last_y_angle;}
inline double get_last_z_angle() {return last_z_angle;}

double    base_x_gyro = 0;
double    base_y_gyro = 0;
double    base_z_gyro = 0;
/* USER CODE END Includes */

 I2C_HandleTypeDef hi2c2;

/* USER CODE BEGIN PV */
 MPU6050_t MPU6050;

/* USER CODE END PV */

void SystemClock_Config(void);
static void MX_GPIO_Init(void);
static void MX_I2C2_Init(void);
/* USER CODE BEGIN 0 */
uint8_t check = 1;
uint8_t data[16];
char str[16];

/* USER CODE END 0 */

/**
  * @brief  The application entry point.
  * @retval int
  */
int main(void)
{
  /* MCU Configuration--------------------------------------------------------*/

  /* Reset of all peripherals, Initializes the Flash interface and the Systick. */
  HAL_Init();

  /* Configure the system clock */
  SystemClock_Config();

  /* Initialize all configured peripherals */
  MX_GPIO_Init();
  MX_I2C2_Init();
  /* USER CODE BEGIN 2 */
  double angle_x;
  double angle_y;
  /* USER CODE END 2 */

  /* Infinite loop */
  /* USER CODE BEGIN WHILE */
  check = MPU6050_Init(&hi2c2);

    itoa(check, str, 10);
    //set_last_read_angle_data(1, 0, 0, 0);
  while (1)
  {//mppu6050
    /* USER CODE END WHILE */
	  MPU6050_Read_All(&hi2c2, &MPU6050);
	 //	  angle_x = MPU6050.KalmanAngleX;
	 //	  angle_y = MPU6050.KalmanAngleY;

	 	  //double angle_z = MPU6050.Az;
	 	  double accel_x_raw = MPU6050.Ax;
	 	  double accel_y_raw = MPU6050.Ay;
	 	  double accel_z_raw = MPU6050.Az;

	 	  double gyro_x_raw = MPU6050.Gx;
	 	  double gyro_y_raw = MPU6050.Gy;
	 	  double gyro_z_raw = MPU6050.Gz;
	 	 MadgwickAHRSupdateIMU(gyro_x_raw, gyro_y_raw, gyro_z_raw, accel_x_raw, accel_y_raw, accel_z_raw);

    /* USER CODE BEGIN 3 */
  }
  /* USER CODE END 3 */
}

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
