TheDenizhan/-HA-TEKNOFEST/STM32_Project/004.3-I-BUS_Fail_Safe/Core/Inc/main.h

#define BUZZER_TIM3_CH4_Pin LL_GPIO_PIN_1
#define BUZZER_TIM3_CH4_GPIO_Port GPIOB
#define TELEMETRI_USART6_TX_Pin LL_GPIO_PIN_6
#define TELEMETRI_USART6_TX_GPIO_Port GPIOC
#define TELEMETRI_USART6_RX_Pin LL_GPIO_PIN_7
#define TELEMETRI_USART6_RX_GPIO_Port GPIOC
#define GPS_UART4_TX_Pin LL_GPIO_PIN_10
#define GPS_UART4_TX_GPIO_Port GPIOC
#define GPS_UART4_RX_Pin LL_GPIO_PIN_11
#define GPS_UART4_RX_GPIO_Port GPIOC
