TheDenizhan/-HA-TEKNOFEST/STM32_Project/004.3-I-BUS_Fail_Safe/Core/Inc/M8N.h

#ifndef __M8N_H
#define __M8N_H

#ifdef __cplusplus
extern "C" {
#endif

/* Includes ------------------------------------------------------------------*/
#include "main.h"

typedef struct _M8N_UBX_NAV_POSLLH
{
unsigned char CLASS;
unsigned char ID;
unsigned short length;

unsigned int iTOW;
signed int lon;
signed int lat;
signed int height;
signed int hMSL;
unsigned int hAcc;
unsigned int vAcc;

double lon_f64;
double lat_f64;
}M8N_UBX_NAV_POSLLH;

extern M8N_UBX_NAV_POSLLH posllh;
unsigned char M8N_UBX_CHECKSUM_Check(unsigned char* data, unsigned char len);
void M8N_UBX_NAV_POSLLH_Parsing(unsigned char* data, M8N_UBX_NAV_POSLLH* posllh);


void M8N_TransimiData(unsigned char* data, unsigned char len);
void M8N_UART4_Initialization(void);
void M8N_Initialization(void);


#ifdef __cplusplus
}
#endif

#endif /* __M8N_H */
